r3tjl/N7DDC-ATU-100-mini-and-extended-boards/(list of files, drawings)

Other design files:
ATU_100_EXT_board/ATU_100_EXT_PCB_R3TJL/ATU-100_FS-мой с кнопками.lay6
ATU_100_mini_board/ATU-100_mini_PCB.lay6
