r3tjl/N7DDC-ATU-100-mini-and-extended-boards/ATU_100_EXT_board/FirmWare_PIC16F1938/R3TJL_ 1938_EXT_board_sources_V_3.4/main.asm

_correction:

;main.h,42 :: 		int correction(int input) {
;main.h,44 :: 		if(input <= 80) return 0;
	MOVLW      128
	MOVWF      R0
	MOVLW      128
	XORWF      FARG_correction_input+1, 0
	SUBWF      R0, 0
	BTFSS      STATUS+0, 2
	GOTO       L__correction547
	MOVF       FARG_correction_input+0, 0
	SUBLW      80
L__correction547:
	BTFSS      STATUS+0, 0
	GOTO       L_correction0
	CLRF       R0
	CLRF       R1
	GOTO       L_end_correction
L_correction0:
;main.h,45 :: 		if(input <= 171) input += 244;
	MOVLW      128
	MOVWF      R0
	MOVLW      128
	XORWF      FARG_correction_input+1, 0
	SUBWF      R0, 0
	BTFSS      STATUS+0, 2
	GOTO       L__correction548
	MOVF       FARG_correction_input+0, 0
	SUBLW      171
L__correction548:
	BTFSS      STATUS+0, 0
	GOTO       L_correction1
	MOVLW      244
	ADDWF      FARG_correction_input+0, 1
	MOVLW      0
	ADDWFC     FARG_correction_input+1, 1
	GOTO       L_correction2
L_correction1:
;main.h,46 :: 		else if(input <= 328) input += 254;
	MOVLW      128
	XORLW      1
	MOVWF      R0
	MOVLW      128
	XORWF      FARG_correction_input+1, 0
	SUBWF      R0, 0
	BTFSS      STATUS+0, 2
	GOTO       L__correction549
	MOVF       FARG_correction_input+0, 0
	SUBLW      72
L__correction549:
	BTFSS      STATUS+0, 0
	GOTO       L_correction3
	MOVLW      254
	ADDWF      FARG_correction_input+0, 1
	MOVLW      0
	ADDWFC     FARG_correction_input+1, 1
	GOTO       L_correction4
L_correction3:
;main.h,47 :: 		else if(input <= 582) input += 280;
	MOVLW      128
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
	BTFSS      STATUS+0, 0
	GOTO       L_correction21
	MOVLW      32
	ADDWF      FARG_correction_input+0, 1
	MOVLW      3
	ADDWFC     FARG_correction_input+1, 1
	GOTO       L_correction22
L_correction21:
;main.h,56 :: 		else if(input <= 10500) input += 840;
	MOVLW      128
	XORLW      41
	MOVWF      R0
	MOVLW      128
	XORWF      FARG_correction_input+1, 0
	SUBWF      R0, 0
	BTFSS      STATUS+0, 2
	GOTO       L__correction559
	MOVF       FARG_correction_input+0, 0
	SUBLW      4
L__correction559:
	BTFSS      STATUS+0, 0
	GOTO       L_correction23
	MOVLW      72
	ADDWF      FARG_correction_input+0, 1
	MOVLW      3
	ADDWFC     FARG_correction_input+1, 1
	GOTO       L_correction24
L_correction23:
;main.h,57 :: 		else  input += 860;
	MOVLW      92
	ADDWF      FARG_correction_input+0, 1
	MOVLW      3
	ADDWFC     FARG_correction_input+1, 1
L_correction24:
L_correction22:
L_correction20:
L_correction18:
L_correction16:
L_correction14:
L_correction12:
L_correction10:
L_correction8:
L_correction6:
L_correction4:
L_correction2:
;main.h,59 :: 		return input;
	MOVF       FARG_correction_input+0, 0
	MOVWF      R0
	MOVF       FARG_correction_input+1, 0
	MOVWF      R1
;main.h,60 :: 		}
L_end_correction:
	RETURN
; end of _correction

_get_reverse:

;main.h,64 :: 		int get_reverse() {
;main.h,66 :: 		FVRCON = 0b10000001; // ADC 1024 vmV Vref
	MOVLW      129
	MOVWF      FVRCON+0
;main.h,67 :: 		while(FVRCON.B6 == 0);
L_get_reverse25:
	BTFSC      FVRCON+0, 6
	GOTO       L_get_reverse26
	GOTO       L_get_reverse25
L_get_reverse26:
;main.h,68 :: 		Reverse = ADC_Get_Sample(0);
	CLRF       FARG_ADC_Get_Sample_channel+0
	CALL       _ADC_Get_Sample+0
	MOVF       R0, 0
	MOVWF      get_reverse_Reverse_L0+0
	MOVF       R1, 0
	MOVWF      get_reverse_Reverse_L0+1
;main.h,69 :: 		if(Reverse <= 1000) return Reverse;
	MOVLW      128
	XORLW      3
	MOVWF      R2
	MOVLW      128
	XORWF      R1, 0
	SUBWF      R2, 0
	BTFSS      STATUS+0, 2
	GOTO       L__get_reverse561
	MOVF       R0, 0
	SUBLW      232
L__get_reverse561:
	BTFSS      STATUS+0, 0
	GOTO       L_get_reverse27
	MOVF       get_reverse_Reverse_L0+0, 0
	MOVWF      R0
	MOVF       get_reverse_Reverse_L0+1, 0
	MOVWF      R1
	GOTO       L_end_get_reverse
L_get_reverse27:
;main.h,70 :: 		FVRCON = 0b10000010; // ADC 2048 vmV Vref
	MOVLW      130
	MOVWF      FVRCON+0
;main.h,71 :: 		while(FVRCON.B6 == 0);
L_get_reverse28:
	BTFSC      FVRCON+0, 6
	GOTO       L_get_reverse29
	GOTO       L_get_reverse28
L_get_reverse29:
;main.h,72 :: 		Reverse = ADC_Get_Sample(0);
	CLRF       FARG_ADC_Get_Sample_channel+0
	CALL       _ADC_Get_Sample+0
	MOVF       R0, 0
	MOVWF      get_reverse_Reverse_L0+0
	MOVF       R1, 0
	MOVWF      get_reverse_Reverse_L0+1
;main.h,73 :: 		if(Reverse <= 1000) return Reverse * 2;
	MOVLW      128
	XORLW      3
	MOVWF      R2
	MOVLW      128
	XORWF      R1, 0
	SUBWF      R2, 0
	BTFSS      STATUS+0, 2
	GOTO       L__get_reverse562
	MOVF       R0, 0
	SUBLW      232
L__get_reverse562:
	BTFSS      STATUS+0, 0
	GOTO       L_get_reverse30
	MOVF       get_reverse_Reverse_L0+0, 0
	MOVWF      R0
	MOVF       get_reverse_Reverse_L0+1, 0
	MOVWF      R1
	LSLF       R0, 1
	RLF        R1, 1
	GOTO       L_end_get_reverse
L_get_reverse30:
;main.h,74 :: 		FVRCON = 0b10000011; // ADC 4096 vmV Vref
	MOVLW      131
	MOVWF      FVRCON+0
;main.h,75 :: 		while(FVRCON.B6 == 0);
L_get_reverse31:
	BTFSC      FVRCON+0, 6
	GOTO       L_get_reverse32
	GOTO       L_get_reverse31
L_get_reverse32:
;main.h,76 :: 		Reverse = ADC_Get_Sample(0);
	CLRF       FARG_ADC_Get_Sample_channel+0
	CALL       _ADC_Get_Sample+0
	MOVF       R0, 0
	MOVWF      get_reverse_Reverse_L0+0
	MOVF       R1, 0
	MOVWF      get_reverse_Reverse_L0+1
;main.h,77 :: 		return Reverse * 4;
	MOVF       R0, 0
	MOVWF      R2
	MOVF       R1, 0
	MOVWF      R3
	LSLF       R2, 1
	RLF        R3, 1
	LSLF       R2, 1
	RLF        R3, 1
	MOVF       R2, 0
	MOVWF      R0
	MOVF       R3, 0
	MOVWF      R1
;main.h,78 :: 		}
L_end_get_reverse:
	RETURN
; end of _get_reverse

_get_forward:

;main.h,81 :: 		int get_forward() {
;main.h,83 :: 		FVRCON = 0b10000001; // ADC 1024 vmV Vref
	MOVLW      129
	MOVWF      FVRCON+0
;main.h,84 :: 		while(FVRCON.B6 == 0);
L_get_forward33:
	BTFSC      FVRCON+0, 6
	GOTO       L_get_forward34
	GOTO       L_get_forward33
L_get_forward34:
;main.h,85 :: 		Forward = ADC_Get_Sample(1);
	MOVLW      1
	MOVWF      FARG_ADC_Get_Sample_channel+0
	CALL       _ADC_Get_Sample+0
	MOVF       R0, 0
	MOVWF      get_forward_Forward_L0+0
	MOVF       R1, 0
	MOVWF      get_forward_Forward_L0+1
;main.h,86 :: 		if(Forward <= 1000) return Forward;
	MOVLW      128
	XORLW      3
	MOVWF      R2
	MOVLW      128
	XORWF      R1, 0
	SUBWF      R2, 0
	BTFSS      STATUS+0, 2
	GOTO       L__get_forward564
	MOVF       R0, 0
	SUBLW      232
L__get_forward564:
	BTFSS      STATUS+0, 0
	GOTO       L_get_forward35
	MOVF       get_forward_Forward_L0+0, 0
	MOVWF      R0
	MOVF       get_forward_Forward_L0+1, 0
	MOVWF      R1
	GOTO       L_end_get_forward
L_get_forward35:
;main.h,87 :: 		FVRCON = 0b10000010; // ADC 2048 vmV Vref
	MOVLW      130
	MOVWF      FVRCON+0
;main.h,88 :: 		while(FVRCON.B6 == 0);
L_get_forward36:
	BTFSC      FVRCON+0, 6
	GOTO       L_get_forward37
	GOTO       L_get_forward36
L_get_forward37:
;main.h,89 :: 		Forward = ADC_Get_Sample(1);
	MOVLW      1
	MOVWF      FARG_ADC_Get_Sample_channel+0
	CALL       _ADC_Get_Sample+0
	MOVF       R0, 0
	MOVWF      get_forward_Forward_L0+0
	MOVF       R1, 0
	MOVWF      get_forward_Forward_L0+1
;main.h,90 :: 		if(Forward <= 1000) return Forward * 2;
	MOVLW      128
	XORLW      3
	MOVWF      R2
	MOVLW      128
	XORWF      R1, 0
	SUBWF      R2, 0
	BTFSS      STATUS+0, 2
	GOTO       L__get_forward565
	MOVF       R0, 0
	SUBLW      232
L__get_forward565:
	BTFSS      STATUS+0, 0
	GOTO       L_get_forward38
	MOVF       get_forward_Forward_L0+0, 0
	MOVWF      R0
	MOVF       get_forward_Forward_L0+1, 0
	MOVWF      R1
	LSLF       R0, 1
	RLF        R1, 1
	GOTO       L_end_get_forward
L_get_forward38:
;main.h,91 :: 		FVRCON = 0b10000011; // ADC 4096 vmV Vref
	MOVLW      131
	MOVWF      FVRCON+0
;main.h,92 :: 		while(FVRCON.B6 == 0);
L_get_forward39:
	BTFSC      FVRCON+0, 6
	GOTO       L_get_forward40
	GOTO       L_get_forward39
L_get_forward40:
;main.h,93 :: 		Forward = ADC_Get_Sample(1);
	MOVLW      1
	MOVWF      FARG_ADC_Get_Sample_channel+0
	CALL       _ADC_Get_Sample+0
	MOVF       R0, 0
	MOVWF      get_forward_Forward_L0+0
	MOVF       R1, 0
	MOVWF      get_forward_Forward_L0+1
;main.h,94 :: 		if(Forward == 1024) Overload = 1;
	MOVF       R1, 0
	XORLW      4
	BTFSS      STATUS+0, 2
	GOTO       L__get_forward566
	MOVLW      0
	XORWF      R0, 0
L__get_forward566:
	BTFSS      STATUS+0, 2
	GOTO       L_get_forward41
	MOVLW      1
	MOVWF      main_Overload+0
	GOTO       L_get_forward42
L_get_forward41:
;main.h,95 :: 		else Overload = 0;
	CLRF       main_Overload+0
L_get_forward42:
;main.h,96 :: 		return Forward * 4;
	MOVF       get_forward_Forward_L0+0, 0
	MOVWF      R0
	MOVF       get_forward_Forward_L0+1, 0
	MOVWF      R1
	LSLF       R0, 1
	RLF        R1, 1
	LSLF       R0, 1
	RLF        R1, 1
;main.h,97 :: 		}
L_end_get_forward:
	RETURN
; end of _get_forward

_get_pwr:

;main.h,99 :: 		void get_pwr() {
;main.h,102 :: 		asm CLRWDT;
	CLRWDT
;main.h,104 :: 		Forward = get_forward();
	CALL       _get_forward+0
	MOVF       R0, 0
	MOVWF      get_pwr_Forward_L0+0
	MOVF       R1, 0
	MOVWF      get_pwr_Forward_L0+1
	MOVLW      0
	BTFSC      get_pwr_Forward_L0+1, 7
	MOVLW      255
	MOVWF      get_pwr_Forward_L0+2
	MOVWF      get_pwr_Forward_L0+3
;main.h,105 :: 		Reverse = get_reverse();
	CALL       _get_reverse+0
	MOVF       R0, 0
	MOVWF      get_pwr_Reverse_L0+0
	MOVF       R1, 0
	MOVWF      get_pwr_Reverse_L0+1
	MOVLW      0
	BTFSC      get_pwr_Reverse_L0+1, 7
	MOVLW      255
	MOVWF      get_pwr_Reverse_L0+2
	MOVWF      get_pwr_Reverse_L0+3
;main.h,106 :: 		if(D_correction==1) p = correction(Forward * 3);
	MOVF       main_D_correction+0, 0
	XORLW      1
	BTFSS      STATUS+0, 2
	GOTO       L_get_pwr43
	MOVF       get_pwr_Forward_L0+0, 0
	MOVWF      R0
	MOVF       get_pwr_Forward_L0+1, 0
	MOVWF      R1
	MOVLW      3
	MOVWF      R4
	MOVLW      0
	MOVWF      R5
	CALL       _Mul_16x16_U+0
	MOVF       R0, 0
	MOVWF      FARG_correction_input+0
	MOVF       R1, 0
	MOVWF      FARG_correction_input+1
	CALL       _correction+0
	CALL       _Int2Double+0
	MOVF       R0, 0
	MOVWF      get_pwr_p_L0+0
	MOVF       R1, 0
	MOVWF      get_pwr_p_L0+1
	MOVF       R2, 0
	MOVWF      get_pwr_p_L0+2
	MOVF       R3, 0
	MOVWF      get_pwr_p_L0+3
	GOTO       L_get_pwr44
L_get_pwr43:
;main.h,107 :: 		else p = Forward * 3;
	MOVF       get_pwr_Forward_L0+0, 0
	MOVWF      R0
	MOVF       get_pwr_Forward_L0+1, 0
	MOVWF      R1
	MOVF       get_pwr_Forward_L0+2, 0
	MOVWF      R2
	MOVF       get_pwr_Forward_L0+3, 0
	MOVWF      R3
	MOVLW      3
	MOVWF      R4
	CLRF       R5
	CLRF       R6
	CLRF       R7
	CALL       _Mul_32x32_U+0
	CALL       _Longint2Double+0
	MOVF       R0, 0
	MOVWF      get_pwr_p_L0+0
	MOVF       R1, 0
	MOVWF      get_pwr_p_L0+1
	MOVF       R2, 0
	MOVWF      get_pwr_p_L0+2
	MOVF       R3, 0
	MOVWF      get_pwr_p_L0+3
L_get_pwr44:
;main.h,109 :: 		if(Reverse >= Forward)
	MOVLW      128
	XORWF      get_pwr_Reverse_L0+3, 0
	MOVWF      R0
	MOVLW      128
	XORWF      get_pwr_Forward_L0+3, 0
	SUBWF      R0, 0
	BTFSS      STATUS+0, 2
	GOTO       L__get_pwr568
	MOVF       get_pwr_Forward_L0+2, 0
	SUBWF      get_pwr_Reverse_L0+2, 0
	BTFSS      STATUS+0, 2
	GOTO       L__get_pwr568
	MOVF       get_pwr_Forward_L0+1, 0
	SUBWF      get_pwr_Reverse_L0+1, 0
	BTFSS      STATUS+0, 2
	GOTO       L__get_pwr568
	MOVF       get_pwr_Forward_L0+0, 0
	SUBWF      get_pwr_Reverse_L0+0, 0
L__get_pwr568:
	BTFSS      STATUS+0, 0
	GOTO       L_get_pwr45
;main.h,110 :: 		Forward = 999;
	MOVLW      231
	MOVWF      get_pwr_Forward_L0+0
	MOVLW      3
	MOVWF      get_pwr_Forward_L0+1
	CLRF       get_pwr_Forward_L0+2
	CLRF       get_pwr_Forward_L0+3
	GOTO       L_get_pwr46
L_get_pwr45:
;main.h,112 :: 		Forward = ((Forward + Reverse) * 100) / (Forward - Reverse);
	MOVF       get_pwr_Reverse_L0+0, 0
	ADDWF      get_pwr_Forward_L0+0, 0
	MOVWF      R0
	MOVF       get_pwr_Reverse_L0+1, 0
	ADDWFC     get_pwr_Forward_L0+1, 0
	MOVWF      R1
	MOVF       get_pwr_Reverse_L0+2, 0
	ADDWFC     get_pwr_Forward_L0+2, 0
	MOVWF      R2
	MOVF       get_pwr_Reverse_L0+3, 0
	ADDWFC     get_pwr_Forward_L0+3, 0
	MOVWF      R3
	MOVLW      100
	MOVWF      R4
	CLRF       R5
	CLRF       R6
	CLRF       R7
	CALL       _Mul_32x32_U+0
	MOVF       get_pwr_Forward_L0+0, 0
	MOVWF      R4
	MOVF       get_pwr_Forward_L0+1, 0
	MOVWF      R5
	MOVF       get_pwr_Forward_L0+2, 0
	MOVWF      R6
	MOVF       get_pwr_Forward_L0+3, 0
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
	MOVWF      R7
	CALL       _Add_32x32_FP+0
	MOVF       R0, 0
	MOVWF      get_pwr_p_L0+0
	MOVF       R1, 0
	MOVWF      get_pwr_p_L0+1
	MOVF       R2, 0
	MOVWF      get_pwr_p_L0+2
	MOVF       R3, 0
	MOVWF      get_pwr_p_L0+3
;main.h,122 :: 		PWR = p;
	CALL       _Double2Int+0
	MOVF       R0, 0
	MOVWF      _PWR+0
	MOVF       R1, 0
	MOVWF      _PWR+1
;main.h,123 :: 		if(PWR<10) SWR = 1;
	MOVLW      128
	XORWF      R1, 0
	MOVWF      R2
	MOVLW      128
	SUBWF      R2, 0
	BTFSS      STATUS+0, 2
	GOTO       L__get_pwr570
	MOVLW      10
	SUBWF      R0, 0
L__get_pwr570:
	BTFSC      STATUS+0, 0
	GOTO       L_get_pwr50
	MOVLW      1
	MOVWF      _SWR+0
	MOVLW      0
	MOVWF      _SWR+1
	GOTO       L_get_pwr51
L_get_pwr50:
;main.h,124 :: 		else if(Forward<100) SWR = 999;
	MOVLW      128
	XORWF      get_pwr_Forward_L0+3, 0
	MOVWF      R0
	MOVLW      128
	SUBWF      R0, 0
	BTFSS      STATUS+0, 2
	GOTO       L__get_pwr571
	MOVLW      0
	SUBWF      get_pwr_Forward_L0+2, 0
	BTFSS      STATUS+0, 2
	GOTO       L__get_pwr571
	MOVLW      0
	SUBWF      get_pwr_Forward_L0+1, 0
	BTFSS      STATUS+0, 2
	GOTO       L__get_pwr571
	MOVLW      100
	SUBWF      get_pwr_Forward_L0+0, 0
L__get_pwr571:
	BTFSC      STATUS+0, 0
	GOTO       L_get_pwr52
	MOVLW      231
	MOVWF      _SWR+0
	MOVLW      3
	MOVWF      _SWR+1
	GOTO       L_get_pwr53
L_get_pwr52:
;main.h,125 :: 		else SWR = Forward;
	MOVF       get_pwr_Forward_L0+0, 0
	MOVWF      _SWR+0
	MOVF       get_pwr_Forward_L0+1, 0
	MOVWF      _SWR+1
L_get_pwr53:
L_get_pwr51:
;main.h,126 :: 		return;
;main.h,127 :: 		}
L_end_get_pwr:
	RETURN
; end of _get_pwr

_get_swr:

;main.h,129 :: 		void get_swr() {
;main.h,130 :: 		get_pwr();
	CALL       _get_pwr+0
;main.h,131 :: 		if(p_cnt!=100) {
	MOVF       _p_cnt+0, 0
	XORLW      100
	BTFSC      STATUS+0, 2
	GOTO       L_get_swr54
;main.h,132 :: 		p_cnt += 1;
	INCF       _p_cnt+0, 1
;main.h,133 :: 		if(PWR>P_max) P_max = PWR;
	MOVLW      128
	XORWF      _P_max+1, 0
	MOVWF      R0
	MOVLW      128
	XORWF      _PWR+1, 0
	SUBWF      R0, 0
	BTFSS      STATUS+0, 2
	GOTO       L__get_swr573
	MOVF       _PWR+0, 0
	SUBWF      _P_max+0, 0
L__get_swr573:
	BTFSC      STATUS+0, 0
	GOTO       L_get_swr55
	MOVF       _PWR+0, 0
	MOVWF      _P_max+0
	MOVF       _PWR+1, 0
	MOVWF      _P_max+1
L_get_swr55:
;main.h,134 :: 		}
	GOTO       L_get_swr56
L_get_swr54:
;main.h,136 :: 		p_cnt = 0;
	CLRF       _p_cnt+0
;main.h,137 :: 		show_pwr(P_max, SWR);
	MOVF       _P_max+0, 0
	MOVWF      FARG_show_pwr+0
	MOVF       _P_max+1, 0
	MOVWF      FARG_show_pwr+1
	MOVF       _SWR+0, 0
	MOVWF      FARG_show_pwr+0
	MOVF       _SWR+1, 0
	MOVWF      FARG_show_pwr+1
	CALL       _show_pwr+0
;main.h,138 :: 		P_max = 0;
	CLRF       _P_max+0
	CLRF       _P_max+1
;main.h,139 :: 		}
L_get_swr56:
;main.h,140 :: 		while(PWR<min_for_start | (PWR> max_for_start & max_for_start>0)) {  // waiting for good power
L_get_swr57:
	MOVLW      128
	XORWF      _PWR+1, 0
	MOVWF      R2
	MOVLW      128
	XORWF      main_min_for_start+1, 0
	SUBWF      R2, 0
	BTFSS      STATUS+0, 2
	GOTO       L__get_swr574
	MOVF       main_min_for_start+0, 0
	SUBWF      _PWR+0, 0
L__get_swr574:
	MOVLW      1
	BTFSC      STATUS+0, 0
	MOVLW      0
	MOVWF      R2
	MOVLW      128
	XORWF      main_max_for_start+1, 0
	MOVWF      R1
	MOVLW      128
	XORWF      _PWR+1, 0
	SUBWF      R1, 0
	BTFSS      STATUS+0, 2
	GOTO       L__get_swr575
	MOVF       _PWR+0, 0
	SUBWF      main_max_for_start+0, 0
L__get_swr575:
	MOVLW      1
	BTFSC      STATUS+0, 0
	MOVLW      0
	MOVWF      R1
	MOVLW      128
	MOVWF      R0
	MOVLW      128
	XORWF      main_max_for_start+1, 0
	SUBWF      R0, 0
	BTFSS      STATUS+0, 2
	GOTO       L__get_swr576
	MOVF       main_max_for_start+0, 0
	SUBLW      0
L__get_swr576:
	MOVLW      1
	BTFSC      STATUS+0, 0
	MOVLW      0
	MOVWF      R0
	MOVF       R1, 0
	ANDWF      R0, 1
	MOVF       R2, 0
	IORWF       R0, 1
	BTFSC      STATUS+0, 2
	GOTO       L_get_swr58
;main.h,141 :: 		asm CLRWDT;
	CLRWDT
;main.h,142 :: 		get_pwr();
	CALL       _get_pwr+0
;main.h,143 :: 		if(p_cnt!=100) {
	MOVF       _p_cnt+0, 0
	XORLW      100
	BTFSC      STATUS+0, 2
	GOTO       L_get_swr59
;main.h,144 :: 		p_cnt += 1;
	INCF       _p_cnt+0, 1
;main.h,145 :: 		if(PWR>P_max) P_max = PWR;
	MOVLW      128
	XORWF      _P_max+1, 0
	MOVWF      R0
	MOVLW      128
	XORWF      _PWR+1, 0
	SUBWF      R0, 0
	BTFSS      STATUS+0, 2
	GOTO       L__get_swr577
	MOVF       _PWR+0, 0
	SUBWF      _P_max+0, 0
L__get_swr577:
	BTFSC      STATUS+0, 0
	GOTO       L_get_swr60
	MOVF       _PWR+0, 0
	MOVWF      _P_max+0
	MOVF       _PWR+1, 0
	MOVWF      _P_max+1
L_get_swr60:
;main.h,146 :: 		}
	GOTO       L_get_swr61
L_get_swr59:
;main.h,148 :: 		p_cnt = 0;
	CLRF       _p_cnt+0
;main.h,149 :: 		show_pwr(P_max, SWR);
	MOVF       _P_max+0, 0
	MOVWF      FARG_show_pwr+0
	MOVF       _P_max+1, 0
	MOVWF      FARG_show_pwr+1
	MOVF       _SWR+0, 0
	MOVWF      FARG_show_pwr+0
	MOVF       _SWR+1, 0
	MOVWF      FARG_show_pwr+1
	CALL       _show_pwr+0
;main.h,150 :: 		P_max = 0;
	CLRF       _P_max+0
	CLRF       _P_max+1
;main.h,151 :: 		}
L_get_swr61:
;main.h,153 :: 		if(Button(&PORTB, 0, 5, 1)) rready = 1;
	MOVLW      PORTB+0
	MOVWF      FARG_Button_port+0
	MOVLW      hi_addr(PORTB+0)
	MOVWF      FARG_Button_port+1
	CLRF       FARG_Button_pin+0
	MOVLW      5
	MOVWF      FARG_Button_time_ms+0
	MOVLW      1
	MOVWF      FARG_Button_active_state+0
	CALL       _Button+0
	MOVF       R0, 0
	BTFSC      STATUS+0, 2
	GOTO       L_get_swr62
	MOVLW      1
	MOVWF      _rready+0
L_get_swr62:
;main.h,154 :: 		if(rready==1 & Button(&PORTB, 0, 5, 0)) { //  press button  Tune
	MOVF       _rready+0, 0
	XORLW      1
	MOVLW      1
	BTFSS      STATUS+0, 2
	MOVLW      0
	MOVWF      FLOC__get_swr+0
	MOVLW      PORTB+0
	MOVWF      FARG_Button_port+0
	MOVLW      hi_addr(PORTB+0)
	MOVWF      FARG_Button_port+1
	CLRF       FARG_Button_pin+0
	MOVLW      5
	MOVWF      FARG_Button_time_ms+0
	CLRF       FARG_Button_active_state+0
	CALL       _Button+0
	MOVF       FLOC__get_swr+0, 0
	ANDWF      R0, 1
	BTFSC      STATUS+0, 2
	GOTO       L_get_swr63
;main.h,155 :: 		show_reset();
	CALL       _show_reset+0
;main.h,156 :: 		SWR = 0;
	CLRF       _SWR+0
	CLRF       _SWR+1
;main.h,157 :: 		return;
	GOTO       L_end_get_swr
;main.h,158 :: 		}
L_get_swr63:
;main.h,159 :: 		} //  good power
	GOTO       L_get_swr57
L_get_swr58:
;main.h,160 :: 		return;
;main.h,161 :: 		}
L_end_get_swr:
	RETURN
; end of _get_swr

_set_ind:

;main.h,163 :: 		void set_ind(char Ind) {  // 0 - 31
;main.h,164 :: 		if(L_invert == 0) {
	MOVF       main_L_invert+0, 0
	XORLW      0
	BTFSS      STATUS+0, 2
	GOTO       L_set_ind64
;main.h,165 :: 		Ind_005 = Ind.B0;
	BTFSC      FARG_set_ind_Ind+0, 0
	GOTO       L__set_ind579
	BCF        LATB3_bit+0, BitPos(LATB3_bit+0)
	GOTO       L__set_ind580
L__set_ind579:
	BSF        LATB3_bit+0, BitPos(LATB3_bit+0)
L__set_ind580:
;main.h,166 :: 		Ind_011 = Ind.B1;
	BTFSC      FARG_set_ind_Ind+0, 1
	GOTO       L__set_ind581
	BCF        LATA2_bit+0, BitPos(LATA2_bit+0)
	GOTO       L__set_ind582
L__set_ind581:
	BSF        LATA2_bit+0, BitPos(LATA2_bit+0)
L__set_ind582:
;main.h,167 :: 		Ind_022 = Ind.B2;
	BTFSC      FARG_set_ind_Ind+0, 2
	GOTO       L__set_ind583
	BCF        LATB4_bit+0, BitPos(LATB4_bit+0)
	GOTO       L__set_ind584
L__set_ind583:
	BSF        LATB4_bit+0, BitPos(LATB4_bit+0)
L__set_ind584:
;main.h,168 :: 		Ind_045 = Ind.B3;
	BTFSC      FARG_set_ind_Ind+0, 3
	GOTO       L__set_ind585
	BCF        LATA3_bit+0, BitPos(LATA3_bit+0)
	GOTO       L__set_ind586
L__set_ind585:
	BSF        LATA3_bit+0, BitPos(LATA3_bit+0)
L__set_ind586:
;main.h,169 :: 		Ind_1   = Ind.B4;
	BTFSC      FARG_set_ind_Ind+0, 4
	GOTO       L__set_ind587
	BCF        LATB5_bit+0, BitPos(LATB5_bit+0)
	GOTO       L__set_ind588
L__set_ind587:
	BSF        LATB5_bit+0, BitPos(LATB5_bit+0)
L__set_ind588:
;main.h,170 :: 		Ind_22  = Ind.B5;
	BTFSC      FARG_set_ind_Ind+0, 5
	GOTO       L__set_ind589
	BCF        LATA5_bit+0, BitPos(LATA5_bit+0)
	GOTO       L__set_ind590
L__set_ind589:
	BSF        LATA5_bit+0, BitPos(LATA5_bit+0)
L__set_ind590:
;main.h,171 :: 		Ind_45  = Ind.B6;
	BTFSC      FARG_set_ind_Ind+0, 6
	GOTO       L__set_ind591
	BCF        LATA4_bit+0, BitPos(LATA4_bit+0)
	GOTO       L__set_ind592
L__set_ind591:
	BSF        LATA4_bit+0, BitPos(LATA4_bit+0)
L__set_ind592:
;main.h,173 :: 		}
	GOTO       L_set_ind65
L_set_ind64:
;main.h,175 :: 		Ind_005 = ~Ind.B0;
	BTFSC      FARG_set_ind_Ind+0, 0
	GOTO       L__set_ind593
	BSF        LATB3_bit+0, BitPos(LATB3_bit+0)
	GOTO       L__set_ind594
L__set_ind593:
	BCF        LATB3_bit+0, BitPos(LATB3_bit+0)
L__set_ind594:
;main.h,176 :: 		Ind_011 = ~Ind.B1;
	BTFSC      FARG_set_ind_Ind+0, 1
	GOTO       L__set_ind595
	BSF        LATA2_bit+0, BitPos(LATA2_bit+0)
	GOTO       L__set_ind596
L__set_ind595:
	BCF        LATA2_bit+0, BitPos(LATA2_bit+0)
L__set_ind596:
;main.h,177 :: 		Ind_022 = ~Ind.B2;
	BTFSC      FARG_set_ind_Ind+0, 2
	GOTO       L__set_ind597
	BSF        LATB4_bit+0, BitPos(LATB4_bit+0)
	GOTO       L__set_ind598
L__set_ind597:
	BCF        LATB4_bit+0, BitPos(LATB4_bit+0)
L__set_ind598:
;main.h,178 :: 		Ind_045 = ~Ind.B3;
	BTFSC      FARG_set_ind_Ind+0, 3
	GOTO       L__set_ind599
	BSF        LATA3_bit+0, BitPos(LATA3_bit+0)
	GOTO       L__set_ind600
L__set_ind599:
	BCF        LATA3_bit+0, BitPos(LATA3_bit+0)
L__set_ind600:
;main.h,179 :: 		Ind_1   = ~Ind.B4;
	BTFSC      FARG_set_ind_Ind+0, 4
	GOTO       L__set_ind601
	BSF        LATB5_bit+0, BitPos(LATB5_bit+0)
	GOTO       L__set_ind602
L__set_ind601:
	BCF        LATB5_bit+0, BitPos(LATB5_bit+0)
L__set_ind602:
;main.h,180 :: 		Ind_22  = ~Ind.B5;
	BTFSC      FARG_set_ind_Ind+0, 5
	GOTO       L__set_ind603
	BSF        LATA5_bit+0, BitPos(LATA5_bit+0)
	GOTO       L__set_ind604
L__set_ind603:
	BCF        LATA5_bit+0, BitPos(LATA5_bit+0)
L__set_ind604:
;main.h,181 :: 		Ind_45  = ~Ind.B6;
	BTFSC      FARG_set_ind_Ind+0, 6
	GOTO       L__set_ind605
	BSF        LATA4_bit+0, BitPos(LATA4_bit+0)
	GOTO       L__set_ind606
L__set_ind605:
	BCF        LATA4_bit+0, BitPos(LATA4_bit+0)
L__set_ind606:
;main.h,183 :: 		}
L_set_ind65:
;main.h,184 :: 		Vdelay_ms(Rel_Del);
	MOVF       main_Rel_Del+0, 0
	MOVWF      FARG_VDelay_ms_Time_ms+0
	MOVF       main_Rel_Del+1, 0
	MOVWF      FARG_VDelay_ms_Time_ms+1
	CALL       _VDelay_ms+0
;main.h,185 :: 		}
L_end_set_ind:
	RETURN
; end of _set_ind

_set_cap:

;main.h,187 :: 		void set_cap(char Cap) { // 0 - 31
;main.h,188 :: 		Cap_10  =  Cap.B0;
	BTFSC      FARG_set_cap_Cap+0, 0
	GOTO       L__set_cap608
	BCF        LATC7_bit+0, BitPos(LATC7_bit+0)
	GOTO       L__set_cap609
L__set_cap608:
	BSF        LATC7_bit+0, BitPos(LATC7_bit+0)
L__set_cap609:
;main.h,189 :: 		Cap_22  =  Cap.B1;
	BTFSC      FARG_set_cap_Cap+0, 1
	GOTO       L__set_cap610
	BCF        LATC3_bit+0, BitPos(LATC3_bit+0)
	GOTO       L__set_cap611
L__set_cap610:
	BSF        LATC3_bit+0, BitPos(LATC3_bit+0)
L__set_cap611:
;main.h,190 :: 		Cap_47  =  Cap.B2;
	BTFSC      FARG_set_cap_Cap+0, 2
	GOTO       L__set_cap612
	BCF        LATC6_bit+0, BitPos(LATC6_bit+0)
	GOTO       L__set_cap613
L__set_cap612:
	BSF        LATC6_bit+0, BitPos(LATC6_bit+0)
L__set_cap613:
;main.h,191 :: 		Cap_100 =  Cap.B3;
	BTFSC      FARG_set_cap_Cap+0, 3
	GOTO       L__set_cap614
	BCF        LATC2_bit+0, BitPos(LATC2_bit+0)
	GOTO       L__set_cap615
L__set_cap614:
	BSF        LATC2_bit+0, BitPos(LATC2_bit+0)
L__set_cap615:
;main.h,192 :: 		Cap_220 =  Cap.B4;
	BTFSC      FARG_set_cap_Cap+0, 4
	GOTO       L__set_cap616
	BCF        LATC5_bit+0, BitPos(LATC5_bit+0)
	GOTO       L__set_cap617
L__set_cap616:
	BSF        LATC5_bit+0, BitPos(LATC5_bit+0)
L__set_cap617:
;main.h,193 :: 		Cap_470 =  Cap.B5;
	BTFSC      FARG_set_cap_Cap+0, 5
	GOTO       L__set_cap618
	BCF        LATC1_bit+0, BitPos(LATC1_bit+0)
	GOTO       L__set_cap619
L__set_cap618:
	BSF        LATC1_bit+0, BitPos(LATC1_bit+0)
L__set_cap619:
;main.h,194 :: 		Cap_1000 =  Cap.B6;
	BTFSC      FARG_set_cap_Cap+0, 6
	GOTO       L__set_cap620
	BCF        LATC4_bit+0, BitPos(LATC4_bit+0)
	GOTO       L__set_cap621
L__set_cap620:
	BSF        LATC4_bit+0, BitPos(LATC4_bit+0)
L__set_cap621:
;main.h,196 :: 		Vdelay_ms(Rel_Del);
	MOVF       main_Rel_Del+0, 0
	MOVWF      FARG_VDelay_ms_Time_ms+0
	MOVF       main_Rel_Del+1, 0
	MOVWF      FARG_VDelay_ms_Time_ms+1
	CALL       _VDelay_ms+0
;main.h,197 :: 		}
L_end_set_cap:
	RETURN
; end of _set_cap

_set_sw:

;main.h,199 :: 		void set_sw(char SW) {  // 0 - IN,  1 - OUT
;main.h,200 :: 		Cap_sw = SW;
	BTFSC      FARG_set_sw_SW+0, 0
	GOTO       L__set_sw623
	BCF        LATC0_bit+0, BitPos(LATC0_bit+0)
	GOTO       L__set_sw624
L__set_sw623:
	BSF        LATC0_bit+0, BitPos(LATC0_bit+0)
L__set_sw624:
;main.h,201 :: 		Vdelay_ms(Rel_Del);
	MOVF       main_Rel_Del+0, 0
	MOVWF      FARG_VDelay_ms_Time_ms+0
	MOVF       main_Rel_Del+1, 0
	MOVWF      FARG_VDelay_ms_Time_ms+1
	CALL       _VDelay_ms+0
;main.h,202 :: 		}
L_end_set_sw:
	RETURN
; end of _set_sw

_atu_reset:

;main.h,204 :: 		void atu_reset() {
;main.h,205 :: 		ind = 0;
	CLRF       main_ind+0
;main.h,206 :: 		cap = 0;
	CLRF       main_cap+0
;main.h,207 :: 		set_ind(ind);
	CLRF       FARG_set_ind_Ind+0
	CALL       _set_ind+0
;main.h,208 :: 		set_cap(cap);
	MOVF       main_cap+0, 0
	MOVWF      FARG_set_cap_Cap+0
	CALL       _set_cap+0
;main.h,209 :: 		Vdelay_ms(Rel_Del);
	MOVF       main_Rel_Del+0, 0
	MOVWF      FARG_VDelay_ms_Time_ms+0
	MOVF       main_Rel_Del+1, 0
	MOVWF      FARG_VDelay_ms_Time_ms+1
	CALL       _VDelay_ms+0
;main.h,210 :: 		}
L_end_atu_reset:
	RETURN
; end of _atu_reset

_coarse_cap:

;main.h,213 :: 		void coarse_cap() {
;main.h,214 :: 		char step = 3;
	MOVLW      3
	MOVWF      coarse_cap_step_L0+0
;main.h,218 :: 		cap = 0;
	CLRF       main_cap+0
;main.h,219 :: 		set_cap(cap);
	CLRF       FARG_set_cap_Cap+0
	CALL       _set_cap+0
;main.h,220 :: 		step_cap = step;
	MOVF       coarse_cap_step_L0+0, 0
	MOVWF      main_step_cap+0
;main.h,221 :: 		get_swr(); if(SWR==0) return;
	CALL       _get_swr+0
	MOVLW      0
	XORWF      _SWR+1, 0
	BTFSS      STATUS+0, 2
	GOTO       L__coarse_cap627
	MOVLW      0
	XORWF      _SWR+0, 0
L__coarse_cap627:
	BTFSS      STATUS+0, 2
	GOTO       L_coarse_cap66
	GOTO       L_end_coarse_cap
L_coarse_cap66:
;main.h,222 :: 		min_swr = SWR + SWR/20;
	MOVLW      20
	MOVWF      R4
	MOVLW      0
	MOVWF      R5
	MOVF       _SWR+0, 0
	MOVWF      R0
	MOVF       _SWR+1, 0
	MOVWF      R1
	CALL       _Div_16x16_S+0
	MOVF       R0, 0
	ADDWF      _SWR+0, 0
	MOVWF      coarse_cap_min_swr_L0+0
	MOVF       R1, 0
	ADDWFC     _SWR+1, 0
	MOVWF      coarse_cap_min_swr_L0+1
;main.h,223 :: 		for(count=step; count<=31;) {
	MOVF       coarse_cap_step_L0+0, 0
	MOVWF      coarse_cap_count_L0+0
L_coarse_cap67:
	MOVF       coarse_cap_count_L0+0, 0
	SUBLW      31
	BTFSS      STATUS+0, 0
	GOTO       L_coarse_cap68
;main.h,224 :: 		set_cap(count*C_mult);
	MOVF       coarse_cap_count_L0+0, 0
	MOVWF      R0
	MOVF       main_C_mult+0, 0
	MOVWF      R4
	CALL       _Mul_8x8_U+0
	MOVF       R0, 0
	MOVWF      FARG_set_cap_Cap+0
	CALL       _set_cap+0
;main.h,225 :: 		get_swr(); if(SWR==0) return;
	CALL       _get_swr+0
	MOVLW      0
	XORWF      _SWR+1, 0
	BTFSS      STATUS+0, 2
	GOTO       L__coarse_cap628
	MOVLW      0
	XORWF      _SWR+0, 0
L__coarse_cap628:
	BTFSS      STATUS+0, 2
	GOTO       L_coarse_cap70
	GOTO       L_end_coarse_cap
L_coarse_cap70:
;main.h,226 :: 		if(SWR < min_swr) {
	MOVLW      128
	XORWF      _SWR+1, 0
	MOVWF      R0
	MOVLW      128
	XORWF      coarse_cap_min_swr_L0+1, 0
	SUBWF      R0, 0
	BTFSS      STATUS+0, 2
	GOTO       L__coarse_cap629
	MOVF       coarse_cap_min_swr_L0+0, 0
	SUBWF      _SWR+0, 0
L__coarse_cap629:
	BTFSC      STATUS+0, 0
	GOTO       L_coarse_cap71
;main.h,227 :: 		min_swr = SWR + SWR/20;
	MOVLW      20
	MOVWF      R4
	MOVLW      0
	MOVWF      R5
	MOVF       _SWR+0, 0
	MOVWF      R0
	MOVF       _SWR+1, 0
	MOVWF      R1
	CALL       _Div_16x16_S+0
	MOVF       R0, 0
	ADDWF      _SWR+0, 0
	MOVWF      coarse_cap_min_swr_L0+0
	MOVF       R1, 0
	ADDWFC     _SWR+1, 0
	MOVWF      coarse_cap_min_swr_L0+1
;main.h,228 :: 		cap = count*C_mult;
	MOVF       coarse_cap_count_L0+0, 0
	MOVWF      R0
	MOVF       main_C_mult+0, 0
	MOVWF      R4
	CALL       _Mul_8x8_U+0
	MOVF       R0, 0
	MOVWF      main_cap+0
;main.h,229 :: 		step_cap = step;
	MOVF       coarse_cap_step_L0+0, 0
	MOVWF      main_step_cap+0
;main.h,230 :: 		if(SWR<120) break;
	MOVLW      128
	XORWF      _SWR+1, 0
	MOVWF      R0
	MOVLW      128
	SUBWF      R0, 0
	BTFSS      STATUS+0, 2
	GOTO       L__coarse_cap630
	MOVLW      120
	SUBWF      _SWR+0, 0
L__coarse_cap630:
	BTFSC      STATUS+0, 0
	GOTO       L_coarse_cap72
	GOTO       L_coarse_cap68
L_coarse_cap72:
;main.h,231 :: 		count +=step;
	MOVF       coarse_cap_step_L0+0, 0
	ADDWF      coarse_cap_count_L0+0, 0
	MOVWF      R2
	MOVF       R2, 0
	MOVWF      coarse_cap_count_L0+0
;main.h,232 :: 		if(C_linear==0 & count==9) count = 8;
	MOVF       main_C_linear+0, 0
	XORLW      0
	MOVLW      1
	BTFSS      STATUS+0, 2
	MOVLW      0
	MOVWF      R1
	MOVF       R2, 0
	XORLW      9
	MOVLW      1
	BTFSS      STATUS+0, 2
	MOVLW      0
	MOVWF      R0
	MOVF       R1, 0
	ANDWF      R0, 1
	BTFSC      STATUS+0, 2
	GOTO       L_coarse_cap73
	MOVLW      8
	MOVWF      coarse_cap_count_L0+0
	GOTO       L_coarse_cap74
L_coarse_cap73:
;main.h,233 :: 		else if(C_linear==0 & count==17) {count = 16; step = 4;}
	MOVF       main_C_linear+0, 0
	XORLW      0
	MOVLW      1
	BTFSS      STATUS+0, 2
	MOVLW      0
	MOVWF      R1
	MOVF       coarse_cap_count_L0+0, 0
	XORLW      17
	MOVLW      1
	BTFSS      STATUS+0, 2
	MOVLW      0
	MOVWF      R0
	MOVF       R1, 0
	ANDWF      R0, 1
	BTFSC      STATUS+0, 2
	GOTO       L_coarse_cap75
	MOVLW      16
	MOVWF      coarse_cap_count_L0+0
	MOVLW      4
	MOVWF      coarse_cap_step_L0+0
L_coarse_cap75:
L_coarse_cap74:
;main.h,234 :: 		}
	GOTO       L_coarse_cap76
L_coarse_cap71:
;main.h,235 :: 		else break;
	GOTO       L_coarse_cap68
L_coarse_cap76:
;main.h,236 :: 		}
	GOTO       L_coarse_cap67
L_coarse_cap68:
;main.h,237 :: 		set_cap(cap);
	MOVF       main_cap+0, 0
	MOVWF      FARG_set_cap_Cap+0
	CALL       _set_cap+0
;main.h,238 :: 		return;
;main.h,239 :: 		}
L_end_coarse_cap:
	RETURN
; end of _coarse_cap

_coarse_tune:

;main.h,241 :: 		void coarse_tune() {
;main.h,242 :: 		char step = 3;
	MOVLW      3
	MOVWF      coarse_tune_step_L0+0
;main.h,247 :: 		mem_cap = 0;
	CLRF       coarse_tune_mem_cap_L0+0
;main.h,248 :: 		step_ind = step;
	MOVF       coarse_tune_step_L0+0, 0
	MOVWF      main_step_ind+0
;main.h,249 :: 		mem_step_cap = 3;
	MOVLW      3
	MOVWF      coarse_tune_mem_step_cap_L0+0
;main.h,250 :: 		min_swr = SWR + SWR/20;
	MOVLW      20
	MOVWF      R4
	MOVLW      0
	MOVWF      R5
	MOVF       _SWR+0, 0
	MOVWF      R0
	MOVF       _SWR+1, 0
	MOVWF      R1
	CALL       _Div_16x16_S+0
	MOVF       R0, 0
	ADDWF      _SWR+0, 0
	MOVWF      coarse_tune_min_swr_L0+0
	MOVF       R1, 0
	ADDWFC     _SWR+1, 0
	MOVWF      coarse_tune_min_swr_L0+1
;main.h,251 :: 		for(count=0; count<=31;) {
	CLRF       coarse_tune_count_L0+0
L_coarse_tune77:
	MOVF       coarse_tune_count_L0+0, 0
	SUBLW      31
	BTFSS      STATUS+0, 0
	GOTO       L_coarse_tune78
;main.h,252 :: 		set_ind(count*L_mult);
	MOVF       coarse_tune_count_L0+0, 0
	MOVWF      R0
	MOVF       main_L_mult+0, 0
	MOVWF      R4
	CALL       _Mul_8x8_U+0
	MOVF       R0, 0
	MOVWF      FARG_set_ind_Ind+0
	CALL       _set_ind+0
;main.h,253 :: 		coarse_cap();
	CALL       _coarse_cap+0
;main.h,254 :: 		get_swr();  if(SWR==0) return;
	CALL       _get_swr+0
	MOVLW      0
	XORWF      _SWR+1, 0
	BTFSS      STATUS+0, 2
	GOTO       L__coarse_tune632
	MOVLW      0
	XORWF      _SWR+0, 0
L__coarse_tune632:
	BTFSS      STATUS+0, 2
	GOTO       L_coarse_tune80
	GOTO       L_end_coarse_tune
L_coarse_tune80:
;main.h,255 :: 		if(SWR < min_swr) {
	MOVLW      128
	XORWF      _SWR+1, 0
	MOVWF      R0
	MOVLW      128
	XORWF      coarse_tune_min_swr_L0+1, 0
	SUBWF      R0, 0
	BTFSS      STATUS+0, 2
	GOTO       L__coarse_tune633
	MOVF       coarse_tune_min_swr_L0+0, 0
	SUBWF      _SWR+0, 0
L__coarse_tune633:
	BTFSC      STATUS+0, 0
	GOTO       L_coarse_tune81
;main.h,256 :: 		min_swr = SWR + SWR/20;
	MOVLW      20
	MOVWF      R4
	MOVLW      0
	MOVWF      R5
	MOVF       _SWR+0, 0
	MOVWF      R0
	MOVF       _SWR+1, 0
	MOVWF      R1
	CALL       _Div_16x16_S+0
	MOVF       R0, 0
	ADDWF      _SWR+0, 0
	MOVWF      coarse_tune_min_swr_L0+0
	MOVF       R1, 0
	ADDWFC     _SWR+1, 0
	MOVWF      coarse_tune_min_swr_L0+1
;main.h,257 :: 		ind = count*L_mult;
	MOVF       coarse_tune_count_L0+0, 0
	MOVWF      R0
	MOVF       main_L_mult+0, 0
	MOVWF      R4
	CALL       _Mul_8x8_U+0
	MOVF       R0, 0
	MOVWF      main_ind+0
;main.h,258 :: 		mem_cap = cap;
	MOVF       main_cap+0, 0
	MOVWF      coarse_tune_mem_cap_L0+0
;main.h,259 :: 		step_ind = step;
	MOVF       coarse_tune_step_L0+0, 0
	MOVWF      main_step_ind+0
;main.h,260 :: 		mem_step_cap = step_cap;
	MOVF       main_step_cap+0, 0
	MOVWF      coarse_tune_mem_step_cap_L0+0
;main.h,261 :: 		if(SWR<120) break;
	MOVLW      128
	XORWF      _SWR+1, 0
	MOVWF      R0
	MOVLW      128
	SUBWF      R0, 0
	BTFSS      STATUS+0, 2
	GOTO       L__coarse_tune634
	MOVLW      120
	SUBWF      _SWR+0, 0
L__coarse_tune634:
	BTFSC      STATUS+0, 0
	GOTO       L_coarse_tune82
	GOTO       L_coarse_tune78
L_coarse_tune82:
;main.h,262 :: 		count +=step;
	MOVF       coarse_tune_step_L0+0, 0
	ADDWF      coarse_tune_count_L0+0, 0
	MOVWF      R2
	MOVF       R2, 0
	MOVWF      coarse_tune_count_L0+0
;main.h,263 :: 		if(L_linear==0 & count==9) count = 8;
	MOVF       main_L_linear+0, 0
	XORLW      0
	MOVLW      1
	BTFSS      STATUS+0, 2
	MOVLW      0
	MOVWF      R1
	MOVF       R2, 0
	XORLW      9
	MOVLW      1
	BTFSS      STATUS+0, 2
	MOVLW      0
	MOVWF      R0
	MOVF       R1, 0
	ANDWF      R0, 1
	BTFSC      STATUS+0, 2
	GOTO       L_coarse_tune83
	MOVLW      8
	MOVWF      coarse_tune_count_L0+0
	GOTO       L_coarse_tune84
L_coarse_tune83:
;main.h,264 :: 		else if(L_linear==0 & count==17) {count = 16; step = 4;}
	MOVF       main_L_linear+0, 0
	XORLW      0
	MOVLW      1
	BTFSS      STATUS+0, 2
	MOVLW      0
	MOVWF      R1
	MOVF       coarse_tune_count_L0+0, 0
	XORLW      17
	MOVLW      1
	BTFSS      STATUS+0, 2
	MOVLW      0
	MOVWF      R0
	MOVF       R1, 0
	ANDWF      R0, 1
	BTFSC      STATUS+0, 2
	GOTO       L_coarse_tune85
	MOVLW      16
	MOVWF      coarse_tune_count_L0+0
	MOVLW      4
	MOVWF      coarse_tune_step_L0+0
L_coarse_tune85:
L_coarse_tune84:
;main.h,265 :: 		}
	GOTO       L_coarse_tune86
L_coarse_tune81:
;main.h,266 :: 		else break;
	GOTO       L_coarse_tune78
L_coarse_tune86:
;main.h,267 :: 		}
	GOTO       L_coarse_tune77
L_coarse_tune78:
;main.h,268 :: 		cap = mem_cap;
	MOVF       coarse_tune_mem_cap_L0+0, 0
	MOVWF      main_cap+0
;main.h,269 :: 		set_ind(ind);
	MOVF       main_ind+0, 0
	MOVWF      FARG_set_ind_Ind+0
	CALL       _set_ind+0
;main.h,270 :: 		set_cap(cap);
	MOVF       main_cap+0, 0
	MOVWF      FARG_set_cap_Cap+0
	CALL       _set_cap+0
;main.h,271 :: 		step_cap = mem_step_cap;
	MOVF       coarse_tune_mem_step_cap_L0+0, 0
	MOVWF      main_step_cap+0
;main.h,272 :: 		Delay_ms(10);
	MOVLW      52
	MOVWF      R12
	MOVLW      241
	MOVWF      R13
L_coarse_tune87:
	DECFSZ     R13, 1
	GOTO       L_coarse_tune87
	DECFSZ     R12, 1
	GOTO       L_coarse_tune87
	NOP
	NOP
;main.h,273 :: 		return;
;main.h,274 :: 		}
L_end_coarse_tune:
	RETURN
; end of _coarse_tune

_sharp_cap:

;main.h,276 :: 		void sharp_cap() {
;main.h,279 :: 		range = step_cap*C_mult;
	MOVF       main_step_cap+0, 0
	MOVWF      R0
	MOVF       main_C_mult+0, 0
	MOVWF      R4
	CALL       _Mul_8x8_U+0
	MOVF       R0, 0
	MOVWF      sharp_cap_range_L0+0
;main.h,281 :: 		max_range = cap + range;
	MOVF       R0, 0
	ADDWF      main_cap+0, 0
	MOVWF      R4
	MOVF       R4, 0
	MOVWF      sharp_cap_max_range_L0+0
;main.h,282 :: 		if(max_range>32*C_mult-1) max_range = 32*C_mult-1;
	MOVLW      5
	MOVWF      R2
	MOVF       main_C_mult+0, 0
	MOVWF      R0
	CLRF       R1
	MOVF       R2, 0
L__sharp_cap636:
	BTFSC      STATUS+0, 2
	GOTO       L__sharp_cap637
	LSLF       R0, 1
	RLF        R1, 1
	ADDLW      255
	GOTO       L__sharp_cap636
L__sharp_cap637:
	MOVLW      1
	SUBWF      R0, 0
	MOVWF      R2
	MOVLW      0
	SUBWFB     R1, 0
	MOVWF      R3
	MOVLW      128
	XORWF      R3, 0
	MOVWF      R0
	MOVLW      128
	SUBWF      R0, 0
	BTFSS      STATUS+0, 2
	GOTO       L__sharp_cap638
	MOVF       R4, 0
	SUBWF      R2, 0
L__sharp_cap638:
	BTFSC      STATUS+0, 0
	GOTO       L_sharp_cap88
	MOVLW      5
	MOVWF      R0
	MOVF       main_C_mult+0, 0
	MOVWF      sharp_cap_max_range_L0+0
	MOVF       R0, 0
L__sharp_cap639:
	BTFSC      STATUS+0, 2
	GOTO       L__sharp_cap640
	LSLF       sharp_cap_max_range_L0+0, 1
	ADDLW      255
	GOTO       L__sharp_cap639
L__sharp_cap640:
	DECF       sharp_cap_max_range_L0+0, 1
L_sharp_cap88:
;main.h,283 :: 		if(cap>range) min_range = cap - range; else min_range = 0;
	MOVF       main_cap+0, 0
	SUBWF      sharp_cap_range_L0+0, 0
	BTFSC      STATUS+0, 0
	GOTO       L_sharp_cap89
	MOVF       sharp_cap_range_L0+0, 0
	SUBWF      main_cap+0, 0
	MOVWF      sharp_cap_min_range_L0+0
	GOTO       L_sharp_cap90
L_sharp_cap89:
	CLRF       sharp_cap_min_range_L0+0
L_sharp_cap90:
;main.h,284 :: 		cap = min_range;
	MOVF       sharp_cap_min_range_L0+0, 0
	MOVWF      main_cap+0
;main.h,285 :: 		set_cap(cap);
	MOVF       sharp_cap_min_range_L0+0, 0
	MOVWF      FARG_set_cap_Cap+0
	CALL       _set_cap+0
;main.h,286 :: 		get_swr(); if(SWR==0) return;
	CALL       _get_swr+0
	MOVLW      0
	XORWF      _SWR+1, 0
	BTFSS      STATUS+0, 2
	GOTO       L__sharp_cap641
	MOVLW      0
	XORWF      _SWR+0, 0
L__sharp_cap641:
	BTFSS      STATUS+0, 2
	GOTO       L_sharp_cap91
	GOTO       L_end_sharp_cap
L_sharp_cap91:
;main.h,287 :: 		min_SWR = SWR;
	MOVF       _SWR+0, 0
	MOVWF      sharp_cap_min_swr_L0+0
	MOVF       _SWR+1, 0
	MOVWF      sharp_cap_min_swr_L0+1
;main.h,288 :: 		for(count=min_range+C_mult; count<=max_range; count+=C_mult)  {
	MOVF       main_C_mult+0, 0
	ADDWF      sharp_cap_min_range_L0+0, 0
	MOVWF      sharp_cap_count_L0+0
L_sharp_cap92:
	MOVF       sharp_cap_count_L0+0, 0
	SUBWF      sharp_cap_max_range_L0+0, 0
	BTFSS      STATUS+0, 0
	GOTO       L_sharp_cap93
;main.h,289 :: 		set_cap(count);
	MOVF       sharp_cap_count_L0+0, 0
	MOVWF      FARG_set_cap_Cap+0
	CALL       _set_cap+0
;main.h,290 :: 		get_swr(); if(SWR==0) return;
	CALL       _get_swr+0
	MOVLW      0
	XORWF      _SWR+1, 0
	BTFSS      STATUS+0, 2
	GOTO       L__sharp_cap642
	MOVLW      0
	XORWF      _SWR+0, 0
L__sharp_cap642:
	BTFSS      STATUS+0, 2
	GOTO       L_sharp_cap95
	GOTO       L_end_sharp_cap
L_sharp_cap95:
;main.h,291 :: 		if(SWR>=min_SWR) { Delay_ms(10); get_swr(); }
	MOVLW      128
	XORWF      _SWR+1, 0
	MOVWF      R0
	MOVLW      128
	XORWF      sharp_cap_min_swr_L0+1, 0
	SUBWF      R0, 0
	BTFSS      STATUS+0, 2
	GOTO       L__sharp_cap643
	MOVF       sharp_cap_min_swr_L0+0, 0
	SUBWF      _SWR+0, 0
L__sharp_cap643:
	BTFSS      STATUS+0, 0
	GOTO       L_sharp_cap96
	MOVLW      52
	MOVWF      R12
	MOVLW      241
	MOVWF      R13
L_sharp_cap97:
	DECFSZ     R13, 1
	GOTO       L_sharp_cap97
	DECFSZ     R12, 1
	GOTO       L_sharp_cap97
	NOP
	NOP
	CALL       _get_swr+0
L_sharp_cap96:
;main.h,292 :: 		if(SWR>=min_SWR) { Delay_ms(10); get_swr(); }
	MOVLW      128
	XORWF      _SWR+1, 0
	MOVWF      R0
	MOVLW      128
	XORWF      sharp_cap_min_swr_L0+1, 0
	SUBWF      R0, 0
	BTFSS      STATUS+0, 2
	GOTO       L__sharp_cap644
	MOVF       sharp_cap_min_swr_L0+0, 0
	SUBWF      _SWR+0, 0
L__sharp_cap644:
	BTFSS      STATUS+0, 0
	GOTO       L_sharp_cap98
	MOVLW      52
	MOVWF      R12
	MOVLW      241
	MOVWF      R13
L_sharp_cap99:
	DECFSZ     R13, 1
	GOTO       L_sharp_cap99
	DECFSZ     R12, 1
	GOTO       L_sharp_cap99
	NOP
	NOP
	CALL       _get_swr+0
L_sharp_cap98:
;main.h,293 :: 		if(SWR < min_SWR) {
	MOVLW      128
	XORWF      _SWR+1, 0
	MOVWF      R0
	MOVLW      128
	XORWF      sharp_cap_min_swr_L0+1, 0
	SUBWF      R0, 0
	BTFSS      STATUS+0, 2
	GOTO       L__sharp_cap645
	MOVF       sharp_cap_min_swr_L0+0, 0
	SUBWF      _SWR+0, 0
L__sharp_cap645:
	BTFSC      STATUS+0, 0
	GOTO       L_sharp_cap100
;main.h,294 :: 		min_SWR = SWR;
	MOVF       _SWR+0, 0
	MOVWF      sharp_cap_min_swr_L0+0
	MOVF       _SWR+1, 0
	MOVWF      sharp_cap_min_swr_L0+1
;main.h,295 :: 		cap = count;
	MOVF       sharp_cap_count_L0+0, 0
	MOVWF      main_cap+0
;main.h,296 :: 		if(SWR<120) break;
	MOVLW      128
	XORWF      _SWR+1, 0
	MOVWF      R0
	MOVLW      128
	SUBWF      R0, 0
	BTFSS      STATUS+0, 2
	GOTO       L__sharp_cap646
	MOVLW      120
	SUBWF      _SWR+0, 0
L__sharp_cap646:
	BTFSC      STATUS+0, 0
	GOTO       L_sharp_cap101
	GOTO       L_sharp_cap93
L_sharp_cap101:
;main.h,297 :: 		}
	GOTO       L_sharp_cap102
L_sharp_cap100:
;main.h,298 :: 		else break;
	GOTO       L_sharp_cap93
L_sharp_cap102:
;main.h,288 :: 		for(count=min_range+C_mult; count<=max_range; count+=C_mult)  {
	MOVF       main_C_mult+0, 0
	ADDWF      sharp_cap_count_L0+0, 1
;main.h,299 :: 		}
	GOTO       L_sharp_cap92
L_sharp_cap93:
;main.h,300 :: 		set_cap(cap);
	MOVF       main_cap+0, 0
	MOVWF      FARG_set_cap_Cap+0
	CALL       _set_cap+0
;main.h,301 :: 		return;
;main.h,302 :: 		}
L_end_sharp_cap:
	RETURN
; end of _sharp_cap

_sharp_ind:

;main.h,304 :: 		void sharp_ind() {
;main.h,307 :: 		range = step_ind * L_mult;
	MOVF       main_step_ind+0, 0
	MOVWF      R0
	MOVF       main_L_mult+0, 0
	MOVWF      R4
	CALL       _Mul_8x8_U+0
	MOVF       R0, 0
	MOVWF      sharp_ind_range_L0+0
;main.h,309 :: 		max_range = ind + range;
	MOVF       R0, 0
	ADDWF      main_ind+0, 0
	MOVWF      R4
	MOVF       R4, 0
	MOVWF      sharp_ind_max_range_L0+0
;main.h,310 :: 		if(max_range>32*L_mult-1) max_range = 32*L_mult-1;
	MOVLW      5
	MOVWF      R2
	MOVF       main_L_mult+0, 0
	MOVWF      R0
	CLRF       R1
	MOVF       R2, 0
L__sharp_ind648:
	BTFSC      STATUS+0, 2
	GOTO       L__sharp_ind649
	LSLF       R0, 1
	RLF        R1, 1
	ADDLW      255
	GOTO       L__sharp_ind648
L__sharp_ind649:
	MOVLW      1
	SUBWF      R0, 0
	MOVWF      R2
	MOVLW      0
	SUBWFB     R1, 0
	MOVWF      R3
	MOVLW      128
	XORWF      R3, 0
	MOVWF      R0
	MOVLW      128
	SUBWF      R0, 0
	BTFSS      STATUS+0, 2
	GOTO       L__sharp_ind650
	MOVF       R4, 0
	SUBWF      R2, 0
L__sharp_ind650:
	BTFSC      STATUS+0, 0
	GOTO       L_sharp_ind103
	MOVLW      5
	MOVWF      R0
	MOVF       main_L_mult+0, 0
	MOVWF      sharp_ind_max_range_L0+0
	MOVF       R0, 0
L__sharp_ind651:
	BTFSC      STATUS+0, 2
	GOTO       L__sharp_ind652
	LSLF       sharp_ind_max_range_L0+0, 1
	ADDLW      255
	GOTO       L__sharp_ind651
L__sharp_ind652:
	DECF       sharp_ind_max_range_L0+0, 1
L_sharp_ind103:
;main.h,311 :: 		if(ind>range) min_range = ind - range; else min_range = 0;
	MOVF       main_ind+0, 0
	SUBWF      sharp_ind_range_L0+0, 0
	BTFSC      STATUS+0, 0
	GOTO       L_sharp_ind104
	MOVF       sharp_ind_range_L0+0, 0
	SUBWF      main_ind+0, 0
	MOVWF      sharp_ind_min_range_L0+0
	GOTO       L_sharp_ind105
L_sharp_ind104:
	CLRF       sharp_ind_min_range_L0+0
L_sharp_ind105:
;main.h,312 :: 		ind = min_range;
	MOVF       sharp_ind_min_range_L0+0, 0
	MOVWF      main_ind+0
;main.h,313 :: 		set_ind(ind);
	MOVF       sharp_ind_min_range_L0+0, 0
	MOVWF      FARG_set_ind_Ind+0
	CALL       _set_ind+0
;main.h,314 :: 		get_swr(); if(SWR==0) return;
	CALL       _get_swr+0
	MOVLW      0
	XORWF      _SWR+1, 0
	BTFSS      STATUS+0, 2
	GOTO       L__sharp_ind653
	MOVLW      0
	XORWF      _SWR+0, 0
L__sharp_ind653:
	BTFSS      STATUS+0, 2
	GOTO       L_sharp_ind106
	GOTO       L_end_sharp_ind
L_sharp_ind106:
;main.h,315 :: 		min_SWR = SWR;
	MOVF       _SWR+0, 0
	MOVWF      sharp_ind_min_SWR_L0+0
	MOVF       _SWR+1, 0
	MOVWF      sharp_ind_min_SWR_L0+1
;main.h,316 :: 		for(count=min_range+L_mult; count<=max_range; count+=L_mult) {
	MOVF       main_L_mult+0, 0
	ADDWF      sharp_ind_min_range_L0+0, 0
	MOVWF      sharp_ind_count_L0+0
L_sharp_ind107:
	MOVF       sharp_ind_count_L0+0, 0
	SUBWF      sharp_ind_max_range_L0+0, 0
	BTFSS      STATUS+0, 0
	GOTO       L_sharp_ind108
;main.h,317 :: 		set_ind(count);
	MOVF       sharp_ind_count_L0+0, 0
	MOVWF      FARG_set_ind_Ind+0
	CALL       _set_ind+0
;main.h,318 :: 		get_swr(); if(SWR==0) return;
	CALL       _get_swr+0
	MOVLW      0
	XORWF      _SWR+1, 0
	BTFSS      STATUS+0, 2
	GOTO       L__sharp_ind654
	MOVLW      0
	XORWF      _SWR+0, 0
L__sharp_ind654:
	BTFSS      STATUS+0, 2
	GOTO       L_sharp_ind110
	GOTO       L_end_sharp_ind
L_sharp_ind110:
;main.h,319 :: 		if(SWR>=min_SWR) { Delay_ms(10); get_swr(); }
	MOVLW      128
	XORWF      _SWR+1, 0
	MOVWF      R0
	MOVLW      128
	XORWF      sharp_ind_min_SWR_L0+1, 0
	SUBWF      R0, 0
	BTFSS      STATUS+0, 2
	GOTO       L__sharp_ind655
	MOVF       sharp_ind_min_SWR_L0+0, 0
	SUBWF      _SWR+0, 0
L__sharp_ind655:
	BTFSS      STATUS+0, 0
	GOTO       L_sharp_ind111
	MOVLW      52
	MOVWF      R12
	MOVLW      241
	MOVWF      R13
L_sharp_ind112:
	DECFSZ     R13, 1
	GOTO       L_sharp_ind112
	DECFSZ     R12, 1
	GOTO       L_sharp_ind112
	NOP
	NOP
	CALL       _get_swr+0
L_sharp_ind111:
;main.h,320 :: 		if(SWR>=min_SWR) { Delay_ms(10); get_swr(); }
	MOVLW      128
	XORWF      _SWR+1, 0
	MOVWF      R0
	MOVLW      128
	XORWF      sharp_ind_min_SWR_L0+1, 0
	SUBWF      R0, 0
	BTFSS      STATUS+0, 2
	GOTO       L__sharp_ind656
	MOVF       sharp_ind_min_SWR_L0+0, 0
	SUBWF      _SWR+0, 0
L__sharp_ind656:
	BTFSS      STATUS+0, 0
	GOTO       L_sharp_ind113
	MOVLW      52
	MOVWF      R12
	MOVLW      241
	MOVWF      R13
L_sharp_ind114:
	DECFSZ     R13, 1
	GOTO       L_sharp_ind114
	DECFSZ     R12, 1
	GOTO       L_sharp_ind114
	NOP
	NOP
	CALL       _get_swr+0
L_sharp_ind113:
;main.h,321 :: 		if(SWR < min_SWR) {
	MOVLW      128
	XORWF      _SWR+1, 0
	MOVWF      R0
	MOVLW      128
	XORWF      sharp_ind_min_SWR_L0+1, 0
	SUBWF      R0, 0
	BTFSS      STATUS+0, 2
	GOTO       L__sharp_ind657
	MOVF       sharp_ind_min_SWR_L0+0, 0
	SUBWF      _SWR+0, 0
L__sharp_ind657:
	BTFSC      STATUS+0, 0
	GOTO       L_sharp_ind115
;main.h,322 :: 		min_SWR = SWR;
	MOVF       _SWR+0, 0
	MOVWF      sharp_ind_min_SWR_L0+0
	MOVF       _SWR+1, 0
	MOVWF      sharp_ind_min_SWR_L0+1
;main.h,323 :: 		ind = count;
	MOVF       sharp_ind_count_L0+0, 0
	MOVWF      main_ind+0
;main.h,324 :: 		if(SWR<120) break;
	MOVLW      128
	XORWF      _SWR+1, 0
	MOVWF      R0
	MOVLW      128
	SUBWF      R0, 0
	BTFSS      STATUS+0, 2
	GOTO       L__sharp_ind658
	MOVLW      120
	SUBWF      _SWR+0, 0
L__sharp_ind658:
	BTFSC      STATUS+0, 0
	GOTO       L_sharp_ind116
	GOTO       L_sharp_ind108
L_sharp_ind116:
;main.h,325 :: 		}
	GOTO       L_sharp_ind117
L_sharp_ind115:
;main.h,326 :: 		else break;
	GOTO       L_sharp_ind108
L_sharp_ind117:
;main.h,316 :: 		for(count=min_range+L_mult; count<=max_range; count+=L_mult) {
	MOVF       main_L_mult+0, 0
	ADDWF      sharp_ind_count_L0+0, 1
;main.h,327 :: 		}
	GOTO       L_sharp_ind107
L_sharp_ind108:
;main.h,328 :: 		set_ind(ind);
	MOVF       main_ind+0, 0
	MOVWF      FARG_set_ind_Ind+0
	CALL       _set_ind+0
;main.h,329 :: 		return;
;main.h,330 :: 		}
L_end_sharp_ind:
	RETURN
; end of _sharp_ind

_sub_tune:

;main.h,333 :: 		void sub_tune () {
;main.h,336 :: 		swr_mem = SWR;
	MOVF       _SWR+0, 0
	MOVWF      sub_tune_swr_mem_L0+0
	MOVF       _SWR+1, 0
	MOVWF      sub_tune_swr_mem_L0+1
;main.h,337 :: 		coarse_tune(); if(SWR==0) {atu_reset(); return;}
	CALL       _coarse_tune+0
	MOVLW      0
	XORWF      _SWR+1, 0
	BTFSS      STATUS+0, 2
	GOTO       L__sub_tune660
	MOVLW      0
	XORWF      _SWR+0, 0
L__sub_tune660:
	BTFSS      STATUS+0, 2
	GOTO       L_sub_tune118
	CALL       _atu_reset+0
	GOTO       L_end_sub_tune
L_sub_tune118:
;main.h,338 :: 		get_swr(); if(SWR<120) return;
	CALL       _get_swr+0
	MOVLW      128
	XORWF      _SWR+1, 0
	MOVWF      R0
	MOVLW      128
	SUBWF      R0, 0
	BTFSS      STATUS+0, 2
	GOTO       L__sub_tune661
	MOVLW      120
	SUBWF      _SWR+0, 0
L__sub_tune661:
	BTFSC      STATUS+0, 0
	GOTO       L_sub_tune119
	GOTO       L_end_sub_tune
L_sub_tune119:
;main.h,339 :: 		sharp_ind();  if(SWR==0) {atu_reset(); return;}
	CALL       _sharp_ind+0
	MOVLW      0
	XORWF      _SWR+1, 0
	BTFSS      STATUS+0, 2
	GOTO       L__sub_tune662
	MOVLW      0
	XORWF      _SWR+0, 0
L__sub_tune662:
	BTFSS      STATUS+0, 2
	GOTO       L_sub_tune120
	CALL       _atu_reset+0
	GOTO       L_end_sub_tune
L_sub_tune120:
;main.h,340 :: 		get_swr(); if(SWR<120) return;
	CALL       _get_swr+0
	MOVLW      128
	XORWF      _SWR+1, 0
	MOVWF      R0
	MOVLW      128
	SUBWF      R0, 0
	BTFSS      STATUS+0, 2
	GOTO       L__sub_tune663
	MOVLW      120
	SUBWF      _SWR+0, 0
L__sub_tune663:
	BTFSC      STATUS+0, 0
	GOTO       L_sub_tune121
	GOTO       L_end_sub_tune
L_sub_tune121:
;main.h,341 :: 		sharp_cap(); if(SWR==0) {atu_reset(); return;}
	CALL       _sharp_cap+0
	MOVLW      0
	XORWF      _SWR+1, 0
	BTFSS      STATUS+0, 2
	GOTO       L__sub_tune664
	MOVLW      0
	XORWF      _SWR+0, 0
L__sub_tune664:
	BTFSS      STATUS+0, 2
	GOTO       L_sub_tune122
	CALL       _atu_reset+0
	GOTO       L_end_sub_tune
L_sub_tune122:
;main.h,342 :: 		get_swr(); if(SWR<120) return;
	CALL       _get_swr+0
	MOVLW      128
	XORWF      _SWR+1, 0
	MOVWF      R0
	MOVLW      128
	SUBWF      R0, 0
	BTFSS      STATUS+0, 2
	GOTO       L__sub_tune665
	MOVLW      120
	SUBWF      _SWR+0, 0
L__sub_tune665:
	BTFSC      STATUS+0, 0
	GOTO       L_sub_tune123
	GOTO       L_end_sub_tune
L_sub_tune123:
;main.h,344 :: 		if(SWR<200 & SWR<swr_mem & (swr_mem-SWR)>100) return;
	MOVLW      128
	XORWF      _SWR+1, 0
	MOVWF      R1
	MOVLW      128
	SUBWF      R1, 0
	BTFSS      STATUS+0, 2
	GOTO       L__sub_tune666
	MOVLW      200
	SUBWF      _SWR+0, 0
L__sub_tune666:
	MOVLW      1
	BTFSC      STATUS+0, 0
	MOVLW      0
	MOVWF      R1
	MOVLW      128
	XORWF      _SWR+1, 0
	MOVWF      R0
	MOVLW      128
	XORWF      sub_tune_swr_mem_L0+1, 0
	SUBWF      R0, 0
	BTFSS      STATUS+0, 2
	GOTO       L__sub_tune667
	MOVF       sub_tune_swr_mem_L0+0, 0
	SUBWF      _SWR+0, 0
L__sub_tune667:
	MOVLW      1
	BTFSC      STATUS+0, 0
	MOVLW      0
	MOVWF      R0
	MOVF       R0, 0
	ANDWF      R1, 0
	MOVWF      R3
	MOVF       _SWR+0, 0
	SUBWF      sub_tune_swr_mem_L0+0, 0
	MOVWF      R1
	MOVF       _SWR+1, 0
	SUBWFB     sub_tune_swr_mem_L0+1, 0
	MOVWF      R2
	MOVLW      128
	MOVWF      R0
	MOVLW      128
	XORWF      R2, 0
	SUBWF      R0, 0
	BTFSS      STATUS+0, 2
	GOTO       L__sub_tune668
	MOVF       R1, 0
	SUBLW      100
L__sub_tune668:
	MOVLW      1
	BTFSC      STATUS+0, 0
	MOVLW      0
	MOVWF      R0
	MOVF       R3, 0
	ANDWF      R0, 1
	BTFSC      STATUS+0, 2
	GOTO       L_sub_tune124
	GOTO       L_end_sub_tune
L_sub_tune124:
;main.h,345 :: 		swr_mem = SWR;
	MOVF       _SWR+0, 0
	MOVWF      sub_tune_swr_mem_L0+0
	MOVF       _SWR+1, 0
	MOVWF      sub_tune_swr_mem_L0+1
;main.h,346 :: 		ind_mem = ind;
	MOVF       main_ind+0, 0
	MOVWF      sub_tune_ind_mem_L0+0
	CLRF       sub_tune_ind_mem_L0+1
;main.h,347 :: 		cap_mem = cap;
	MOVF       main_cap+0, 0
	MOVWF      sub_tune_cap_mem_L0+0
	CLRF       sub_tune_cap_mem_L0+1
;main.h,349 :: 		if(SW==1) SW = 0; else SW = 1;
	MOVF       main_SW+0, 0
	XORLW      1
	BTFSS      STATUS+0, 2
	GOTO       L_sub_tune125
	CLRF       main_SW+0
	GOTO       L_sub_tune126
L_sub_tune125:
	MOVLW      1
	MOVWF      main_SW+0
L_sub_tune126:
;main.h,350 :: 		atu_reset();
	CALL       _atu_reset+0
;main.h,351 :: 		set_sw(SW);
	MOVF       main_SW+0, 0
	MOVWF      FARG_set_sw_SW+0
	CALL       _set_sw+0
;main.h,352 :: 		Delay_ms(50);
	MOVLW      2
	MOVWF      R11
	MOVLW      4
	MOVWF      R12
	MOVLW      186
	MOVWF      R13
L_sub_tune127:
	DECFSZ     R13, 1
	GOTO       L_sub_tune127
	DECFSZ     R12, 1
	GOTO       L_sub_tune127
	DECFSZ     R11, 1
	GOTO       L_sub_tune127
	NOP
;main.h,353 :: 		get_swr(); if(SWR<120) return;
	CALL       _get_swr+0
	MOVLW      128
	XORWF      _SWR+1, 0
	MOVWF      R0
	MOVLW      128
	SUBWF      R0, 0
	BTFSS      STATUS+0, 2
	GOTO       L__sub_tune669
	MOVLW      120
	SUBWF      _SWR+0, 0
L__sub_tune669:
	BTFSC      STATUS+0, 0
	GOTO       L_sub_tune128
	GOTO       L_end_sub_tune
L_sub_tune128:
;main.h,355 :: 		coarse_tune(); if(SWR==0) {atu_reset(); return;}
	CALL       _coarse_tune+0
	MOVLW      0
	XORWF      _SWR+1, 0
	BTFSS      STATUS+0, 2
	GOTO       L__sub_tune670
	MOVLW      0
	XORWF      _SWR+0, 0
L__sub_tune670:
	BTFSS      STATUS+0, 2
	GOTO       L_sub_tune129
	CALL       _atu_reset+0
	GOTO       L_end_sub_tune
L_sub_tune129:
;main.h,356 :: 		get_swr(); if(SWR<120) return;
	CALL       _get_swr+0
	MOVLW      128
	XORWF      _SWR+1, 0
	MOVWF      R0
	MOVLW      128
	SUBWF      R0, 0
	BTFSS      STATUS+0, 2
	GOTO       L__sub_tune671
	MOVLW      120
	SUBWF      _SWR+0, 0
L__sub_tune671:
	BTFSC      STATUS+0, 0
	GOTO       L_sub_tune130
	GOTO       L_end_sub_tune
L_sub_tune130:
;main.h,357 :: 		sharp_ind(); if(SWR==0) {atu_reset(); return;}
	CALL       _sharp_ind+0
	MOVLW      0
	XORWF      _SWR+1, 0
	BTFSS      STATUS+0, 2
	GOTO       L__sub_tune672
	MOVLW      0
	XORWF      _SWR+0, 0
L__sub_tune672:
	BTFSS      STATUS+0, 2
	GOTO       L_sub_tune131
	CALL       _atu_reset+0
	GOTO       L_end_sub_tune
L_sub_tune131:
;main.h,358 :: 		get_swr(); if(SWR<120) return;
	CALL       _get_swr+0
	MOVLW      128
	XORWF      _SWR+1, 0
	MOVWF      R0
	MOVLW      128
	SUBWF      R0, 0
	BTFSS      STATUS+0, 2
	GOTO       L__sub_tune673
	MOVLW      120
	SUBWF      _SWR+0, 0
L__sub_tune673:
	BTFSC      STATUS+0, 0
	GOTO       L_sub_tune132
	GOTO       L_end_sub_tune
L_sub_tune132:
;main.h,359 :: 		sharp_cap(); if(SWR==0) {atu_reset(); return;}
	CALL       _sharp_cap+0
	MOVLW      0
	XORWF      _SWR+1, 0
	BTFSS      STATUS+0, 2
	GOTO       L__sub_tune674
	MOVLW      0
	XORWF      _SWR+0, 0
L__sub_tune674:
	BTFSS      STATUS+0, 2
	GOTO       L_sub_tune133
	CALL       _atu_reset+0
	GOTO       L_end_sub_tune
L_sub_tune133:
;main.h,360 :: 		get_swr(); if(SWR<120) return;
	CALL       _get_swr+0
	MOVLW      128
	XORWF      _SWR+1, 0
	MOVWF      R0
	MOVLW      128
	SUBWF      R0, 0
	BTFSS      STATUS+0, 2
	GOTO       L__sub_tune675
	MOVLW      120
	SUBWF      _SWR+0, 0
L__sub_tune675:
	BTFSC      STATUS+0, 0
	GOTO       L_sub_tune134
	GOTO       L_end_sub_tune
L_sub_tune134:
;main.h,362 :: 		if(SWR>swr_mem) {
	MOVLW      128
	XORWF      sub_tune_swr_mem_L0+1, 0
	MOVWF      R0
	MOVLW      128
	XORWF      _SWR+1, 0
	SUBWF      R0, 0
	BTFSS      STATUS+0, 2
	GOTO       L__sub_tune676
	MOVF       _SWR+0, 0
	SUBWF      sub_tune_swr_mem_L0+0, 0
L__sub_tune676:
	BTFSC      STATUS+0, 0
	GOTO       L_sub_tune135
;main.h,363 :: 		if(SW==1) SW = 0; else SW = 1;
	MOVF       main_SW+0, 0
	XORLW      1
	BTFSS      STATUS+0, 2
	GOTO       L_sub_tune136
	CLRF       main_SW+0
	GOTO       L_sub_tune137
L_sub_tune136:
	MOVLW      1
	MOVWF      main_SW+0
L_sub_tune137:
;main.h,364 :: 		set_sw(SW);
	MOVF       main_SW+0, 0
	MOVWF      FARG_set_sw_SW+0
	CALL       _set_sw+0
;main.h,365 :: 		ind = ind_mem;
	MOVF       sub_tune_ind_mem_L0+0, 0
	MOVWF      main_ind+0
;main.h,366 :: 		cap = cap_mem;
	MOVF       sub_tune_cap_mem_L0+0, 0
	MOVWF      main_cap+0
;main.h,367 :: 		set_ind(ind);
	MOVF       sub_tune_ind_mem_L0+0, 0
	MOVWF      FARG_set_ind_Ind+0
	CALL       _set_ind+0
;main.h,368 :: 		set_cap(cap);
	MOVF       main_cap+0, 0
	MOVWF      FARG_set_cap_Cap+0
	CALL       _set_cap+0
;main.h,369 :: 		SWR = swr_mem;
	MOVF       sub_tune_swr_mem_L0+0, 0
	MOVWF      _SWR+0
	MOVF       sub_tune_swr_mem_L0+1, 0
	MOVWF      _SWR+1
;main.h,370 :: 		}
L_sub_tune135:
;main.h,372 :: 		asm CLRWDT;
	CLRWDT
;main.h,373 :: 		return;
;main.h,374 :: 		}
L_end_sub_tune:
	RETURN
; end of _sub_tune

_tune:

;main.h,378 :: 		void tune() {
;main.h,380 :: 		asm CLRWDT;
	CLRWDT
;main.h,382 :: 		p_cnt = 0;
	CLRF       _p_cnt+0
;main.h,383 :: 		P_max = 0;
	CLRF       _P_max+0
	CLRF       _P_max+1
;main.h,385 :: 		rready = 0;
	CLRF       _rready+0
;main.h,386 :: 		get_swr();
	CALL       _get_swr+0
;main.h,387 :: 		if(SWR<110) return;
	MOVLW      128
	XORWF      _SWR+1, 0
	MOVWF      R0
	MOVLW      128
	SUBWF      R0, 0
	BTFSS      STATUS+0, 2
	GOTO       L__tune678
	MOVLW      110
	SUBWF      _SWR+0, 0
L__tune678:
	BTFSC      STATUS+0, 0
	GOTO       L_tune138
	GOTO       L_end_tune
L_tune138:
;main.h,388 :: 		atu_reset();
	CALL       _atu_reset+0
;main.h,389 :: 		if(Loss_ind==0) lcd_ind();
	MOVF       main_Loss_ind+0, 0
	XORLW      0
	BTFSS      STATUS+0, 2
	GOTO       L_tune139
	CALL       _lcd_ind+0
L_tune139:
;main.h,390 :: 		Delay_ms(50);
	MOVLW      2
	MOVWF      R11
	MOVLW      4
	MOVWF      R12
	MOVLW      186
	MOVWF      R13
L_tune140:
	DECFSZ     R13, 1
	GOTO       L_tune140
	DECFSZ     R12, 1
	GOTO       L_tune140
	DECFSZ     R11, 1
	GOTO       L_tune140
	NOP
;main.h,391 :: 		get_swr();
	CALL       _get_swr+0
;main.h,392 :: 		swr_a = SWR;
	MOVF       _SWR+0, 0
	MOVWF      _swr_a+0
	MOVF       _SWR+1, 0
	MOVWF      _swr_a+1
;main.h,393 :: 		if(SWR<110) return;
	MOVLW      128
	XORWF      _SWR+1, 0
	MOVWF      R0
	MOVLW      128
	SUBWF      R0, 0
	BTFSS      STATUS+0, 2
	GOTO       L__tune679
	MOVLW      110
	SUBWF      _SWR+0, 0
L__tune679:
	BTFSC      STATUS+0, 0
	GOTO       L_tune141
	GOTO       L_end_tune
L_tune141:
;main.h,394 :: 		if(max_swr>110 & SWR>max_swr) return;
	MOVLW      128
	MOVWF      R1
	MOVLW      128
	XORWF      main_max_swr+1, 0
	SUBWF      R1, 0
	BTFSS      STATUS+0, 2
	GOTO       L__tune680
	MOVF       main_max_swr+0, 0
	SUBLW      110
L__tune680:
	MOVLW      1
	BTFSC      STATUS+0, 0
	MOVLW      0
	MOVWF      R1
	MOVLW      128
	XORWF      main_max_swr+1, 0
	MOVWF      R0
	MOVLW      128
	XORWF      _SWR+1, 0
	SUBWF      R0, 0
	BTFSS      STATUS+0, 2
	GOTO       L__tune681
	MOVF       _SWR+0, 0
	SUBWF      main_max_swr+0, 0
L__tune681:
	MOVLW      1
	BTFSC      STATUS+0, 0
	MOVLW      0
	MOVWF      R0
	MOVF       R1, 0
	ANDWF      R0, 1
	BTFSC      STATUS+0, 2
	GOTO       L_tune142
	GOTO       L_end_tune
L_tune142:
;main.h,396 :: 		sub_tune(); if(SWR==0) {atu_reset(); return;}
	CALL       _sub_tune+0
	MOVLW      0
	XORWF      _SWR+1, 0
	BTFSS      STATUS+0, 2
	GOTO       L__tune682
	MOVLW      0
	XORWF      _SWR+0, 0
L__tune682:
	BTFSS      STATUS+0, 2
	GOTO       L_tune143
	CALL       _atu_reset+0
	GOTO       L_end_tune
L_tune143:
;main.h,397 :: 		if(SWR<120) return;
	MOVLW      128
	XORWF      _SWR+1, 0
	MOVWF      R0
	MOVLW      128
	SUBWF      R0, 0
	BTFSS      STATUS+0, 2
	GOTO       L__tune683
	MOVLW      120
	SUBWF      _SWR+0, 0
L__tune683:
	BTFSC      STATUS+0, 0
	GOTO       L_tune144
	GOTO       L_end_tune
L_tune144:
;main.h,398 :: 		if(C_q==5 & L_q==5) return;
	MOVF       main_C_q+0, 0
	XORLW      5
	MOVLW      1
	BTFSS      STATUS+0, 2
	MOVLW      0
	MOVWF      R1
	MOVF       main_L_q+0, 0
	XORLW      5
	MOVLW      1
	BTFSS      STATUS+0, 2
	MOVLW      0
	MOVWF      R0
	MOVF       R1, 0
	ANDWF      R0, 1
	BTFSC      STATUS+0, 2
	GOTO       L_tune145
	GOTO       L_end_tune
L_tune145:
;main.h,400 :: 		if(L_q>5) {
	MOVF       main_L_q+0, 0
	SUBLW      5
	BTFSC      STATUS+0, 0
	GOTO       L_tune146
;main.h,401 :: 		step_ind = L_mult;
	MOVF       main_L_mult+0, 0
	MOVWF      main_step_ind+0
;main.h,402 :: 		L_mult = 1;
	MOVLW      1
	MOVWF      main_L_mult+0
;main.h,403 :: 		sharp_ind();
	CALL       _sharp_ind+0
;main.h,404 :: 		}
L_tune146:
;main.h,405 :: 		if(SWR<120) return;
	MOVLW      128
	XORWF      _SWR+1, 0
	MOVWF      R0
	MOVLW      128
	SUBWF      R0, 0
	BTFSS      STATUS+0, 2
	GOTO       L__tune684
	MOVLW      120
	SUBWF      _SWR+0, 0
L__tune684:
	BTFSC      STATUS+0, 0
	GOTO       L_tune147
	GOTO       L_end_tune
L_tune147:
;main.h,406 :: 		if(C_q>5) {
	MOVF       main_C_q+0, 0
	SUBLW      5
	BTFSC      STATUS+0, 0
	GOTO       L_tune148
;main.h,407 :: 		step_cap = C_mult;  // = C_mult
	MOVF       main_C_mult+0, 0
	MOVWF      main_step_cap+0
;main.h,408 :: 		C_mult = 1;
	MOVLW      1
	MOVWF      main_C_mult+0
;main.h,409 :: 		sharp_cap();
	CALL       _sharp_cap+0
;main.h,410 :: 		}
L_tune148:
;main.h,411 :: 		if(L_q==5)L_mult = 1;
	MOVF       main_L_q+0, 0
	XORLW      5
	BTFSS      STATUS+0, 2
	GOTO       L_tune149
	MOVLW      1
	MOVWF      main_L_mult+0
	GOTO       L_tune150
L_tune149:
;main.h,412 :: 		else if(L_q==6) L_mult = 2;
	MOVF       main_L_q+0, 0
	XORLW      6
	BTFSS      STATUS+0, 2
	GOTO       L_tune151
	MOVLW      2
	MOVWF      main_L_mult+0
	GOTO       L_tune152
L_tune151:
;main.h,413 :: 		else if(L_q==7) L_mult = 4;
	MOVF       main_L_q+0, 0
	XORLW      7
	BTFSS      STATUS+0, 2
	GOTO       L_tune153
	MOVLW      4
	MOVWF      main_L_mult+0
L_tune153:
L_tune152:
L_tune150:
;main.h,414 :: 		if(C_q==5) C_mult =1;
	MOVF       main_C_q+0, 0
	XORLW      5
	BTFSS      STATUS+0, 2
	GOTO       L_tune154
	MOVLW      1
	MOVWF      main_C_mult+0
	GOTO       L_tune155
L_tune154:
;main.h,415 :: 		else if(C_q==6) C_mult = 2;
	MOVF       main_C_q+0, 0
	XORLW      6
	BTFSS      STATUS+0, 2
	GOTO       L_tune156
	MOVLW      2
	MOVWF      main_C_mult+0
	GOTO       L_tune157
L_tune156:
;main.h,416 :: 		else if(C_q==7) C_mult = 4;
	MOVF       main_C_q+0, 0
	XORLW      7
	BTFSS      STATUS+0, 2
	GOTO       L_tune158
	MOVLW      4
	MOVWF      main_C_mult+0
L_tune158:
L_tune157:
L_tune155:
;main.h,417 :: 		asm CLRWDT;
	CLRWDT
;main.h,418 :: 		return;
;main.h,419 :: 		}
L_end_tune:
	RETURN
; end of _tune

_main:

;main.c,32 :: 		void main() {
;main.c,33 :: 		if(STATUS.B4==0) Restart = 1;
	BTFSC      STATUS+0, 4
	GOTO       L_main159
	MOVLW      1
	MOVWF      _Restart+0
L_main159:
;main.c,34 :: 		pic_init();
	CALL       _pic_init+0
;main.c,36 :: 		Delay_ms (100);
	MOVLW      3
	MOVWF      R11
	MOVLW      8
	MOVWF      R12
	MOVLW      119
	MOVWF      R13
L_main160:
	DECFSZ     R13, 1
	GOTO       L_main160
	DECFSZ     R12, 1
	GOTO       L_main160
	DECFSZ     R11, 1
	GOTO       L_main160
;main.c,37 :: 		asm CLRWDT;
	CLRWDT
;main.c,38 :: 		cells_init();
	CALL       _cells_init+0
;main.c,39 :: 		Soft_I2C_Init();
	CALL       _Soft_I2C_Init+0
;main.c,40 :: 		if(type==0) { // 2-colors led  reset
	MOVF       _type+0, 0
	XORLW      0
	BTFSS      STATUS+0, 2
	GOTO       L_main161
;main.c,41 :: 		LATB.B6 = 1;
	BSF        LATB+0, 6
;main.c,42 :: 		LATB.B7 = 1;
	BSF        LATB+0, 7
;main.c,43 :: 		}
L_main161:
;main.c,44 :: 		dysp_cnt = Dysp_delay * dysp_cnt_mult;
	MOVF       _Dysp_delay+0, 0
	MOVWF      R0
	CALL       _Byte2Double+0
	MOVF       _dysp_cnt_mult+0, 0
	MOVWF      R4
	MOVF       _dysp_cnt_mult+1, 0
	MOVWF      R5
	MOVF       _dysp_cnt_mult+2, 0
	MOVWF      R6
	MOVF       _dysp_cnt_mult+3, 0
	MOVWF      R7
	CALL       _Mul_32x32_FP+0
	CALL       _Double2Int+0
	MOVF       R0, 0
	MOVWF      _dysp_cnt+0
	MOVF       R1, 0
	MOVWF      _dysp_cnt+1
;main.c,46 :: 		Delay_ms(200);
	MOVLW      5
	MOVWF      R11
	MOVLW      15
	MOVWF      R12
	MOVLW      241
	MOVWF      R13
L_main162:
	DECFSZ     R13, 1
	GOTO       L_main162
	DECFSZ     R12, 1
	GOTO       L_main162
	DECFSZ     R11, 1
	GOTO       L_main162
;main.c,47 :: 		asm CLRWDT;
	CLRWDT
;main.c,49 :: 		if(L_q==5)L_mult = 1;
	MOVF       main_L_q+0, 0
	XORLW      5
	BTFSS      STATUS+0, 2
	GOTO       L_main163
	MOVLW      1
	MOVWF      main_L_mult+0
	GOTO       L_main164
L_main163:
;main.c,50 :: 		else if(L_q==6) L_mult = 2;
	MOVF       main_L_q+0, 0
	XORLW      6
	BTFSS      STATUS+0, 2
	GOTO       L_main165
	MOVLW      2
	MOVWF      main_L_mult+0
	GOTO       L_main166
L_main165:
;main.c,51 :: 		else if(L_q==7) L_mult = 4;
	MOVF       main_L_q+0, 0
	XORLW      7
	BTFSS      STATUS+0, 2
	GOTO       L_main167
	MOVLW      4
	MOVWF      main_L_mult+0
L_main167:
L_main166:
L_main164:
;main.c,52 :: 		if(C_q==5) C_mult =1;
	MOVF       main_C_q+0, 0
	XORLW      5
	BTFSS      STATUS+0, 2
	GOTO       L_main168
	MOVLW      1
	MOVWF      main_C_mult+0
	GOTO       L_main169
L_main168:
;main.c,53 :: 		else if(C_q==6) C_mult = 2;
	MOVF       main_C_q+0, 0
	XORLW      6
	BTFSS      STATUS+0, 2
	GOTO       L_main170
	MOVLW      2
	MOVWF      main_C_mult+0
	GOTO       L_main171
L_main170:
;main.c,54 :: 		else if(C_q==7) C_mult = 4;
	MOVF       main_C_q+0, 0
	XORLW      7
	BTFSS      STATUS+0, 2
	GOTO       L_main172
	MOVLW      4
	MOVWF      main_C_mult+0
L_main172:
L_main171:
L_main169:
;main.c,56 :: 		led_init();
	CALL       _led_init+0
;main.c,58 :: 		if(Test==0) {
	MOVF       _Test+0, 0
	XORLW      0
	BTFSS      STATUS+0, 2
	GOTO       L_main173
;main.c,59 :: 		cap = EEPROM_Read(255);
	MOVLW      255
	MOVWF      FARG_EEPROM_Read_Address+0
	CALL       _EEPROM_Read+0
	MOVF       R0, 0
	MOVWF      main_cap+0
;main.c,60 :: 		ind = EEPROM_Read(254);
	MOVLW      254
	MOVWF      FARG_EEPROM_Read_Address+0
	CALL       _EEPROM_Read+0
	MOVF       R0, 0
	MOVWF      main_ind+0
;main.c,61 :: 		SW = EEPROM_Read(253);
	MOVLW      253
	MOVWF      FARG_EEPROM_Read_Address+0
	CALL       _EEPROM_Read+0
	MOVF       R0, 0
	MOVWF      main_SW+0
;main.c,62 :: 		swr_a = EEPROM_Read(252) * 256;
	MOVLW      252
	MOVWF      FARG_EEPROM_Read_Address+0
	CALL       _EEPROM_Read+0
	MOVF       R0, 0
	MOVWF      _swr_a+1
	CLRF       _swr_a+0
;main.c,63 :: 		swr_a += EEPROM_Read(251);
	MOVLW      251
	MOVWF      FARG_EEPROM_Read_Address+0
	CALL       _EEPROM_Read+0
	MOVF       R0, 0
	ADDWF      _swr_a+0, 1
	MOVLW      0
	ADDWFC     _swr_a+1, 1
;main.c,64 :: 		set_ind(ind);
	MOVF       main_ind+0, 0
	MOVWF      FARG_set_ind_Ind+0
	CALL       _set_ind+0
;main.c,65 :: 		set_cap(cap);
	MOVF       main_cap+0, 0
	MOVWF      FARG_set_cap_Cap+0
	CALL       _set_cap+0
;main.c,66 :: 		set_sw(SW);
	MOVF       main_SW+0, 0
	MOVWF      FARG_set_sw_SW+0
	CALL       _set_sw+0
;main.c,67 :: 		if(Restart==1 ) lcd_prep_short = 1;
	MOVF       _Restart+0, 0
	XORLW      1
	BTFSS      STATUS+0, 2
	GOTO       L_main174
	MOVLW      1
	MOVWF      _lcd_prep_short+0
L_main174:
;main.c,68 :: 		lcd_prep();
	CALL       _lcd_prep+0
;main.c,69 :: 		}
L_main173:
;main.c,71 :: 		lcd_ind();
	CALL       _lcd_ind+0
;main.c,77 :: 		while(1) {
L_main175:
;main.c,78 :: 		asm CLRWDT;
	CLRWDT
;main.c,79 :: 		lcd_pwr();
	CALL       _lcd_pwr+0
;main.c,81 :: 		if(Test==0) button_proc();
	MOVF       _Test+0, 0
	XORLW      0
	BTFSS      STATUS+0, 2
	GOTO       L_main177
	CALL       _button_proc+0
	GOTO       L_main178
L_main177:
;main.c,82 :: 		else button_proc_test();
	CALL       _button_proc_test+0
L_main178:
;main.c,84 :: 		if(dysp_cnt!=0) dysp_cnt --;
	MOVLW      0
	XORWF      _dysp_cnt+1, 0
	BTFSS      STATUS+0, 2
	GOTO       L__main686
	MOVLW      0
	XORWF      _dysp_cnt+0, 0
L__main686:
	BTFSC      STATUS+0, 2
	GOTO       L_main179
	MOVLW      1
	SUBWF      _dysp_cnt+0, 1
	MOVLW      0
	SUBWFB     _dysp_cnt+1, 1
	GOTO       L_main180
L_main179:
;main.c,85 :: 		else if(Test==0 & Dysp_delay!=0) dysp_off();
	MOVF       _Test+0, 0
	XORLW      0
	MOVLW      1
	BTFSS      STATUS+0, 2
	MOVLW      0
	MOVWF      R1
	MOVF       _Dysp_delay+0, 0
	XORLW      0
	MOVLW      1
	BTFSC      STATUS+0, 2
	MOVLW      0
	MOVWF      R0
	MOVF       R1, 0
	ANDWF      R0, 1
	BTFSC      STATUS+0, 2
	GOTO       L_main181
	CALL       _dysp_off+0
L_main181:
L_main180:
;main.c,89 :: 		}
	GOTO       L_main175
;main.c,90 :: 		}
L_end_main:
	GOTO       $+0
; end of _main

_button_proc_test:

;main.c,95 :: 		void button_proc_test(void) {
;main.c,96 :: 		if(Button(&PORTB, 0, 50, 0)){    // Tune btn
	MOVLW      PORTB+0
	MOVWF      FARG_Button_port+0
	MOVLW      hi_addr(PORTB+0)
	MOVWF      FARG_Button_port+1
	CLRF       FARG_Button_pin+0
	MOVLW      50
	MOVWF      FARG_Button_time_ms+0
	CLRF       FARG_Button_active_state+0
	CALL       _Button+0
	MOVF       R0, 0
	BTFSC      STATUS+0, 2
	GOTO       L_button_proc_test182
;main.c,97 :: 		Delay_ms(250);
	MOVLW      6
	MOVWF      R11
	MOVLW      19
	MOVWF      R12
	MOVLW      173
	MOVWF      R13
L_button_proc_test183:
	DECFSZ     R13, 1
	GOTO       L_button_proc_test183
	DECFSZ     R12, 1
	GOTO       L_button_proc_test183
	DECFSZ     R11, 1
	GOTO       L_button_proc_test183
	NOP
	NOP
;main.c,98 :: 		asm CLRWDT;
	CLRWDT
;main.c,99 :: 		if(PORTB.B0==1) { // short press button
	BTFSS      PORTB+0, 0
	GOTO       L_button_proc_test184
;main.c,100 :: 		if(SW==0) SW = 1; else SW = 0;
	MOVF       main_SW+0, 0
	XORLW      0
	BTFSS      STATUS+0, 2
	GOTO       L_button_proc_test185
	MOVLW      1
	MOVWF      main_SW+0
	GOTO       L_button_proc_test186
L_button_proc_test185:
	CLRF       main_SW+0
L_button_proc_test186:
;main.c,101 :: 		set_sw(SW);
	MOVF       main_SW+0, 0
	MOVWF      FARG_set_sw_SW+0
	CALL       _set_sw+0
;main.c,102 :: 		lcd_ind();
	CALL       _lcd_ind+0
;main.c,103 :: 		}
	GOTO       L_button_proc_test187
L_button_proc_test184:
;main.c,105 :: 		if(L==1) L = 0; else L = 1;
	MOVF       _L+0, 0
	XORLW      1
	BTFSS      STATUS+0, 2
	GOTO       L_button_proc_test188
	CLRF       _L+0
	GOTO       L_button_proc_test189
L_button_proc_test188:
	MOVLW      1
	MOVWF      _L+0
L_button_proc_test189:
;main.c,106 :: 		if(L==1) {
	MOVF       _L+0, 0
	XORLW      1
	BTFSS      STATUS+0, 2
	GOTO       L_button_proc_test190
;main.c,107 :: 		if(type==4 |type==5)   // 128*64 OLED
	MOVF       _type+0, 0
	XORLW      4
	MOVLW      1
	BTFSS      STATUS+0, 2
	MOVLW      0
	MOVWF      R1
	MOVF       _type+0, 0
	XORLW      5
	MOVLW      1
	BTFSS      STATUS+0, 2
	MOVLW      0
	MOVWF      R0
	MOVF       R1, 0
	IORWF       R0, 1
	BTFSC      STATUS+0, 2
	GOTO       L_button_proc_test191
;main.c,108 :: 		led_wr_str (0, 16+12*8, "l", 1);
	CLRF       FARG_led_wr_str+0
	MOVLW      112
	MOVWF      FARG_led_wr_str+0
	MOVLW      ?lstr1_main+0
	MOVWF      FARG_led_wr_str+0
	MOVLW      hi_addr(?lstr1_main+0)
	MOVWF      FARG_led_wr_str+1
	MOVLW      1
	MOVWF      FARG_led_wr_str+0
	CALL       _led_wr_str+0
	GOTO       L_button_proc_test192
L_button_proc_test191:
;main.c,109 :: 		else if(type!=0)              // 1602 LCD & 128*32 OLED
	MOVF       _type+0, 0
	XORLW      0
	BTFSC      STATUS+0, 2
	GOTO       L_button_proc_test193
;main.c,110 :: 		led_wr_str (0, 8, "l", 1);
	CLRF       FARG_led_wr_str+0
	MOVLW      8
	MOVWF      FARG_led_wr_str+0
	MOVLW      ?lstr2_main+0
	MOVWF      FARG_led_wr_str+0
	MOVLW      hi_addr(?lstr2_main+0)
	MOVWF      FARG_led_wr_str+1
	MOVLW      1
	MOVWF      FARG_led_wr_str+0
	CALL       _led_wr_str+0
L_button_proc_test193:
L_button_proc_test192:
;main.c,111 :: 		}
	GOTO       L_button_proc_test194
L_button_proc_test190:
;main.c,114 :: 		if(type==4 |type==5)   // 128*64 OLED
	MOVF       _type+0, 0
	XORLW      4
	MOVLW      1
	BTFSS      STATUS+0, 2
	MOVLW      0
	MOVWF      R1
	MOVF       _type+0, 0
	XORLW      5
	MOVLW      1
	BTFSS      STATUS+0, 2
	MOVLW      0
	MOVWF      R0
	MOVF       R1, 0
	IORWF       R0, 1
	BTFSC      STATUS+0, 2
	GOTO       L_button_proc_test195
;main.c,115 :: 		led_wr_str (0, 16+12*8, "c", 1);
	CLRF       FARG_led_wr_str+0
	MOVLW      112
	MOVWF      FARG_led_wr_str+0
	MOVLW      ?lstr3_main+0
	MOVWF      FARG_led_wr_str+0
	MOVLW      hi_addr(?lstr3_main+0)
	MOVWF      FARG_led_wr_str+1
	MOVLW      1
	MOVWF      FARG_led_wr_str+0
	CALL       _led_wr_str+0
	GOTO       L_button_proc_test196
L_button_proc_test195:
;main.c,116 :: 		else if(type!=0)              // 1602 LCD & 128*32 OLED
	MOVF       _type+0, 0
	XORLW      0
	BTFSC      STATUS+0, 2
	GOTO       L_button_proc_test197
;main.c,117 :: 		led_wr_str (0, 8, "c", 1);
	CLRF       FARG_led_wr_str+0
	MOVLW      8
	MOVWF      FARG_led_wr_str+0
	MOVLW      ?lstr4_main+0
	MOVWF      FARG_led_wr_str+0
	MOVLW      hi_addr(?lstr4_main+0)
	MOVWF      FARG_led_wr_str+1
	MOVLW      1
	MOVWF      FARG_led_wr_str+0
	CALL       _led_wr_str+0
L_button_proc_test197:
L_button_proc_test196:
;main.c,118 :: 		}
L_button_proc_test194:
;main.c,119 :: 		Delay_ms(1500);
	MOVLW      31
	MOVWF      R11
	MOVLW      113
	MOVWF      R12
	MOVLW      30
	MOVWF      R13
L_button_proc_test198:
	DECFSZ     R13, 1
	GOTO       L_button_proc_test198
	DECFSZ     R12, 1
	GOTO       L_button_proc_test198
	DECFSZ     R11, 1
	GOTO       L_button_proc_test198
	NOP
;main.c,120 :: 		asm CLRWDT;
	CLRWDT
;main.c,121 :: 		if(PORTB.B0==0) {     // long press button
	BTFSC      PORTB+0, 0
	GOTO       L_button_proc_test199
;main.c,122 :: 		Test = 0; // wery long press button
	CLRF       _Test+0
;main.c,123 :: 		if(EEPROM_Read(2) == 1) Auto = 1;
	MOVLW      2
	MOVWF      FARG_EEPROM_Read_Address+0
	CALL       _EEPROM_Read+0
	MOVF       R0, 0
	XORLW      1
	BTFSS      STATUS+0, 2
	GOTO       L_button_proc_test200
	MOVLW      1
	MOVWF      _Auto+0
L_button_proc_test200:
;main.c,125 :: 		EEPROM_Write(255, cap);
	MOVLW      255
	MOVWF      FARG_EEPROM_Write_Address+0
	MOVF       main_cap+0, 0
	MOVWF      FARG_EEPROM_Write_data_+0
	CALL       _EEPROM_Write+0
;main.c,126 :: 		EEPROM_Write(254, ind);
	MOVLW      254
	MOVWF      FARG_EEPROM_Write_Address+0
	MOVF       main_ind+0, 0
	MOVWF      FARG_EEPROM_Write_data_+0
	CALL       _EEPROM_Write+0
;main.c,127 :: 		EEPROM_Write(253, SW);
	MOVLW      253
	MOVWF      FARG_EEPROM_Write_Address+0
	MOVF       main_SW+0, 0
	MOVWF      FARG_EEPROM_Write_data_+0
	CALL       _EEPROM_Write+0
;main.c,128 :: 		EEPROM_Write(252, swr_a/256);
	MOVLW      252
	MOVWF      FARG_EEPROM_Write_Address+0
	MOVF       _swr_a+1, 0
	MOVWF      R0
	MOVLW      0
	BTFSC      _swr_a+1, 7
	MOVLW      255
	MOVWF      R1
	MOVF       R0, 0
	MOVWF      FARG_EEPROM_Write_data_+0
	CALL       _EEPROM_Write+0
;main.c,129 :: 		EEPROM_Write(251, swr_a%256);
	MOVLW      251
	MOVWF      FARG_EEPROM_Write_Address+0
	MOVLW      0
	MOVWF      R4
	MOVLW      1
	MOVWF      R5
	MOVF       _swr_a+0, 0
	MOVWF      R0
	MOVF       _swr_a+1, 0
	MOVWF      R1
	CALL       _Div_16x16_S+0
	MOVF       R8, 0
	MOVWF      R0
	MOVF       R9, 0
	MOVWF      R1
	MOVF       R0, 0
	MOVWF      FARG_EEPROM_Write_data_+0
	CALL       _EEPROM_Write+0
;main.c,131 :: 		if(type==4 | type==5) {    // 128*64 OLED
	MOVF       _type+0, 0
	XORLW      4
	MOVLW      1
	BTFSS      STATUS+0, 2
	MOVLW      0
	MOVWF      R1
	MOVF       _type+0, 0
	XORLW      5
	MOVLW      1
	BTFSS      STATUS+0, 2
	MOVLW      0
	MOVWF      R0
	MOVF       R1, 0
	IORWF       R0, 1
	BTFSC      STATUS+0, 2
	GOTO       L_button_proc_test201
;main.c,132 :: 		led_wr_str (2, 16, "AUTO    ", 8);
	MOVLW      2
	MOVWF      FARG_led_wr_str+0
	MOVLW      16
	MOVWF      FARG_led_wr_str+0
	MOVLW      ?lstr5_main+0
	MOVWF      FARG_led_wr_str+0
	MOVLW      hi_addr(?lstr5_main+0)
	MOVWF      FARG_led_wr_str+1
	MOVLW      8
	MOVWF      FARG_led_wr_str+0
	CALL       _led_wr_str+0
;main.c,133 :: 		asm CLRWDT;
	CLRWDT
;main.c,134 :: 		delay_ms(1000);
	MOVLW      21
	MOVWF      R11
	MOVLW      75
	MOVWF      R12
	MOVLW      190
	MOVWF      R13
L_button_proc_test202:
	DECFSZ     R13, 1
	GOTO       L_button_proc_test202
	DECFSZ     R12, 1
	GOTO       L_button_proc_test202
	DECFSZ     R11, 1
	GOTO       L_button_proc_test202
	NOP
;main.c,135 :: 		led_wr_str (2, 16, "SWR=0.00", 8);
	MOVLW      2
	MOVWF      FARG_led_wr_str+0
	MOVLW      16
	MOVWF      FARG_led_wr_str+0
	MOVLW      ?lstr6_main+0
	MOVWF      FARG_led_wr_str+0
	MOVLW      hi_addr(?lstr6_main+0)
	MOVWF      FARG_led_wr_str+1
	MOVLW      8
	MOVWF      FARG_led_wr_str+0
	CALL       _led_wr_str+0
;main.c,136 :: 		if(Auto & !Bypas) led_wr_str (0, 16+8*12, ".", 1);
	MOVF       _bypas+0, 0
	MOVLW      1
	BTFSS      STATUS+0, 2
	MOVLW      0
	MOVWF      R0
	MOVF       _Auto+0, 0
	ANDWF      R0, 1
	BTFSC      STATUS+0, 2
	GOTO       L_button_proc_test203
	CLRF       FARG_led_wr_str+0
	MOVLW      112
	MOVWF      FARG_led_wr_str+0
	MOVLW      ?lstr7_main+0
	MOVWF      FARG_led_wr_str+0
	MOVLW      hi_addr(?lstr7_main+0)
	MOVWF      FARG_led_wr_str+1
	MOVLW      1
	MOVWF      FARG_led_wr_str+0
	CALL       _led_wr_str+0
	GOTO       L_button_proc_test204
L_button_proc_test203:
;main.c,138 :: 		else led_wr_str (0, 16+8*12, " ", 1);
	CLRF       FARG_led_wr_str+0
	MOVLW      112
	MOVWF      FARG_led_wr_str+0
	MOVLW      ?lstr8_main+0
	MOVWF      FARG_led_wr_str+0
	MOVLW      hi_addr(?lstr8_main+0)
	MOVWF      FARG_led_wr_str+1
	MOVLW      1
	MOVWF      FARG_led_wr_str+0
	CALL       _led_wr_str+0
L_button_proc_test204:
;main.c,139 :: 		asm CLRWDT;
	CLRWDT
;main.c,140 :: 		}
	GOTO       L_button_proc_test205
L_button_proc_test201:
;main.c,141 :: 		else if(type!=0) {// 1602 LCD & 128*32 OLED
	MOVF       _type+0, 0
	XORLW      0
	BTFSC      STATUS+0, 2
	GOTO       L_button_proc_test206
;main.c,142 :: 		led_wr_str (1, 0, "AUTO    ", 8);
	MOVLW      1
	MOVWF      FARG_led_wr_str+0
	CLRF       FARG_led_wr_str+0
	MOVLW      ?lstr9_main+0
	MOVWF      FARG_led_wr_str+0
	MOVLW      hi_addr(?lstr9_main+0)
	MOVWF      FARG_led_wr_str+1
	MOVLW      8
	MOVWF      FARG_led_wr_str+0
	CALL       _led_wr_str+0
;main.c,143 :: 		asm CLRWDT;
	CLRWDT
;main.c,144 :: 		delay_ms(1000);
	MOVLW      21
	MOVWF      R11
	MOVLW      75
	MOVWF      R12
	MOVLW      190
	MOVWF      R13
L_button_proc_test207:
	DECFSZ     R13, 1
	GOTO       L_button_proc_test207
	DECFSZ     R12, 1
	GOTO       L_button_proc_test207
	DECFSZ     R11, 1
	GOTO       L_button_proc_test207
	NOP
;main.c,145 :: 		led_wr_str (1, 0, "SWR=0.00", 8);
	MOVLW      1
	MOVWF      FARG_led_wr_str+0
	CLRF       FARG_led_wr_str+0
	MOVLW      ?lstr10_main+0
	MOVWF      FARG_led_wr_str+0
	MOVLW      hi_addr(?lstr10_main+0)
	MOVWF      FARG_led_wr_str+1
	MOVLW      8
	MOVWF      FARG_led_wr_str+0
	CALL       _led_wr_str+0
;main.c,146 :: 		if(Auto & !Bypas) led_wr_str (0, 8, ".", 1);
	MOVF       _bypas+0, 0
	MOVLW      1
	BTFSS      STATUS+0, 2
	MOVLW      0
	MOVWF      R0
	MOVF       _Auto+0, 0
	ANDWF      R0, 1
	BTFSC      STATUS+0, 2
	GOTO       L_button_proc_test208
	CLRF       FARG_led_wr_str+0
	MOVLW      8
	MOVWF      FARG_led_wr_str+0
	MOVLW      ?lstr11_main+0
	MOVWF      FARG_led_wr_str+0
	MOVLW      hi_addr(?lstr11_main+0)
	MOVWF      FARG_led_wr_str+1
	MOVLW      1
	MOVWF      FARG_led_wr_str+0
	CALL       _led_wr_str+0
	GOTO       L_button_proc_test209
L_button_proc_test208:
;main.c,148 :: 		else led_wr_str (0, 8, " ", 1);
	CLRF       FARG_led_wr_str+0
	MOVLW      8
	MOVWF      FARG_led_wr_str+0
	MOVLW      ?lstr12_main+0
	MOVWF      FARG_led_wr_str+0
	MOVLW      hi_addr(?lstr12_main+0)
	MOVWF      FARG_led_wr_str+1
	MOVLW      1
	MOVWF      FARG_led_wr_str+0
	CALL       _led_wr_str+0
L_button_proc_test209:
;main.c,149 :: 		asm CLRWDT;
	CLRWDT
;main.c,150 :: 		}
L_button_proc_test206:
L_button_proc_test205:
;main.c,151 :: 		}
L_button_proc_test199:
;main.c,152 :: 		}
L_button_proc_test187:
;main.c,153 :: 		while(Button(&PORTB, 0, 50, 0)) {lcd_pwr(); asm CLRWDT ;   }
L_button_proc_test210:
	MOVLW      PORTB+0
	MOVWF      FARG_Button_port+0
	MOVLW      hi_addr(PORTB+0)
	MOVWF      FARG_Button_port+1
	CLRF       FARG_Button_pin+0
	MOVLW      50
	MOVWF      FARG_Button_time_ms+0
	CLRF       FARG_Button_active_state+0
	CALL       _Button+0
	MOVF       R0, 0
	BTFSC      STATUS+0, 2
	GOTO       L_button_proc_test211
	CALL       _lcd_pwr+0
	CLRWDT
	GOTO       L_button_proc_test210
L_button_proc_test211:
;main.c,154 :: 		}  // END Tune btn
L_button_proc_test182:
;main.c,156 :: 		if(Button(&PORTB, 2, 50, 0)){   // BYP button
	MOVLW      PORTB+0
	MOVWF      FARG_Button_port+0
	MOVLW      hi_addr(PORTB+0)
	MOVWF      FARG_Button_port+1
	MOVLW      2
	MOVWF      FARG_Button_pin+0
	MOVLW      50
	MOVWF      FARG_Button_time_ms+0
	CLRF       FARG_Button_active_state+0
	CALL       _Button+0
	MOVF       R0, 0
	BTFSC      STATUS+0, 2
	GOTO       L_button_proc_test212
;main.c,157 :: 		asm CLRWDT;
	CLRWDT
;main.c,158 :: 		while(PORTB.B2==0) {
L_button_proc_test213:
	BTFSC      PORTB+0, 2
	GOTO       L_button_proc_test214
;main.c,159 :: 		if(L & ind<32*L_mult-1) {
	MOVLW      5
	MOVWF      R2
	MOVF       main_L_mult+0, 0
	MOVWF      R0
	CLRF       R1
	MOVF       R2, 0
L__button_proc_test688:
	BTFSC      STATUS+0, 2
	GOTO       L__button_proc_test689
	LSLF       R0, 1
	RLF        R1, 1
	ADDLW      255
	GOTO       L__button_proc_test688
L__button_proc_test689:
	MOVLW      1
	SUBWF      R0, 0
	MOVWF      R2
	MOVLW      0
	SUBWFB     R1, 0
	MOVWF      R3
	MOVLW      128
	MOVWF      R0
	MOVLW      128
	XORWF      R3, 0
	SUBWF      R0, 0
	BTFSS      STATUS+0, 2
	GOTO       L__button_proc_test690
	MOVF       R2, 0
	SUBWF      main_ind+0, 0
L__button_proc_test690:
	MOVLW      1
	BTFSC      STATUS+0, 0
	MOVLW      0
	MOVWF      R0
	MOVF       _L+0, 0
	ANDWF      R0, 1
	BTFSC      STATUS+0, 2
	GOTO       L_button_proc_test215
;main.c,160 :: 		ind ++;
	INCF       main_ind+0, 1
;main.c,161 :: 		set_ind(ind);
	MOVF       main_ind+0, 0
	MOVWF      FARG_set_ind_Ind+0
	CALL       _set_ind+0
;main.c,162 :: 		}
	GOTO       L_button_proc_test216
L_button_proc_test215:
;main.c,163 :: 		else if(!L & cap<32*L_mult-1) {
	MOVF       _L+0, 0
	MOVLW      1
	BTFSS      STATUS+0, 2
	MOVLW      0
	MOVWF      R4
	MOVLW      5
	MOVWF      R2
	MOVF       main_L_mult+0, 0
	MOVWF      R0
	CLRF       R1
	MOVF       R2, 0
L__button_proc_test691:
	BTFSC      STATUS+0, 2
	GOTO       L__button_proc_test692
	LSLF       R0, 1
	RLF        R1, 1
	ADDLW      255
	GOTO       L__button_proc_test691
L__button_proc_test692:
	MOVLW      1
	SUBWF      R0, 0
	MOVWF      R2
	MOVLW      0
	SUBWFB     R1, 0
	MOVWF      R3
	MOVLW      128
	MOVWF      R0
	MOVLW      128
	XORWF      R3, 0
	SUBWF      R0, 0
	BTFSS      STATUS+0, 2
	GOTO       L__button_proc_test693
	MOVF       R2, 0
	SUBWF      main_cap+0, 0
L__button_proc_test693:
	MOVLW      1
	BTFSC      STATUS+0, 0
	MOVLW      0
	MOVWF      R0
	MOVF       R4, 0
	ANDWF      R0, 1
	BTFSC      STATUS+0, 2
	GOTO       L_button_proc_test217
;main.c,164 :: 		cap ++;
	INCF       main_cap+0, 1
;main.c,165 :: 		set_cap(cap);
	MOVF       main_cap+0, 0
	MOVWF      FARG_set_cap_Cap+0
	CALL       _set_cap+0
;main.c,166 :: 		}
L_button_proc_test217:
L_button_proc_test216:
;main.c,167 :: 		lcd_ind();
	CALL       _lcd_ind+0
;main.c,168 :: 		lcd_pwr();
	CALL       _lcd_pwr+0
;main.c,169 :: 		Delay_ms(30);
	MOVLW      156
	MOVWF      R12
	MOVLW      215
	MOVWF      R13
L_button_proc_test218:
	DECFSZ     R13, 1
	GOTO       L_button_proc_test218
	DECFSZ     R12, 1
	GOTO       L_button_proc_test218
;main.c,170 :: 		asm CLRWDT;
	CLRWDT
;main.c,171 :: 		}
	GOTO       L_button_proc_test213
L_button_proc_test214:
;main.c,172 :: 		}
L_button_proc_test212:
;main.c,175 :: 		if(Button(&PORTB, 1, 50, 0) & Bypas==0){   // Auto button
	MOVLW      PORTB+0
	MOVWF      FARG_Button_port+0
	MOVLW      hi_addr(PORTB+0)
	MOVWF      FARG_Button_port+1
	MOVLW      1
	MOVWF      FARG_Button_pin+0
	MOVLW      50
	MOVWF      FARG_Button_time_ms+0
	CLRF       FARG_Button_active_state+0
	CALL       _Button+0
	MOVF       _bypas+0, 0
	XORLW      0
	MOVLW      1
	BTFSS      STATUS+0, 2
	MOVLW      0
	MOVWF      R1
	MOVF       R1, 0
	ANDWF      R0, 1
	BTFSC      STATUS+0, 2
	GOTO       L_button_proc_test219
;main.c,176 :: 		asm CLRWDT;
	CLRWDT
;main.c,177 :: 		while(PORTB.B1==0) {
L_button_proc_test220:
	BTFSC      PORTB+0, 1
	GOTO       L_button_proc_test221
;main.c,178 :: 		if(L & ind>0) {
	MOVF       main_ind+0, 0
	SUBLW      0
	MOVLW      1
	BTFSC      STATUS+0, 0
	MOVLW      0
	MOVWF      R0
	MOVF       _L+0, 0
	ANDWF      R0, 1
	BTFSC      STATUS+0, 2
	GOTO       L_button_proc_test222
;main.c,179 :: 		ind --;
	DECF       main_ind+0, 1
;main.c,180 :: 		set_ind(ind);
	MOVF       main_ind+0, 0
	MOVWF      FARG_set_ind_Ind+0
	CALL       _set_ind+0
;main.c,181 :: 		}
	GOTO       L_button_proc_test223
L_button_proc_test222:
;main.c,182 :: 		else if(!L & cap>0) {
	MOVF       _L+0, 0
	MOVLW      1
	BTFSS      STATUS+0, 2
	MOVLW      0
	MOVWF      R1
	MOVF       main_cap+0, 0
	SUBLW      0
	MOVLW      1
	BTFSC      STATUS+0, 0
	MOVLW      0
	MOVWF      R0
	MOVF       R1, 0
	ANDWF      R0, 1
	BTFSC      STATUS+0, 2
	GOTO       L_button_proc_test224
;main.c,183 :: 		cap --;
	DECF       main_cap+0, 1
;main.c,184 :: 		set_cap(cap);
	MOVF       main_cap+0, 0
	MOVWF      FARG_set_cap_Cap+0
	CALL       _set_cap+0
;main.c,185 :: 		}
L_button_proc_test224:
L_button_proc_test223:
;main.c,186 :: 		lcd_ind();
	CALL       _lcd_ind+0
;main.c,187 :: 		lcd_pwr();
	CALL       _lcd_pwr+0
;main.c,188 :: 		Delay_ms(30);
	MOVLW      156
	MOVWF      R12
	MOVLW      215
	MOVWF      R13
L_button_proc_test225:
	DECFSZ     R13, 1
	GOTO       L_button_proc_test225
	DECFSZ     R12, 1
	GOTO       L_button_proc_test225
;main.c,189 :: 		asm CLRWDT;
	CLRWDT
;main.c,190 :: 		}
	GOTO       L_button_proc_test220
L_button_proc_test221:
;main.c,191 :: 		}
L_button_proc_test219:
;main.c,192 :: 		return;
;main.c,193 :: 		}
L_end_button_proc_test:
	RETURN
; end of _button_proc_test

_button_proc:

;main.c,195 :: 		void button_proc(void) {
;main.c,196 :: 		if(Button(&PORTB, 0, 50, 0) | Soft_tune){
	MOVLW      PORTB+0
	MOVWF      FARG_Button_port+0
	MOVLW      hi_addr(PORTB+0)
	MOVWF      FARG_Button_port+1
	CLRF       FARG_Button_pin+0
	MOVLW      50
	MOVWF      FARG_Button_time_ms+0
	CLRF       FARG_Button_active_state+0
	CALL       _Button+0
	MOVF       _Soft_tune+0, 0
	IORWF       R0, 1
	BTFSC      STATUS+0, 2
	GOTO       L_button_proc226
;main.c,197 :: 		dysp_on();
	CALL       _dysp_on+0
;main.c,198 :: 		dysp_cnt = Dysp_delay * dysp_cnt_mult;
	MOVF       _Dysp_delay+0, 0
	MOVWF      R0
	CALL       _Byte2Double+0
	MOVF       _dysp_cnt_mult+0, 0
	MOVWF      R4
	MOVF       _dysp_cnt_mult+1, 0
	MOVWF      R5
	MOVF       _dysp_cnt_mult+2, 0
	MOVWF      R6
	MOVF       _dysp_cnt_mult+3, 0
	MOVWF      R7
	CALL       _Mul_32x32_FP+0
	CALL       _Double2Int+0
	MOVF       R0, 0
	MOVWF      _dysp_cnt+0
	MOVF       R1, 0
	MOVWF      _dysp_cnt+1
;main.c,199 :: 		Delay_ms(250);
	MOVLW      6
	MOVWF      R11
	MOVLW      19
	MOVWF      R12
	MOVLW      173
	MOVWF      R13
L_button_proc227:
	DECFSZ     R13, 1
	GOTO       L_button_proc227
	DECFSZ     R12, 1
	GOTO       L_button_proc227
	DECFSZ     R11, 1
	GOTO       L_button_proc227
	NOP
	NOP
;main.c,200 :: 		asm CLRWDT;
	CLRWDT
;main.c,201 :: 		if(Soft_tune == 0 & PORTB.B0==1) { // short press button
	MOVF       _Soft_tune+0, 0
	XORLW      0
	MOVLW      1
	BTFSS      STATUS+0, 2
	MOVLW      0
	MOVWF      R1
	BTFSC      PORTB+0, 0
	GOTO       L__button_proc695
	BCF        3, 0
	GOTO       L__button_proc696
L__button_proc695:
	BSF        3, 0
L__button_proc696:
	CLRF       R0
	BTFSC      3, 0
	INCF       R0, 1
	MOVF       R1, 0
	ANDWF      R0, 1
	BTFSC      STATUS+0, 2
	GOTO       L_button_proc228
;main.c,202 :: 		show_reset();
	CALL       _show_reset+0
;main.c,203 :: 		bypas =0;
	CLRF       _bypas+0
;main.c,204 :: 		}
	GOTO       L_button_proc229
L_button_proc228:
;main.c,206 :: 		p_Tx = 1;         //
	BSF        LATA7_bit+0, BitPos(LATA7_bit+0)
;main.c,207 :: 		n_Tx = 0;         // TX request
	BCF        LATA6_bit+0, BitPos(LATA6_bit+0)
;main.c,208 :: 		Delay_ms(250);    //
	MOVLW      6
	MOVWF      R11
	MOVLW      19
	MOVWF      R12
	MOVLW      173
	MOVWF      R13
L_button_proc230:
	DECFSZ     R13, 1
	GOTO       L_button_proc230
	DECFSZ     R12, 1
	GOTO       L_button_proc230
	DECFSZ     R11, 1
	GOTO       L_button_proc230
	NOP
	NOP
;main.c,209 :: 		btn_push();
	CALL       _btn_push+0
;main.c,210 :: 		bypas = 0;
	CLRF       _bypas+0
;main.c,211 :: 		while(Button(&PORTB, 0, 50, 0)) {lcd_pwr(); asm CLRWDT; }
L_button_proc231:
	MOVLW      PORTB+0
	MOVWF      FARG_Button_port+0
	MOVLW      hi_addr(PORTB+0)
	MOVWF      FARG_Button_port+1
	CLRF       FARG_Button_pin+0
	MOVLW      50
	MOVWF      FARG_Button_time_ms+0
	CLRF       FARG_Button_active_state+0
	CALL       _Button+0
	MOVF       R0, 0
	BTFSC      STATUS+0, 2
	GOTO       L_button_proc232
	CALL       _lcd_pwr+0
	CLRWDT
	GOTO       L_button_proc231
L_button_proc232:
;main.c,212 :: 		Soft_tune = 0;
	CLRF       _Soft_tune+0
;main.c,213 :: 		}
L_button_proc229:
;main.c,214 :: 		}
L_button_proc226:
;main.c,216 :: 		if(Button(&PORTB, 2, 50, 0)){   // BYP button
	MOVLW      PORTB+0
	MOVWF      FARG_Button_port+0
	MOVLW      hi_addr(PORTB+0)
	MOVWF      FARG_Button_port+1
	MOVLW      2
	MOVWF      FARG_Button_pin+0
	MOVLW      50
	MOVWF      FARG_Button_time_ms+0
	CLRF       FARG_Button_active_state+0
	CALL       _Button+0
	MOVF       R0, 0
	BTFSC      STATUS+0, 2
	GOTO       L_button_proc233
;main.c,217 :: 		Delay_ms(450);
	MOVLW      10
	MOVWF      R11
	MOVLW      34
	MOVWF      R12
	MOVLW      161
	MOVWF      R13
L_button_proc234:
	DECFSZ     R13, 1
	GOTO       L_button_proc234
	DECFSZ     R12, 1
	GOTO       L_button_proc234
	DECFSZ     R11, 1
	GOTO       L_button_proc234
;main.c,218 :: 		if(PORTB.B2==1) { // short press button
	BTFSS      PORTB+0, 2
	GOTO       L_button_proc235
;main.c,219 :: 		dysp_on();
	CALL       _dysp_on+0
;main.c,220 :: 		dysp_cnt = Dysp_delay * dysp_cnt_mult;
	MOVF       _Dysp_delay+0, 0
	MOVWF      R0
	CALL       _Byte2Double+0
	MOVF       _dysp_cnt_mult+0, 0
	MOVWF      R4
	MOVF       _dysp_cnt_mult+1, 0
	MOVWF      R5
	MOVF       _dysp_cnt_mult+2, 0
	MOVWF      R6
	MOVF       _dysp_cnt_mult+3, 0
	MOVWF      R7
	CALL       _Mul_32x32_FP+0
	CALL       _Double2Int+0
	MOVF       R0, 0
	MOVWF      _dysp_cnt+0
	MOVF       R1, 0
	MOVWF      _dysp_cnt+1
;main.c,221 :: 		asm CLRWDT;
	CLRWDT
;main.c,222 :: 		if(bypas == 0) {
	MOVF       _bypas+0, 0
	XORLW      0
	BTFSS      STATUS+0, 2
	GOTO       L_button_proc236
;main.c,223 :: 		bypas = 1;
	MOVLW      1
	MOVWF      _bypas+0
;main.c,224 :: 		cap_mem = cap;
	MOVF       main_cap+0, 0
	MOVWF      _cap_mem+0
;main.c,225 :: 		ind_mem = ind;
	MOVF       main_ind+0, 0
	MOVWF      _ind_mem+0
;main.c,226 :: 		SW_mem = SW;
	MOVF       main_SW+0, 0
	MOVWF      _SW_mem+0
;main.c,227 :: 		cap = 0;
	CLRF       main_cap+0
;main.c,228 :: 		ind = 0;
	CLRF       main_ind+0
;main.c,229 :: 		SW = 1;
	MOVLW      1
	MOVWF      main_SW+0
;main.c,230 :: 		set_ind(ind);
	CLRF       FARG_set_ind_Ind+0
	CALL       _set_ind+0
;main.c,231 :: 		set_cap(cap);
	MOVF       main_cap+0, 0
	MOVWF      FARG_set_cap_Cap+0
	CALL       _set_cap+0
;main.c,232 :: 		set_SW(SW);
	MOVF       main_SW+0, 0
	MOVWF      FARG_set_sw_SW+0
	CALL       _set_sw+0
;main.c,233 :: 		if(Loss_mode==0) lcd_ind();
	MOVF       _Loss_mode+0, 0
	XORLW      0
	BTFSS      STATUS+0, 2
	GOTO       L_button_proc237
	CALL       _lcd_ind+0
L_button_proc237:
;main.c,234 :: 		Auto_mem = Auto;
	MOVF       _Auto+0, 0
	MOVWF      _Auto_mem+0
;main.c,235 :: 		Auto = 0;
	CLRF       _Auto+0
;main.c,236 :: 		}
	GOTO       L_button_proc238
L_button_proc236:
;main.c,238 :: 		bypas = 0;
	CLRF       _bypas+0
;main.c,239 :: 		cap = cap_mem;
	MOVF       _cap_mem+0, 0
	MOVWF      main_cap+0
;main.c,240 :: 		ind = ind_mem;
	MOVF       _ind_mem+0, 0
	MOVWF      main_ind+0
;main.c,241 :: 		SW = SW_mem;
	MOVF       _SW_mem+0, 0
	MOVWF      main_SW+0
;main.c,242 :: 		set_cap(cap);
	MOVF       _cap_mem+0, 0
	MOVWF      FARG_set_cap_Cap+0
	CALL       _set_cap+0
;main.c,243 :: 		set_ind(ind);
	MOVF       main_ind+0, 0
	MOVWF      FARG_set_ind_Ind+0
	CALL       _set_ind+0
;main.c,244 :: 		set_SW(SW);
	MOVF       main_SW+0, 0
	MOVWF      FARG_set_sw_SW+0
	CALL       _set_sw+0
;main.c,245 :: 		if(Loss_mode==0) lcd_ind();
	MOVF       _Loss_mode+0, 0
	XORLW      0
	BTFSS      STATUS+0, 2
	GOTO       L_button_proc239
	CALL       _lcd_ind+0
L_button_proc239:
;main.c,246 :: 		Auto = Auto_mem;
	MOVF       _Auto_mem+0, 0
	MOVWF      _Auto+0
;main.c,247 :: 		}
L_button_proc238:
;main.c,248 :: 		if(type==4 | type==5) {      // 128*64 OLED
	MOVF       _type+0, 0
	XORLW      4
	MOVLW      1
	BTFSS      STATUS+0, 2
	MOVLW      0
	MOVWF      R1
	MOVF       _type+0, 0
	XORLW      5
	MOVLW      1
	BTFSS      STATUS+0, 2
	MOVLW      0
	MOVWF      R0
	MOVF       R1, 0
	IORWF       R0, 1
	BTFSC      STATUS+0, 2
	GOTO       L_button_proc240
;main.c,249 :: 		if(Auto & !Bypas) led_wr_str (0, 16+8*12, ".", 1);
	MOVF       _bypas+0, 0
	MOVLW      1
	BTFSS      STATUS+0, 2
	MOVLW      0
	MOVWF      R0
	MOVF       _Auto+0, 0
	ANDWF      R0, 1
	BTFSC      STATUS+0, 2
	GOTO       L_button_proc241
	CLRF       FARG_led_wr_str+0
	MOVLW      112
	MOVWF      FARG_led_wr_str+0
	MOVLW      ?lstr13_main+0
	MOVWF      FARG_led_wr_str+0
	MOVLW      hi_addr(?lstr13_main+0)
	MOVWF      FARG_led_wr_str+1
	MOVLW      1
	MOVWF      FARG_led_wr_str+0
	CALL       _led_wr_str+0
	GOTO       L_button_proc242
L_button_proc241:
;main.c,250 :: 		else if(!Auto & Bypas) led_wr_str (0, 16+8*12, "_", 1);
	MOVF       _Auto+0, 0
	MOVLW      1
	BTFSS      STATUS+0, 2
	MOVLW      0
	MOVWF      R0
	MOVF       _bypas+0, 0
	ANDWF      R0, 1
	BTFSC      STATUS+0, 2
	GOTO       L_button_proc243
	CLRF       FARG_led_wr_str+0
	MOVLW      112
	MOVWF      FARG_led_wr_str+0
	MOVLW      ?lstr14_main+0
	MOVWF      FARG_led_wr_str+0
	MOVLW      hi_addr(?lstr14_main+0)
	MOVWF      FARG_led_wr_str+1
	MOVLW      1
	MOVWF      FARG_led_wr_str+0
	CALL       _led_wr_str+0
	GOTO       L_button_proc244
L_button_proc243:
;main.c,251 :: 		else led_wr_str (0, 16+8*12, " ", 1);
	CLRF       FARG_led_wr_str+0
	MOVLW      112
	MOVWF      FARG_led_wr_str+0
	MOVLW      ?lstr15_main+0
	MOVWF      FARG_led_wr_str+0
	MOVLW      hi_addr(?lstr15_main+0)
	MOVWF      FARG_led_wr_str+1
	MOVLW      1
	MOVWF      FARG_led_wr_str+0
	CALL       _led_wr_str+0
L_button_proc244:
L_button_proc242:
;main.c,252 :: 		}
	GOTO       L_button_proc245
L_button_proc240:
;main.c,253 :: 		else if(type!=0) { //  1602 LCD  or 128*32 OLED
	MOVF       _type+0, 0
	XORLW      0
	BTFSC      STATUS+0, 2
	GOTO       L_button_proc246
;main.c,254 :: 		if(Auto & !Bypas) led_wr_str (0, 8, ".", 1);
	MOVF       _bypas+0, 0
	MOVLW      1
	BTFSS      STATUS+0, 2
	MOVLW      0
	MOVWF      R0
	MOVF       _Auto+0, 0
	ANDWF      R0, 1
	BTFSC      STATUS+0, 2
	GOTO       L_button_proc247
	CLRF       FARG_led_wr_str+0
	MOVLW      8
	MOVWF      FARG_led_wr_str+0
	MOVLW      ?lstr16_main+0
	MOVWF      FARG_led_wr_str+0
	MOVLW      hi_addr(?lstr16_main+0)
	MOVWF      FARG_led_wr_str+1
	MOVLW      1
	MOVWF      FARG_led_wr_str+0
	CALL       _led_wr_str+0
	GOTO       L_button_proc248
L_button_proc247:
;main.c,255 :: 		else if(!Auto & Bypas) led_wr_str (0, 8, "_", 1);
	MOVF       _Auto+0, 0
	MOVLW      1
	BTFSS      STATUS+0, 2
	MOVLW      0
	MOVWF      R0
	MOVF       _bypas+0, 0
	ANDWF      R0, 1
	BTFSC      STATUS+0, 2
	GOTO       L_button_proc249
	CLRF       FARG_led_wr_str+0
	MOVLW      8
	MOVWF      FARG_led_wr_str+0
	MOVLW      ?lstr17_main+0
	MOVWF      FARG_led_wr_str+0
	MOVLW      hi_addr(?lstr17_main+0)
	MOVWF      FARG_led_wr_str+1
	MOVLW      1
	MOVWF      FARG_led_wr_str+0
	CALL       _led_wr_str+0
	GOTO       L_button_proc250
L_button_proc249:
;main.c,256 :: 		else led_wr_str (0, 8, " ", 1);
	CLRF       FARG_led_wr_str+0
	MOVLW      8
	MOVWF      FARG_led_wr_str+0
	MOVLW      ?lstr18_main+0
	MOVWF      FARG_led_wr_str+0
	MOVLW      hi_addr(?lstr18_main+0)
	MOVWF      FARG_led_wr_str+1
	MOVLW      1
	MOVWF      FARG_led_wr_str+0
	CALL       _led_wr_str+0
L_button_proc250:
L_button_proc248:
;main.c,257 :: 		}
L_button_proc246:
L_button_proc245:
;main.c,258 :: 		asm CLRWDT;
	CLRWDT
;main.c,259 :: 		while(Button(&PORTB, 2, 50, 0)) {lcd_pwr(); asm CLRWDT;   }
L_button_proc251:
	MOVLW      PORTB+0
	MOVWF      FARG_Button_port+0
	MOVLW      hi_addr(PORTB+0)
	MOVWF      FARG_Button_port+1
	MOVLW      2
	MOVWF      FARG_Button_pin+0
	MOVLW      50
	MOVWF      FARG_Button_time_ms+0
	CLRF       FARG_Button_active_state+0
	CALL       _Button+0
	MOVF       R0, 0
	BTFSC      STATUS+0, 2
	GOTO       L_button_proc252
	CALL       _lcd_pwr+0
	CLRWDT
	GOTO       L_button_proc251
L_button_proc252:
;main.c,260 :: 		}
	GOTO       L_button_proc253
L_button_proc235:
;main.c,262 :: 		if (bypas==0 & type!=0) {   // long press button
	MOVF       _bypas+0, 0
	XORLW      0
	MOVLW      1
	BTFSS      STATUS+0, 2
	MOVLW      0
	MOVWF      R1
	MOVF       _type+0, 0
	XORLW      0
	MOVLW      1
	BTFSC      STATUS+0, 2
	MOVLW      0
	MOVWF      R0
	MOVF       R1, 0
	ANDWF      R0, 1
	BTFSC      STATUS+0, 2
	GOTO       L_button_proc254
;main.c,263 :: 		Test = 1;
	MOVLW      1
	MOVWF      _Test+0
;main.c,264 :: 		Auto = 0;
	CLRF       _Auto+0
;main.c,265 :: 		if(type==4 | type==5) {    // 128*64 OLED
	MOVF       _type+0, 0
	XORLW      4
	MOVLW      1
	BTFSS      STATUS+0, 2
	MOVLW      0
	MOVWF      R1
	MOVF       _type+0, 0
	XORLW      5
	MOVLW      1
	BTFSS      STATUS+0, 2
	MOVLW      0
	MOVWF      R0
	MOVF       R1, 0
	IORWF       R0, 1
	BTFSC      STATUS+0, 2
	GOTO       L_button_proc255
;main.c,266 :: 		led_wr_str (2, 16, "MANUAL  ", 8);
	MOVLW      2
	MOVWF      FARG_led_wr_str+0
	MOVLW      16
	MOVWF      FARG_led_wr_str+0
	MOVLW      ?lstr19_main+0
	MOVWF      FARG_led_wr_str+0
	MOVLW      hi_addr(?lstr19_main+0)
	MOVWF      FARG_led_wr_str+1
	MOVLW      8
	MOVWF      FARG_led_wr_str+0
	CALL       _led_wr_str+0
;main.c,267 :: 		asm CLRWDT;
	CLRWDT
;main.c,268 :: 		delay_ms(1000);
	MOVLW      21
	MOVWF      R11
	MOVLW      75
	MOVWF      R12
	MOVLW      190
	MOVWF      R13
L_button_proc256:
	DECFSZ     R13, 1
	GOTO       L_button_proc256
	DECFSZ     R12, 1
	GOTO       L_button_proc256
	DECFSZ     R11, 1
	GOTO       L_button_proc256
	NOP
;main.c,269 :: 		led_wr_str (2, 16, "SWR=0.00", 8);
	MOVLW      2
	MOVWF      FARG_led_wr_str+0
	MOVLW      16
	MOVWF      FARG_led_wr_str+0
	MOVLW      ?lstr20_main+0
	MOVWF      FARG_led_wr_str+0
	MOVLW      hi_addr(?lstr20_main+0)
	MOVWF      FARG_led_wr_str+1
	MOVLW      8
	MOVWF      FARG_led_wr_str+0
	CALL       _led_wr_str+0
;main.c,270 :: 		if(L==1) led_wr_str (0, 16+8*12, "l", 1); else led_wr_str (0, 16+8*12, "c", 1);
	MOVF       _L+0, 0
	XORLW      1
	BTFSS      STATUS+0, 2
	GOTO       L_button_proc257
	CLRF       FARG_led_wr_str+0
	MOVLW      112
	MOVWF      FARG_led_wr_str+0
	MOVLW      ?lstr21_main+0
	MOVWF      FARG_led_wr_str+0
	MOVLW      hi_addr(?lstr21_main+0)
	MOVWF      FARG_led_wr_str+1
	MOVLW      1
	MOVWF      FARG_led_wr_str+0
	CALL       _led_wr_str+0
	GOTO       L_button_proc258
L_button_proc257:
	CLRF       FARG_led_wr_str+0
	MOVLW      112
	MOVWF      FARG_led_wr_str+0
	MOVLW      ?lstr22_main+0
	MOVWF      FARG_led_wr_str+0
	MOVLW      hi_addr(?lstr22_main+0)
	MOVWF      FARG_led_wr_str+1
	MOVLW      1
	MOVWF      FARG_led_wr_str+0
	CALL       _led_wr_str+0
L_button_proc258:
;main.c,271 :: 		asm CLRWDT;
	CLRWDT
;main.c,272 :: 		}
	GOTO       L_button_proc259
L_button_proc255:
;main.c,273 :: 		else if(type!=0) {// 1602 LCD & 128*32 OLED
	MOVF       _type+0, 0
	XORLW      0
	BTFSC      STATUS+0, 2
	GOTO       L_button_proc260
;main.c,274 :: 		led_wr_str (1, 0, "MANUAL  ", 8);
	MOVLW      1
	MOVWF      FARG_led_wr_str+0
	CLRF       FARG_led_wr_str+0
	MOVLW      ?lstr23_main+0
	MOVWF      FARG_led_wr_str+0
	MOVLW      hi_addr(?lstr23_main+0)
	MOVWF      FARG_led_wr_str+1
	MOVLW      8
	MOVWF      FARG_led_wr_str+0
	CALL       _led_wr_str+0
;main.c,275 :: 		asm CLRWDT;
	CLRWDT
;main.c,276 :: 		delay_ms(1000);
	MOVLW      21
	MOVWF      R11
	MOVLW      75
	MOVWF      R12
	MOVLW      190
	MOVWF      R13
L_button_proc261:
	DECFSZ     R13, 1
	GOTO       L_button_proc261
	DECFSZ     R12, 1
	GOTO       L_button_proc261
	DECFSZ     R11, 1
	GOTO       L_button_proc261
	NOP
;main.c,277 :: 		led_wr_str (1, 0, "SWR=0.00", 8);
	MOVLW      1
	MOVWF      FARG_led_wr_str+0
	CLRF       FARG_led_wr_str+0
	MOVLW      ?lstr24_main+0
	MOVWF      FARG_led_wr_str+0
	MOVLW      hi_addr(?lstr24_main+0)
	MOVWF      FARG_led_wr_str+1
	MOVLW      8
	MOVWF      FARG_led_wr_str+0
	CALL       _led_wr_str+0
;main.c,278 :: 		if(L==1) led_wr_str (0, 8, "l", 1); else led_wr_str (0, 8, "c", 1);
	MOVF       _L+0, 0
	XORLW      1
	BTFSS      STATUS+0, 2
	GOTO       L_button_proc262
	CLRF       FARG_led_wr_str+0
	MOVLW      8
	MOVWF      FARG_led_wr_str+0
	MOVLW      ?lstr25_main+0
	MOVWF      FARG_led_wr_str+0
	MOVLW      hi_addr(?lstr25_main+0)
	MOVWF      FARG_led_wr_str+1
	MOVLW      1
	MOVWF      FARG_led_wr_str+0
	CALL       _led_wr_str+0
	GOTO       L_button_proc263
L_button_proc262:
	CLRF       FARG_led_wr_str+0
	MOVLW      8
	MOVWF      FARG_led_wr_str+0
	MOVLW      ?lstr26_main+0
	MOVWF      FARG_led_wr_str+0
	MOVLW      hi_addr(?lstr26_main+0)
	MOVWF      FARG_led_wr_str+1
	MOVLW      1
	MOVWF      FARG_led_wr_str+0
	CALL       _led_wr_str+0
L_button_proc263:
;main.c,279 :: 		asm CLRWDT;
	CLRWDT
;main.c,280 :: 		}
L_button_proc260:
L_button_proc259:
;main.c,281 :: 		}
L_button_proc254:
;main.c,282 :: 		}
L_button_proc253:
;main.c,283 :: 		}
L_button_proc233:
;main.c,285 :: 		if(Button(&PORTB, 1, 50, 0) & Bypas==0){   // Auto button
	MOVLW      PORTB+0
	MOVWF      FARG_Button_port+0
	MOVLW      hi_addr(PORTB+0)
	MOVWF      FARG_Button_port+1
	MOVLW      1
	MOVWF      FARG_Button_pin+0
	MOVLW      50
	MOVWF      FARG_Button_time_ms+0
	CLRF       FARG_Button_active_state+0
	CALL       _Button+0
	MOVF       _bypas+0, 0
	XORLW      0
	MOVLW      1
	BTFSS      STATUS+0, 2
	MOVLW      0
	MOVWF      R1
	MOVF       R1, 0
	ANDWF      R0, 1
	BTFSC      STATUS+0, 2
	GOTO       L_button_proc264
;main.c,286 :: 		Delay_ms(450);
	MOVLW      10
	MOVWF      R11
	MOVLW      34
	MOVWF      R12
	MOVLW      161
	MOVWF      R13
L_button_proc265:
	DECFSZ     R13, 1
	GOTO       L_button_proc265
	DECFSZ     R12, 1
	GOTO       L_button_proc265
	DECFSZ     R11, 1
	GOTO       L_button_proc265
;main.c,287 :: 		if(PORTB.B1==1) { // short press button
	BTFSS      PORTB+0, 1
	GOTO       L_button_proc266
;main.c,288 :: 		dysp_on();
	CALL       _dysp_on+0
;main.c,289 :: 		dysp_cnt = Dysp_delay * dysp_cnt_mult;
	MOVF       _Dysp_delay+0, 0
	MOVWF      R0
	CALL       _Byte2Double+0
	MOVF       _dysp_cnt_mult+0, 0
	MOVWF      R4
	MOVF       _dysp_cnt_mult+1, 0
	MOVWF      R5
	MOVF       _dysp_cnt_mult+2, 0
	MOVWF      R6
	MOVF       _dysp_cnt_mult+3, 0
	MOVWF      R7
	CALL       _Mul_32x32_FP+0
	CALL       _Double2Int+0
	MOVF       R0, 0
	MOVWF      _dysp_cnt+0
	MOVF       R1, 0
	MOVWF      _dysp_cnt+1
;main.c,290 :: 		asm CLRWDT;
	CLRWDT
;main.c,291 :: 		if(Auto == 0) Auto = 1;
	MOVF       _Auto+0, 0
	XORLW      0
	BTFSS      STATUS+0, 2
	GOTO       L_button_proc267
	MOVLW      1
	MOVWF      _Auto+0
	GOTO       L_button_proc268
L_button_proc267:
;main.c,292 :: 		else Auto = 0;
	CLRF       _Auto+0
L_button_proc268:
;main.c,293 :: 		EEPROM_Write(2, Auto);
	MOVLW      2
	MOVWF      FARG_EEPROM_Write_Address+0
	MOVF       _Auto+0, 0
	MOVWF      FARG_EEPROM_Write_data_+0
	CALL       _EEPROM_Write+0
;main.c,294 :: 		if(type==4 | type==5) {      // 128*64 OLED
	MOVF       _type+0, 0
	XORLW      4
	MOVLW      1
	BTFSS      STATUS+0, 2
	MOVLW      0
	MOVWF      R1
	MOVF       _type+0, 0
	XORLW      5
	MOVLW      1
	BTFSS      STATUS+0, 2
	MOVLW      0
	MOVWF      R0
	MOVF       R1, 0
	IORWF       R0, 1
	BTFSC      STATUS+0, 2
	GOTO       L_button_proc269
;main.c,295 :: 		if(Auto & !Bypas) led_wr_str (0, 16+8*12, ".", 1);
	MOVF       _bypas+0, 0
	MOVLW      1
	BTFSS      STATUS+0, 2
	MOVLW      0
	MOVWF      R0
	MOVF       _Auto+0, 0
	ANDWF      R0, 1
	BTFSC      STATUS+0, 2
	GOTO       L_button_proc270
	CLRF       FARG_led_wr_str+0
	MOVLW      112
	MOVWF      FARG_led_wr_str+0
	MOVLW      ?lstr27_main+0
	MOVWF      FARG_led_wr_str+0
	MOVLW      hi_addr(?lstr27_main+0)
	MOVWF      FARG_led_wr_str+1
	MOVLW      1
	MOVWF      FARG_led_wr_str+0
	CALL       _led_wr_str+0
	GOTO       L_button_proc271
L_button_proc270:
;main.c,296 :: 		else if(!Auto & Bypas) led_wr_str (0, 16+8*12, "_", 1);
	MOVF       _Auto+0, 0
	MOVLW      1
	BTFSS      STATUS+0, 2
	MOVLW      0
	MOVWF      R0
	MOVF       _bypas+0, 0
	ANDWF      R0, 1
	BTFSC      STATUS+0, 2
	GOTO       L_button_proc272
	CLRF       FARG_led_wr_str+0
	MOVLW      112
	MOVWF      FARG_led_wr_str+0
	MOVLW      ?lstr28_main+0
	MOVWF      FARG_led_wr_str+0
	MOVLW      hi_addr(?lstr28_main+0)
	MOVWF      FARG_led_wr_str+1
	MOVLW      1
	MOVWF      FARG_led_wr_str+0
	CALL       _led_wr_str+0
	GOTO       L_button_proc273
L_button_proc272:
;main.c,297 :: 		else led_wr_str (0, 16+8*12, " ", 1);
	CLRF       FARG_led_wr_str+0
	MOVLW      112
	MOVWF      FARG_led_wr_str+0
	MOVLW      ?lstr29_main+0
	MOVWF      FARG_led_wr_str+0
	MOVLW      hi_addr(?lstr29_main+0)
	MOVWF      FARG_led_wr_str+1
	MOVLW      1
	MOVWF      FARG_led_wr_str+0
	CALL       _led_wr_str+0
L_button_proc273:
L_button_proc271:
;main.c,298 :: 		}
	GOTO       L_button_proc274
L_button_proc269:
;main.c,299 :: 		else if(type!=0) { //  1602 LCD  or 128*32 OLED
	MOVF       _type+0, 0
	XORLW      0
	BTFSC      STATUS+0, 2
	GOTO       L_button_proc275
;main.c,300 :: 		if(Auto & !Bypas) led_wr_str (0, 8, ".", 1);
	MOVF       _bypas+0, 0
	MOVLW      1
	BTFSS      STATUS+0, 2
	MOVLW      0
	MOVWF      R0
	MOVF       _Auto+0, 0
	ANDWF      R0, 1
	BTFSC      STATUS+0, 2
	GOTO       L_button_proc276
	CLRF       FARG_led_wr_str+0
	MOVLW      8
	MOVWF      FARG_led_wr_str+0
	MOVLW      ?lstr30_main+0
	MOVWF      FARG_led_wr_str+0
	MOVLW      hi_addr(?lstr30_main+0)
	MOVWF      FARG_led_wr_str+1
	MOVLW      1
	MOVWF      FARG_led_wr_str+0
	CALL       _led_wr_str+0
	GOTO       L_button_proc277
L_button_proc276:
;main.c,301 :: 		else if(!Auto & Bypas) led_wr_str (0, 8, "_", 1);
	MOVF       _Auto+0, 0
	MOVLW      1
	BTFSS      STATUS+0, 2
	MOVLW      0
	MOVWF      R0
	MOVF       _bypas+0, 0
	ANDWF      R0, 1
	BTFSC      STATUS+0, 2
	GOTO       L_button_proc278
	CLRF       FARG_led_wr_str+0
	MOVLW      8
	MOVWF      FARG_led_wr_str+0
	MOVLW      ?lstr31_main+0
	MOVWF      FARG_led_wr_str+0
	MOVLW      hi_addr(?lstr31_main+0)
	MOVWF      FARG_led_wr_str+1
	MOVLW      1
	MOVWF      FARG_led_wr_str+0
	CALL       _led_wr_str+0
	GOTO       L_button_proc279
L_button_proc278:
;main.c,302 :: 		else led_wr_str (0, 8, " ", 1);
	CLRF       FARG_led_wr_str+0
	MOVLW      8
	MOVWF      FARG_led_wr_str+0
	MOVLW      ?lstr32_main+0
	MOVWF      FARG_led_wr_str+0
	MOVLW      hi_addr(?lstr32_main+0)
	MOVWF      FARG_led_wr_str+1
	MOVLW      1
	MOVWF      FARG_led_wr_str+0
	CALL       _led_wr_str+0
L_button_proc279:
L_button_proc277:
;main.c,303 :: 		}
L_button_proc275:
L_button_proc274:
;main.c,304 :: 		asm CLRWDT;
	CLRWDT
;main.c,305 :: 		while(Button(&PORTB, 1, 50, 0)) {lcd_pwr(); asm CLRWDT; }
L_button_proc280:
	MOVLW      PORTB+0
	MOVWF      FARG_Button_port+0
	MOVLW      hi_addr(PORTB+0)
	MOVWF      FARG_Button_port+1
	MOVLW      1
	MOVWF      FARG_Button_pin+0
	MOVLW      50
	MOVWF      FARG_Button_time_ms+0
	CLRF       FARG_Button_active_state+0
	CALL       _Button+0
	MOVF       R0, 0
	BTFSC      STATUS+0, 2
	GOTO       L_button_proc281
	CALL       _lcd_pwr+0
	CLRWDT
	GOTO       L_button_proc280
L_button_proc281:
;main.c,306 :: 		}
	GOTO       L_button_proc282
L_button_proc266:
;main.c,309 :: 		if(type!=0) user_setup();
	MOVF       _type+0, 0
	XORLW      0
	BTFSC      STATUS+0, 2
	GOTO       L_button_proc283
	CALL       _user_setup+0
L_button_proc283:
;main.c,310 :: 		}
L_button_proc282:
;main.c,312 :: 		}
L_button_proc264:
;main.c,313 :: 		return;
;main.c,314 :: 		}
L_end_button_proc:
	RETURN
; end of _button_proc

_show_reset:

;main.c,316 :: 		void show_reset() {
;main.c,317 :: 		atu_reset();
	CALL       _atu_reset+0
;main.c,318 :: 		SW = 1;
	MOVLW      1
	MOVWF      main_SW+0
;main.c,319 :: 		set_sw(SW);
	MOVLW      1
	MOVWF      FARG_set_sw_SW+0
	CALL       _set_sw+0
;main.c,320 :: 		EEPROM_Write(255, 0);
	MOVLW      255
	MOVWF      FARG_EEPROM_Write_Address+0
	CLRF       FARG_EEPROM_Write_data_+0
	CALL       _EEPROM_Write+0
;main.c,321 :: 		EEPROM_Write(254, 0);
	MOVLW      254
	MOVWF      FARG_EEPROM_Write_Address+0
	CLRF       FARG_EEPROM_Write_data_+0
	CALL       _EEPROM_Write+0
;main.c,322 :: 		EEPROM_Write(253, 1);
	MOVLW      253
	MOVWF      FARG_EEPROM_Write_Address+0
	MOVLW      1
	MOVWF      FARG_EEPROM_Write_data_+0
	CALL       _EEPROM_Write+0
;main.c,323 :: 		EEPROM_Write(252, 0);
	MOVLW      252
	MOVWF      FARG_EEPROM_Write_Address+0
	CLRF       FARG_EEPROM_Write_data_+0
	CALL       _EEPROM_Write+0
;main.c,324 :: 		EEPROM_Write(251, 0);
	MOVLW      251
	MOVWF      FARG_EEPROM_Write_Address+0
	CLRF       FARG_EEPROM_Write_data_+0
	CALL       _EEPROM_Write+0
;main.c,325 :: 		lcd_ind();
	CALL       _lcd_ind+0
;main.c,326 :: 		Loss_mode = 0;
	CLRF       _Loss_mode+0
;main.c,327 :: 		p_Tx = 0;
	BCF        LATA7_bit+0, BitPos(LATA7_bit+0)
;main.c,328 :: 		n_Tx = 1;
	BSF        LATA6_bit+0, BitPos(LATA6_bit+0)
;main.c,329 :: 		SWR = 0;
	CLRF       _SWR+0
	CLRF       _SWR+1
;main.c,330 :: 		PWR = 0;
	CLRF       _PWR+0
	CLRF       _PWR+1
;main.c,331 :: 		SWR_fixed_old = 0;
	CLRF       _SWR_fixed_old+0
	CLRF       _SWR_fixed_old+1
;main.c,332 :: 		if(type==4 | type==5) {    // 128*64 OLED
	MOVF       _type+0, 0
	XORLW      4
	MOVLW      1
	BTFSS      STATUS+0, 2
	MOVLW      0
	MOVWF      R1
	MOVF       _type+0, 0
	XORLW      5
	MOVLW      1
	BTFSS      STATUS+0, 2
	MOVLW      0
	MOVWF      R0
	MOVF       R1, 0
	IORWF       R0, 1
	BTFSC      STATUS+0, 2
	GOTO       L_show_reset284
;main.c,333 :: 		led_wr_str (2, 16, "RESET   ", 8);
	MOVLW      2
	MOVWF      FARG_led_wr_str+0
	MOVLW      16
	MOVWF      FARG_led_wr_str+0
	MOVLW      ?lstr33_main+0
	MOVWF      FARG_led_wr_str+0
	MOVLW      hi_addr(?lstr33_main+0)
	MOVWF      FARG_led_wr_str+1
	MOVLW      8
	MOVWF      FARG_led_wr_str+0
	CALL       _led_wr_str+0
;main.c,334 :: 		asm CLRWDT;
	CLRWDT
;main.c,335 :: 		delay_ms(600);
	MOVLW      13
	MOVWF      R11
	MOVLW      45
	MOVWF      R12
	MOVLW      215
	MOVWF      R13
L_show_reset285:
	DECFSZ     R13, 1
	GOTO       L_show_reset285
	DECFSZ     R12, 1
	GOTO       L_show_reset285
	DECFSZ     R11, 1
	GOTO       L_show_reset285
	NOP
	NOP
;main.c,336 :: 		led_wr_str (2, 16, "SWR=0.00", 8);
	MOVLW      2
	MOVWF      FARG_led_wr_str+0
	MOVLW      16
	MOVWF      FARG_led_wr_str+0
	MOVLW      ?lstr34_main+0
	MOVWF      FARG_led_wr_str+0
	MOVLW      hi_addr(?lstr34_main+0)
	MOVWF      FARG_led_wr_str+1
	MOVLW      8
	MOVWF      FARG_led_wr_str+0
	CALL       _led_wr_str+0
;main.c,337 :: 		asm CLRWDT;
	CLRWDT
;main.c,338 :: 		}
	GOTO       L_show_reset286
L_show_reset284:
;main.c,339 :: 		else if(type!=0) {// 1602 LCD & 128*32 OLED
	MOVF       _type+0, 0
	XORLW      0
	BTFSC      STATUS+0, 2
	GOTO       L_show_reset287
;main.c,340 :: 		led_wr_str (1, 0, "RESET   ", 8);
	MOVLW      1
	MOVWF      FARG_led_wr_str+0
	CLRF       FARG_led_wr_str+0
	MOVLW      ?lstr35_main+0
	MOVWF      FARG_led_wr_str+0
	MOVLW      hi_addr(?lstr35_main+0)
	MOVWF      FARG_led_wr_str+1
	MOVLW      8
	MOVWF      FARG_led_wr_str+0
	CALL       _led_wr_str+0
;main.c,341 :: 		asm CLRWDT;
	CLRWDT
;main.c,342 :: 		delay_ms(600);
	MOVLW      13
	MOVWF      R11
	MOVLW      45
	MOVWF      R12
	MOVLW      215
	MOVWF      R13
L_show_reset288:
	DECFSZ     R13, 1
	GOTO       L_show_reset288
	DECFSZ     R12, 1
	GOTO       L_show_reset288
	DECFSZ     R11, 1
	GOTO       L_show_reset288
	NOP
	NOP
;main.c,343 :: 		led_wr_str (1, 0, "SWR=0.00", 8);
	MOVLW      1
	MOVWF      FARG_led_wr_str+0
	CLRF       FARG_led_wr_str+0
	MOVLW      ?lstr36_main+0
	MOVWF      FARG_led_wr_str+0
	MOVLW      hi_addr(?lstr36_main+0)
	MOVWF      FARG_led_wr_str+1
	MOVLW      8
	MOVWF      FARG_led_wr_str+0
	CALL       _led_wr_str+0
;main.c,344 :: 		asm CLRWDT;
	CLRWDT
;main.c,345 :: 		}
	GOTO       L_show_reset289
L_show_reset287:
;main.c,347 :: 		LATB.B6 = 1;
	BSF        LATB+0, 6
;main.c,348 :: 		LATB.B7 = 1;
	BSF        LATB+0, 7
;main.c,349 :: 		}
L_show_reset289:
L_show_reset286:
;main.c,350 :: 		SWR_old = 10000;
	MOVLW      16
	MOVWF      _SWR_old+0
	MOVLW      39
	MOVWF      _SWR_old+1
;main.c,351 :: 		Power_old = 10000;
	MOVLW      16
	MOVWF      _Power_old+0
	MOVLW      39
	MOVWF      _Power_old+1
;main.c,352 :: 		lcd_pwr();
	CALL       _lcd_pwr+0
;main.c,353 :: 		return;
;main.c,354 :: 		}
L_end_show_reset:
	RETURN
; end of _show_reset

_btn_push:
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
