r3tjl/N7DDC-ATU-100-mini-and-extended-boards/ATU_100_EXT_board/FirmWare_PIC16F1938/R3TJL_1938_EXT_board_sources_V_3.3/main22.asm

_correction:

;main.h,41 :: 		int correction(int input) {
;main.h,42 :: 		input *= 3; // Devider compensation
	MOVF       FARG_correction_input+0, 0
	MOVWF      R0
	MOVF       FARG_correction_input+1, 0
	MOVWF      R1
	MOVLW      3
	MOVWF      R4
	MOVLW      0
	MOVWF      R5
	CALL       _Mul_16x16_U+0
	MOVF       R0, 0
	MOVWF      FARG_correction_input+0
	MOVF       R1, 0
	MOVWF      FARG_correction_input+1
;main.h,44 :: 		if(input <= 80) return 0;
	MOVLW      128
	MOVWF      R2
	MOVLW      128
	XORWF      R1, 0
	SUBWF      R2, 0
	BTFSS      STATUS+0, 2
	GOTO       L__correction528
	MOVF       R0, 0
	SUBLW      80
L__correction528:
	BTFSS      STATUS+0, 0
	GOTO       L_correction0
	CLRF       R0
	CLRF       R1
	GOTO       L_end_correction
L_correction0:
;main.h,45 :: 		if(input <= 171) input += 244;
	MOVLW      128
	MOVWF      R0
	MOVLW      128
	XORWF      FARG_correction_input+1, 0
	SUBWF      R0, 0
	BTFSS      STATUS+0, 2
	GOTO       L__correction529
	MOVF       FARG_correction_input+0, 0
	SUBLW      171
L__correction529:
	BTFSS      STATUS+0, 0
	GOTO       L_correction1
	MOVLW      244
	ADDWF      FARG_correction_input+0, 1
	MOVLW      0
	ADDWFC     FARG_correction_input+1, 1
	GOTO       L_correction2
L_correction1:
;main.h,46 :: 		else if(input <= 328) input += 254;
	MOVLW      128
	XORLW      1
	MOVWF      R0
	MOVLW      128
	XORWF      FARG_correction_input+1, 0
	SUBWF      R0, 0
	BTFSS      STATUS+0, 2
	GOTO       L__correction530
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
L_correction19:
;main.h,55 :: 		else if(input <= 8502) input += 800;
	MOVLW      128
	XORLW      33
	MOVWF      R0
	MOVLW      128
	XORWF      FARG_correction_input+1, 0
	SUBWF      R0, 0
	BTFSS      STATUS+0, 2
	GOTO       L__correction539
	MOVF       FARG_correction_input+0, 0
	SUBLW      54
L__correction539:
	BTFSS      STATUS+0, 0
	GOTO       L_correction21
	MOVLW      32
	ADDWF      FARG_correction_input+0, 1
	MOVLW      3
	ADDWFC     FARG_correction_input+1, 1
	GOTO       L_correction22
L_correction21:
;main.h,56 :: 		else if(input <= 10500) input += 840;
	MOVLW      128
	XORLW      41
	MOVWF      R0
	MOVLW      128
	XORWF      FARG_correction_input+1, 0
	SUBWF      R0, 0
	BTFSS      STATUS+0, 2
	GOTO       L__correction540
	MOVF       FARG_correction_input+0, 0
	SUBLW      4
L__correction540:
	BTFSS      STATUS+0, 0
	GOTO       L_correction23
	MOVLW      72
	ADDWF      FARG_correction_input+0, 1
	MOVLW      3
	ADDWFC     FARG_correction_input+1, 1
	GOTO       L_correction24
L_correction23:
;main.h,57 :: 		else  input += 860;
	MOVLW      92
	ADDWF      FARG_correction_input+0, 1
	MOVLW      3
	ADDWFC     FARG_correction_input+1, 1
L_correction24:
L_correction22:
L_correction20:
L_correction18:
L_correction16:
L_correction14:
L_correction12:
L_correction10:
L_correction8:
L_correction6:
L_correction4:
L_correction2:
;main.h,60 :: 		return input;
	MOVF       FARG_correction_input+0, 0
	MOVWF      R0
	MOVF       FARG_correction_input+1, 0
	MOVWF      R1
;main.h,61 :: 		}
L_end_correction:
	RETURN
; end of _correction

_get_reverse:

;main.h,65 :: 		int get_reverse() {
;main.h,67 :: 		FVRCON = 0b10000001; // ADC 1024 vmV Vref
	MOVLW      129
	MOVWF      FVRCON+0
;main.h,68 :: 		while(FVRCON.B6 == 0);
L_get_reverse25:
	BTFSC      FVRCON+0, 6
	GOTO       L_get_reverse26
	GOTO       L_get_reverse25
L_get_reverse26:
;main.h,69 :: 		Reverse = ADC_Get_Sample(0);
	CLRF       FARG_ADC_Get_Sample_channel+0
	CALL       _ADC_Get_Sample+0
	MOVF       R0, 0
	MOVWF      get_reverse_Reverse_L0+0
	MOVF       R1, 0
	MOVWF      get_reverse_Reverse_L0+1
;main.h,70 :: 		if(Reverse <= 1000) return Reverse;
	MOVLW      128
	XORLW      3
	MOVWF      R2
	MOVLW      128
	XORWF      R1, 0
	SUBWF      R2, 0
	BTFSS      STATUS+0, 2
	GOTO       L__get_reverse542
	MOVF       R0, 0
	SUBLW      232
L__get_reverse542:
	BTFSS      STATUS+0, 0
	GOTO       L_get_reverse27
	MOVF       get_reverse_Reverse_L0+0, 0
	MOVWF      R0
	MOVF       get_reverse_Reverse_L0+1, 0
	MOVWF      R1
	GOTO       L_end_get_reverse
L_get_reverse27:
;main.h,71 :: 		FVRCON = 0b10000010; // ADC 2048 vmV Vref
	MOVLW      130
	MOVWF      FVRCON+0
;main.h,72 :: 		while(FVRCON.B6 == 0);
L_get_reverse28:
	BTFSC      FVRCON+0, 6
	GOTO       L_get_reverse29
	GOTO       L_get_reverse28
L_get_reverse29:
;main.h,73 :: 		Reverse = ADC_Get_Sample(0);
	CLRF       FARG_ADC_Get_Sample_channel+0
	CALL       _ADC_Get_Sample+0
	MOVF       R0, 0
	MOVWF      get_reverse_Reverse_L0+0
	MOVF       R1, 0
	MOVWF      get_reverse_Reverse_L0+1
;main.h,74 :: 		if(Reverse <= 1000) return Reverse * 2;
	MOVLW      128
	XORLW      3
	MOVWF      R2
	MOVLW      128
	XORWF      R1, 0
	SUBWF      R2, 0
	BTFSS      STATUS+0, 2
	GOTO       L__get_reverse543
	MOVF       R0, 0
	SUBLW      232
L__get_reverse543:
	BTFSS      STATUS+0, 0
	GOTO       L_get_reverse30
	MOVF       get_reverse_Reverse_L0+0, 0
	MOVWF      R0
	MOVF       get_reverse_Reverse_L0+1, 0
	MOVWF      R1
	LSLF       R0, 1
	RLF        R1, 1
	GOTO       L_end_get_reverse
L_get_reverse30:
;main.h,75 :: 		FVRCON = 0b10000011; // ADC 4096 vmV Vref
	MOVLW      131
	MOVWF      FVRCON+0
;main.h,76 :: 		while(FVRCON.B6 == 0);
L_get_reverse31:
	BTFSC      FVRCON+0, 6
	GOTO       L_get_reverse32
	GOTO       L_get_reverse31
L_get_reverse32:
;main.h,77 :: 		Reverse = ADC_Get_Sample(0);
	CLRF       FARG_ADC_Get_Sample_channel+0
	CALL       _ADC_Get_Sample+0
	MOVF       R0, 0
	MOVWF      get_reverse_Reverse_L0+0
	MOVF       R1, 0
	MOVWF      get_reverse_Reverse_L0+1
;main.h,78 :: 		return Reverse * 4;
	MOVF       R0, 0
	MOVWF      R2
	MOVF       R1, 0
	MOVWF      R3
	LSLF       R2, 1
	RLF        R3, 1
	LSLF       R2, 1
	RLF        R3, 1
	MOVF       R2, 0
	MOVWF      R0
	MOVF       R3, 0
	MOVWF      R1
;main.h,79 :: 		}
L_end_get_reverse:
	RETURN
; end of _get_reverse

_get_forward:

;main.h,82 :: 		int get_forward() {
;main.h,84 :: 		FVRCON = 0b10000001; // ADC 1024 vmV Vref
	MOVLW      129
	MOVWF      FVRCON+0
;main.h,85 :: 		while(FVRCON.B6 == 0);
L_get_forward33:
	BTFSC      FVRCON+0, 6
	GOTO       L_get_forward34
	GOTO       L_get_forward33
L_get_forward34:
;main.h,86 :: 		Forward = ADC_Get_Sample(1);
	MOVLW      1
	MOVWF      FARG_ADC_Get_Sample_channel+0
	CALL       _ADC_Get_Sample+0
	MOVF       R0, 0
	MOVWF      get_forward_Forward_L0+0
	MOVF       R1, 0
	MOVWF      get_forward_Forward_L0+1
;main.h,87 :: 		if(Forward <= 1000) return Forward;
	MOVLW      128
	XORLW      3
	MOVWF      R2
	MOVLW      128
	XORWF      R1, 0
	SUBWF      R2, 0
	BTFSS      STATUS+0, 2
	GOTO       L__get_forward545
	MOVF       R0, 0
	SUBLW      232
L__get_forward545:
	BTFSS      STATUS+0, 0
	GOTO       L_get_forward35
	MOVF       get_forward_Forward_L0+0, 0
	MOVWF      R0
	MOVF       get_forward_Forward_L0+1, 0
	MOVWF      R1
	GOTO       L_end_get_forward
L_get_forward35:
;main.h,88 :: 		FVRCON = 0b10000010; // ADC 2048 vmV Vref
	MOVLW      130
	MOVWF      FVRCON+0
;main.h,89 :: 		while(FVRCON.B6 == 0);
L_get_forward36:
	BTFSC      FVRCON+0, 6
	GOTO       L_get_forward37
	GOTO       L_get_forward36
L_get_forward37:
;main.h,90 :: 		Forward = ADC_Get_Sample(1);
	MOVLW      1
	MOVWF      FARG_ADC_Get_Sample_channel+0
	CALL       _ADC_Get_Sample+0
	MOVF       R0, 0
	MOVWF      get_forward_Forward_L0+0
	MOVF       R1, 0
	MOVWF      get_forward_Forward_L0+1
;main.h,91 :: 		if(Forward <= 1000) return Forward * 2;
	MOVLW      128
	XORLW      3
	MOVWF      R2
	MOVLW      128
	XORWF      R1, 0
	SUBWF      R2, 0
	BTFSS      STATUS+0, 2
	GOTO       L__get_forward546
	MOVF       R0, 0
	SUBLW      232
L__get_forward546:
	BTFSS      STATUS+0, 0
	GOTO       L_get_forward38
	MOVF       get_forward_Forward_L0+0, 0
	MOVWF      R0
	MOVF       get_forward_Forward_L0+1, 0
	MOVWF      R1
	LSLF       R0, 1
	RLF        R1, 1
	GOTO       L_end_get_forward
L_get_forward38:
;main.h,92 :: 		FVRCON = 0b10000011; // ADC 4096 vmV Vref
	MOVLW      131
	MOVWF      FVRCON+0
;main.h,93 :: 		while(FVRCON.B6 == 0);
L_get_forward39:
	BTFSC      FVRCON+0, 6
	GOTO       L_get_forward40
	GOTO       L_get_forward39
L_get_forward40:
;main.h,94 :: 		Forward = ADC_Get_Sample(1);
	MOVLW      1
	MOVWF      FARG_ADC_Get_Sample_channel+0
	CALL       _ADC_Get_Sample+0
	MOVF       R0, 0
	MOVWF      get_forward_Forward_L0+0
	MOVF       R1, 0
	MOVWF      get_forward_Forward_L0+1
;main.h,95 :: 		if(Forward == 1024) Overload = 1;
	MOVF       R1, 0
	XORLW      4
	BTFSS      STATUS+0, 2
	GOTO       L__get_forward547
	MOVLW      0
	XORWF      R0, 0
L__get_forward547:
	BTFSS      STATUS+0, 2
	GOTO       L_get_forward41
	MOVLW      1
	MOVWF      main22_Overload+0
	GOTO       L_get_forward42
L_get_forward41:
;main.h,96 :: 		else Overload = 0;
	CLRF       main22_Overload+0
L_get_forward42:
;main.h,97 :: 		return Forward * 4;
	MOVF       get_forward_Forward_L0+0, 0
	MOVWF      R0
	MOVF       get_forward_Forward_L0+1, 0
	MOVWF      R1
	LSLF       R0, 1
	RLF        R1, 1
	LSLF       R0, 1
	RLF        R1, 1
;main.h,98 :: 		}
L_end_get_forward:
	RETURN
; end of _get_forward

_get_pwr:

;main.h,100 :: 		void get_pwr() {
;main.h,103 :: 		asm CLRWDT;
	CLRWDT
;main.h,105 :: 		Forward = get_forward();
	CALL       _get_forward+0
	MOVF       R0, 0
	MOVWF      get_pwr_Forward_L0+0
	MOVF       R1, 0
	MOVWF      get_pwr_Forward_L0+1
	MOVLW      0
	BTFSC      get_pwr_Forward_L0+1, 7
	MOVLW      255
	MOVWF      get_pwr_Forward_L0+2
	MOVWF      get_pwr_Forward_L0+3
;main.h,106 :: 		Reverse = get_reverse();
	CALL       _get_reverse+0
	MOVF       R0, 0
	MOVWF      get_pwr_Reverse_L0+0
	MOVF       R1, 0
	MOVWF      get_pwr_Reverse_L0+1
	MOVLW      0
	BTFSC      get_pwr_Reverse_L0+1, 7
	MOVLW      255
	MOVWF      get_pwr_Reverse_L0+2
	MOVWF      get_pwr_Reverse_L0+3
;main.h,107 :: 		if(D_correction==1) p = correction(Forward);
	MOVF       main22_D_correction+0, 0
	XORLW      1
	BTFSS      STATUS+0, 2
	GOTO       L_get_pwr43
	MOVF       get_pwr_Forward_L0+0, 0
	MOVWF      FARG_correction_input+0
	MOVF       get_pwr_Forward_L0+1, 0
	MOVWF      FARG_correction_input+1
	CALL       _correction+0
	CALL       _Int2Double+0
	MOVF       R0, 0
	MOVWF      get_pwr_p_L0+0
	MOVF       R1, 0
	MOVWF      get_pwr_p_L0+1
	MOVF       R2, 0
	MOVWF      get_pwr_p_L0+2
	MOVF       R3, 0
	MOVWF      get_pwr_p_L0+3
	GOTO       L_get_pwr44
L_get_pwr43:
;main.h,108 :: 		else p = Forward;
	MOVF       get_pwr_Forward_L0+0, 0
	MOVWF      R0
	MOVF       get_pwr_Forward_L0+1, 0
	MOVWF      R1
	MOVF       get_pwr_Forward_L0+2, 0
	MOVWF      R2
	MOVF       get_pwr_Forward_L0+3, 0
	MOVWF      R3
	CALL       _Longint2Double+0
	MOVF       R0, 0
	MOVWF      get_pwr_p_L0+0
	MOVF       R1, 0
	MOVWF      get_pwr_p_L0+1
	MOVF       R2, 0
	MOVWF      get_pwr_p_L0+2
	MOVF       R3, 0
	MOVWF      get_pwr_p_L0+3
L_get_pwr44:
;main.h,110 :: 		if(Reverse >= Forward)
	MOVLW      128
	XORWF      get_pwr_Reverse_L0+3, 0
	MOVWF      R0
	MOVLW      128
	XORWF      get_pwr_Forward_L0+3, 0
	SUBWF      R0, 0
	BTFSS      STATUS+0, 2
	GOTO       L__get_pwr549
	MOVF       get_pwr_Forward_L0+2, 0
	SUBWF      get_pwr_Reverse_L0+2, 0
	BTFSS      STATUS+0, 2
	GOTO       L__get_pwr549
	MOVF       get_pwr_Forward_L0+1, 0
	SUBWF      get_pwr_Reverse_L0+1, 0
	BTFSS      STATUS+0, 2
	GOTO       L__get_pwr549
	MOVF       get_pwr_Forward_L0+0, 0
	SUBWF      get_pwr_Reverse_L0+0, 0
L__get_pwr549:
	BTFSS      STATUS+0, 0
	GOTO       L_get_pwr45
;main.h,111 :: 		Forward = 999;
	MOVLW      231
	MOVWF      get_pwr_Forward_L0+0
	MOVLW      3
	MOVWF      get_pwr_Forward_L0+1
	CLRF       get_pwr_Forward_L0+2
	CLRF       get_pwr_Forward_L0+3
	GOTO       L_get_pwr46
L_get_pwr45:
;main.h,113 :: 		Forward = ((Forward + Reverse) * 100) / (Forward - Reverse);
	MOVF       get_pwr_Reverse_L0+0, 0
	ADDWF      get_pwr_Forward_L0+0, 0
	MOVWF      R0
	MOVF       get_pwr_Reverse_L0+1, 0
	ADDWFC     get_pwr_Forward_L0+1, 0
	MOVWF      R1
	MOVF       get_pwr_Reverse_L0+2, 0
	ADDWFC     get_pwr_Forward_L0+2, 0
	MOVWF      R2
	MOVF       get_pwr_Reverse_L0+3, 0
	ADDWFC     get_pwr_Forward_L0+3, 0
	MOVWF      R3
	MOVLW      100
	MOVWF      R4
	CLRF       R5
	CLRF       R6
	CLRF       R7
	CALL       _Mul_32x32_U+0
	MOVF       get_pwr_Forward_L0+0, 0
	MOVWF      R4
	MOVF       get_pwr_Forward_L0+1, 0
	MOVWF      R5
	MOVF       get_pwr_Forward_L0+2, 0
	MOVWF      R6
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
	MOVLW      126
	MOVWF      R7
	CALL       _Add_32x32_FP+0
	MOVF       R0, 0
	MOVWF      get_pwr_p_L0+0
	MOVF       R1, 0
	MOVWF      get_pwr_p_L0+1
	MOVF       R2, 0
	MOVWF      get_pwr_p_L0+2
	MOVF       R3, 0
	MOVWF      get_pwr_p_L0+3
;main.h,123 :: 		PWR = p;   // 0 - 1510 (151.0 Watts)
	CALL       _Double2Int+0
	MOVF       R0, 0
	MOVWF      _PWR+0
	MOVF       R1, 0
	MOVWF      _PWR+1
;main.h,124 :: 		if(PWR<10) SWR = 1;
	MOVLW      128
	XORWF      R1, 0
	MOVWF      R2
	MOVLW      128
	SUBWF      R2, 0
	BTFSS      STATUS+0, 2
	GOTO       L__get_pwr551
	MOVLW      10
	SUBWF      R0, 0
L__get_pwr551:
	BTFSC      STATUS+0, 0
	GOTO       L_get_pwr50
	MOVLW      1
	MOVWF      _SWR+0
	MOVLW      0
	MOVWF      _SWR+1
	GOTO       L_get_pwr51
L_get_pwr50:
;main.h,125 :: 		else if(Forward<100) SWR = 999;
	MOVLW      128
	XORWF      get_pwr_Forward_L0+3, 0
	MOVWF      R0
	MOVLW      128
	SUBWF      R0, 0
	BTFSS      STATUS+0, 2
	GOTO       L__get_pwr552
	MOVLW      0
	SUBWF      get_pwr_Forward_L0+2, 0
	BTFSS      STATUS+0, 2
	GOTO       L__get_pwr552
	MOVLW      0
	SUBWF      get_pwr_Forward_L0+1, 0
	BTFSS      STATUS+0, 2
	GOTO       L__get_pwr552
	MOVLW      100
	SUBWF      get_pwr_Forward_L0+0, 0
L__get_pwr552:
	BTFSC      STATUS+0, 0
	GOTO       L_get_pwr52
	MOVLW      231
	MOVWF      _SWR+0
	MOVLW      3
	MOVWF      _SWR+1
	GOTO       L_get_pwr53
L_get_pwr52:
;main.h,126 :: 		else SWR = Forward;
	MOVF       get_pwr_Forward_L0+0, 0
	MOVWF      _SWR+0
	MOVF       get_pwr_Forward_L0+1, 0
	MOVWF      _SWR+1
L_get_pwr53:
L_get_pwr51:
;main.h,127 :: 		return;
;main.h,128 :: 		}
L_end_get_pwr:
	RETURN
; end of _get_pwr

_get_swr:

;main.h,130 :: 		void get_swr() {
;main.h,131 :: 		get_pwr();
	CALL       _get_pwr+0
;main.h,132 :: 		if(p_cnt!=100) {
	MOVF       _p_cnt+0, 0
	XORLW      100
	BTFSC      STATUS+0, 2
	GOTO       L_get_swr54
;main.h,133 :: 		p_cnt += 1;
	INCF       _p_cnt+0, 1
;main.h,134 :: 		if(PWR>P_max) P_max = PWR;
	MOVLW      128
	XORWF      _P_max+1, 0
	MOVWF      R0
	MOVLW      128
	XORWF      _PWR+1, 0
	SUBWF      R0, 0
	BTFSS      STATUS+0, 2
	GOTO       L__get_swr554
	MOVF       _PWR+0, 0
	SUBWF      _P_max+0, 0
L__get_swr554:
	BTFSC      STATUS+0, 0
	GOTO       L_get_swr55
	MOVF       _PWR+0, 0
	MOVWF      _P_max+0
	MOVF       _PWR+1, 0
	MOVWF      _P_max+1
L_get_swr55:
;main.h,135 :: 		}
	GOTO       L_get_swr56
L_get_swr54:
;main.h,137 :: 		p_cnt = 0;
	CLRF       _p_cnt+0
;main.h,138 :: 		show_pwr(P_max, SWR);
	MOVF       _P_max+0, 0
	MOVWF      FARG_show_pwr+0
	MOVF       _P_max+1, 0
	MOVWF      FARG_show_pwr+1
	MOVF       _SWR+0, 0
	MOVWF      FARG_show_pwr+0
	MOVF       _SWR+1, 0
	MOVWF      FARG_show_pwr+1
	CALL       _show_pwr+0
;main.h,139 :: 		P_max = 0;
	CLRF       _P_max+0
	CLRF       _P_max+1
;main.h,140 :: 		}
L_get_swr56:
;main.h,141 :: 		while(PWR<min_for_start | (PWR> max_for_start & max_for_start>0)) {  // waiting for good power
L_get_swr57:
	MOVLW      128
	XORWF      _PWR+1, 0
	MOVWF      R2
	MOVLW      128
	XORWF      main22_min_for_start+1, 0
	SUBWF      R2, 0
	BTFSS      STATUS+0, 2
	GOTO       L__get_swr555
	MOVF       main22_min_for_start+0, 0
	SUBWF      _PWR+0, 0
L__get_swr555:
	MOVLW      1
	BTFSC      STATUS+0, 0
	MOVLW      0
	MOVWF      R2
	MOVLW      128
	XORWF      main22_max_for_start+1, 0
	MOVWF      R1
	MOVLW      128
	XORWF      _PWR+1, 0
	SUBWF      R1, 0
	BTFSS      STATUS+0, 2
	GOTO       L__get_swr556
	MOVF       _PWR+0, 0
	SUBWF      main22_max_for_start+0, 0
L__get_swr556:
	MOVLW      1
	BTFSC      STATUS+0, 0
	MOVLW      0
	MOVWF      R1
	MOVLW      128
	MOVWF      R0
	MOVLW      128
	XORWF      main22_max_for_start+1, 0
	SUBWF      R0, 0
	BTFSS      STATUS+0, 2
	GOTO       L__get_swr557
	MOVF       main22_max_for_start+0, 0
	SUBLW      0
L__get_swr557:
	MOVLW      1
	BTFSC      STATUS+0, 0
	MOVLW      0
	MOVWF      R0
	MOVF       R1, 0
	ANDWF      R0, 1
	MOVF       R2, 0
	IORWF       R0, 1
	BTFSC      STATUS+0, 2
	GOTO       L_get_swr58
;main.h,142 :: 		asm CLRWDT;
	CLRWDT
;main.h,143 :: 		get_pwr();
	CALL       _get_pwr+0
;main.h,144 :: 		if(p_cnt!=100) {
	MOVF       _p_cnt+0, 0
	XORLW      100
	BTFSC      STATUS+0, 2
	GOTO       L_get_swr59
;main.h,145 :: 		p_cnt += 1;
	INCF       _p_cnt+0, 1
;main.h,146 :: 		if(PWR>P_max) P_max = PWR;
	MOVLW      128
	XORWF      _P_max+1, 0
	MOVWF      R0
	MOVLW      128
	XORWF      _PWR+1, 0
	SUBWF      R0, 0
	BTFSS      STATUS+0, 2
	GOTO       L__get_swr558
	MOVF       _PWR+0, 0
	SUBWF      _P_max+0, 0
L__get_swr558:
	BTFSC      STATUS+0, 0
	GOTO       L_get_swr60
	MOVF       _PWR+0, 0
	MOVWF      _P_max+0
	MOVF       _PWR+1, 0
	MOVWF      _P_max+1
L_get_swr60:
;main.h,147 :: 		}
	GOTO       L_get_swr61
L_get_swr59:
;main.h,149 :: 		p_cnt = 0;
	CLRF       _p_cnt+0
;main.h,150 :: 		show_pwr(P_max, SWR);
	MOVF       _P_max+0, 0
	MOVWF      FARG_show_pwr+0
	MOVF       _P_max+1, 0
	MOVWF      FARG_show_pwr+1
	MOVF       _SWR+0, 0
	MOVWF      FARG_show_pwr+0
	MOVF       _SWR+1, 0
	MOVWF      FARG_show_pwr+1
	CALL       _show_pwr+0
;main.h,151 :: 		P_max = 0;
	CLRF       _P_max+0
	CLRF       _P_max+1
;main.h,152 :: 		}
L_get_swr61:
;main.h,154 :: 		if(Button(&PORTB, 0, 5, 1)) rready = 1;
	MOVLW      PORTB+0
	MOVWF      FARG_Button_port+0
	MOVLW      hi_addr(PORTB+0)
	MOVWF      FARG_Button_port+1
	CLRF       FARG_Button_pin+0
	MOVLW      5
	MOVWF      FARG_Button_time_ms+0
	MOVLW      1
	MOVWF      FARG_Button_active_state+0
	CALL       _Button+0
	MOVF       R0, 0
	BTFSC      STATUS+0, 2
	GOTO       L_get_swr62
	MOVLW      1
	MOVWF      _rready+0
L_get_swr62:
;main.h,155 :: 		if(rready==1 & Button(&PORTB, 0, 5, 0)) { //  press button  Tune
	MOVF       _rready+0, 0
	XORLW      1
	MOVLW      1
	BTFSS      STATUS+0, 2
	MOVLW      0
	MOVWF      FLOC__get_swr+0
	MOVLW      PORTB+0
	MOVWF      FARG_Button_port+0
	MOVLW      hi_addr(PORTB+0)
	MOVWF      FARG_Button_port+1
	CLRF       FARG_Button_pin+0
	MOVLW      5
	MOVWF      FARG_Button_time_ms+0
	CLRF       FARG_Button_active_state+0
	CALL       _Button+0
	MOVF       FLOC__get_swr+0, 0
	ANDWF      R0, 1
	BTFSC      STATUS+0, 2
	GOTO       L_get_swr63
;main.h,156 :: 		show_reset();
	CALL       _show_reset+0
;main.h,157 :: 		SWR = 0;
	CLRF       _SWR+0
	CLRF       _SWR+1
;main.h,158 :: 		return;
	GOTO       L_end_get_swr
;main.h,159 :: 		}
L_get_swr63:
;main.h,160 :: 		} //  good power
	GOTO       L_get_swr57
L_get_swr58:
;main.h,161 :: 		return;
;main.h,162 :: 		}
L_end_get_swr:
	RETURN
; end of _get_swr

_set_ind:

;main.h,164 :: 		void set_ind(char Ind) {  // 0 - 31
;main.h,165 :: 		if(L_invert == 0) {
	MOVF       main22_L_invert+0, 0
	XORLW      0
	BTFSS      STATUS+0, 2
	GOTO       L_set_ind64
;main.h,166 :: 		Ind_005 = Ind.B0;
	BTFSC      FARG_set_ind_Ind+0, 0
	GOTO       L__set_ind560
	BCF        LATB3_bit+0, BitPos(LATB3_bit+0)
	GOTO       L__set_ind561
L__set_ind560:
	BSF        LATB3_bit+0, BitPos(LATB3_bit+0)
L__set_ind561:
;main.h,167 :: 		Ind_011 = Ind.B1;
	BTFSC      FARG_set_ind_Ind+0, 1
	GOTO       L__set_ind562
	BCF        LATA2_bit+0, BitPos(LATA2_bit+0)
	GOTO       L__set_ind563
L__set_ind562:
	BSF        LATA2_bit+0, BitPos(LATA2_bit+0)
L__set_ind563:
;main.h,168 :: 		Ind_022 = Ind.B2;
	BTFSC      FARG_set_ind_Ind+0, 2
	GOTO       L__set_ind564
	BCF        LATB4_bit+0, BitPos(LATB4_bit+0)
	GOTO       L__set_ind565
L__set_ind564:
	BSF        LATB4_bit+0, BitPos(LATB4_bit+0)
L__set_ind565:
;main.h,169 :: 		Ind_045 = Ind.B3;
	BTFSC      FARG_set_ind_Ind+0, 3
	GOTO       L__set_ind566
	BCF        LATA3_bit+0, BitPos(LATA3_bit+0)
	GOTO       L__set_ind567
L__set_ind566:
	BSF        LATA3_bit+0, BitPos(LATA3_bit+0)
L__set_ind567:
;main.h,170 :: 		Ind_1   = Ind.B4;
	BTFSC      FARG_set_ind_Ind+0, 4
	GOTO       L__set_ind568
	BCF        LATB5_bit+0, BitPos(LATB5_bit+0)
	GOTO       L__set_ind569
L__set_ind568:
	BSF        LATB5_bit+0, BitPos(LATB5_bit+0)
L__set_ind569:
;main.h,171 :: 		Ind_22  = Ind.B5;
	BTFSC      FARG_set_ind_Ind+0, 5
	GOTO       L__set_ind570
	BCF        LATA5_bit+0, BitPos(LATA5_bit+0)
	GOTO       L__set_ind571
L__set_ind570:
	BSF        LATA5_bit+0, BitPos(LATA5_bit+0)
L__set_ind571:
;main.h,172 :: 		Ind_45  = Ind.B6;
	BTFSC      FARG_set_ind_Ind+0, 6
	GOTO       L__set_ind572
	BCF        LATA4_bit+0, BitPos(LATA4_bit+0)
	GOTO       L__set_ind573
L__set_ind572:
	BSF        LATA4_bit+0, BitPos(LATA4_bit+0)
L__set_ind573:
;main.h,174 :: 		}
	GOTO       L_set_ind65
L_set_ind64:
;main.h,176 :: 		Ind_005 = ~Ind.B0;
	BTFSC      FARG_set_ind_Ind+0, 0
	GOTO       L__set_ind574
	BSF        LATB3_bit+0, BitPos(LATB3_bit+0)
	GOTO       L__set_ind575
L__set_ind574:
	BCF        LATB3_bit+0, BitPos(LATB3_bit+0)
L__set_ind575:
;main.h,177 :: 		Ind_011 = ~Ind.B1;
	BTFSC      FARG_set_ind_Ind+0, 1
	GOTO       L__set_ind576
	BSF        LATA2_bit+0, BitPos(LATA2_bit+0)
	GOTO       L__set_ind577
L__set_ind576:
	BCF        LATA2_bit+0, BitPos(LATA2_bit+0)
L__set_ind577:
;main.h,178 :: 		Ind_022 = ~Ind.B2;
	BTFSC      FARG_set_ind_Ind+0, 2
	GOTO       L__set_ind578
	BSF        LATB4_bit+0, BitPos(LATB4_bit+0)
	GOTO       L__set_ind579
L__set_ind578:
	BCF        LATB4_bit+0, BitPos(LATB4_bit+0)
L__set_ind579:
;main.h,179 :: 		Ind_045 = ~Ind.B3;
	BTFSC      FARG_set_ind_Ind+0, 3
	GOTO       L__set_ind580
	BSF        LATA3_bit+0, BitPos(LATA3_bit+0)
	GOTO       L__set_ind581
L__set_ind580:
	BCF        LATA3_bit+0, BitPos(LATA3_bit+0)
L__set_ind581:
;main.h,180 :: 		Ind_1   = ~Ind.B4;
	BTFSC      FARG_set_ind_Ind+0, 4
	GOTO       L__set_ind582
	BSF        LATB5_bit+0, BitPos(LATB5_bit+0)
	GOTO       L__set_ind583
L__set_ind582:
	BCF        LATB5_bit+0, BitPos(LATB5_bit+0)
L__set_ind583:
;main.h,181 :: 		Ind_22  = ~Ind.B5;
	BTFSC      FARG_set_ind_Ind+0, 5
	GOTO       L__set_ind584
	BSF        LATA5_bit+0, BitPos(LATA5_bit+0)
	GOTO       L__set_ind585
L__set_ind584:
	BCF        LATA5_bit+0, BitPos(LATA5_bit+0)
L__set_ind585:
;main.h,182 :: 		Ind_45  = ~Ind.B6;
	BTFSC      FARG_set_ind_Ind+0, 6
	GOTO       L__set_ind586
	BSF        LATA4_bit+0, BitPos(LATA4_bit+0)
	GOTO       L__set_ind587
L__set_ind586:
	BCF        LATA4_bit+0, BitPos(LATA4_bit+0)
L__set_ind587:
;main.h,184 :: 		}
L_set_ind65:
;main.h,185 :: 		Vdelay_ms(Rel_Del);
	MOVF       main22_Rel_Del+0, 0
	MOVWF      FARG_VDelay_ms_Time_ms+0
	MOVF       main22_Rel_Del+1, 0
	MOVWF      FARG_VDelay_ms_Time_ms+1
	CALL       _VDelay_ms+0
;main.h,186 :: 		}
L_end_set_ind:
	RETURN
; end of _set_ind

_set_cap:

;main.h,188 :: 		void set_cap(char Cap) { // 0 - 31
;main.h,189 :: 		Cap_10  =  Cap.B0;
	BTFSC      FARG_set_cap_Cap+0, 0
	GOTO       L__set_cap589
	BCF        LATC7_bit+0, BitPos(LATC7_bit+0)
	GOTO       L__set_cap590
L__set_cap589:
	BSF        LATC7_bit+0, BitPos(LATC7_bit+0)
L__set_cap590:
;main.h,190 :: 		Cap_22  =  Cap.B1;
	BTFSC      FARG_set_cap_Cap+0, 1
	GOTO       L__set_cap591
	BCF        LATC3_bit+0, BitPos(LATC3_bit+0)
	GOTO       L__set_cap592
L__set_cap591:
	BSF        LATC3_bit+0, BitPos(LATC3_bit+0)
L__set_cap592:
;main.h,191 :: 		Cap_47  =  Cap.B2;
	BTFSC      FARG_set_cap_Cap+0, 2
	GOTO       L__set_cap593
	BCF        LATC6_bit+0, BitPos(LATC6_bit+0)
	GOTO       L__set_cap594
L__set_cap593:
	BSF        LATC6_bit+0, BitPos(LATC6_bit+0)
L__set_cap594:
;main.h,192 :: 		Cap_100 =  Cap.B3;
	BTFSC      FARG_set_cap_Cap+0, 3
	GOTO       L__set_cap595
	BCF        LATC2_bit+0, BitPos(LATC2_bit+0)
	GOTO       L__set_cap596
L__set_cap595:
	BSF        LATC2_bit+0, BitPos(LATC2_bit+0)
L__set_cap596:
;main.h,193 :: 		Cap_220 =  Cap.B4;
	BTFSC      FARG_set_cap_Cap+0, 4
	GOTO       L__set_cap597
	BCF        LATC5_bit+0, BitPos(LATC5_bit+0)
	GOTO       L__set_cap598
L__set_cap597:
	BSF        LATC5_bit+0, BitPos(LATC5_bit+0)
L__set_cap598:
;main.h,194 :: 		Cap_470 =  Cap.B5;
	BTFSC      FARG_set_cap_Cap+0, 5
	GOTO       L__set_cap599
	BCF        LATC1_bit+0, BitPos(LATC1_bit+0)
	GOTO       L__set_cap600
L__set_cap599:
	BSF        LATC1_bit+0, BitPos(LATC1_bit+0)
L__set_cap600:
;main.h,195 :: 		Cap_1000 =  Cap.B6;
	BTFSC      FARG_set_cap_Cap+0, 6
	GOTO       L__set_cap601
	BCF        LATC4_bit+0, BitPos(LATC4_bit+0)
	GOTO       L__set_cap602
L__set_cap601:
	BSF        LATC4_bit+0, BitPos(LATC4_bit+0)
L__set_cap602:
;main.h,197 :: 		Vdelay_ms(Rel_Del);
	MOVF       main22_Rel_Del+0, 0
	MOVWF      FARG_VDelay_ms_Time_ms+0
	MOVF       main22_Rel_Del+1, 0
	MOVWF      FARG_VDelay_ms_Time_ms+1
	CALL       _VDelay_ms+0
;main.h,198 :: 		}
L_end_set_cap:
	RETURN
; end of _set_cap

_set_sw:

;main.h,200 :: 		void set_sw(char SW) {  // 0 - IN,  1 - OUT
;main.h,201 :: 		Cap_sw = SW;
	BTFSC      FARG_set_sw_SW+0, 0
	GOTO       L__set_sw604
	BCF        LATC0_bit+0, BitPos(LATC0_bit+0)
	GOTO       L__set_sw605
L__set_sw604:
	BSF        LATC0_bit+0, BitPos(LATC0_bit+0)
L__set_sw605:
;main.h,202 :: 		Vdelay_ms(Rel_Del);
	MOVF       main22_Rel_Del+0, 0
	MOVWF      FARG_VDelay_ms_Time_ms+0
	MOVF       main22_Rel_Del+1, 0
	MOVWF      FARG_VDelay_ms_Time_ms+1
	CALL       _VDelay_ms+0
;main.h,203 :: 		}
L_end_set_sw:
	RETURN
; end of _set_sw

_atu_reset:

;main.h,205 :: 		void atu_reset() {
;main.h,206 :: 		ind = 0;
	CLRF       main22_ind+0
;main.h,207 :: 		cap = 0;
	CLRF       main22_cap+0
;main.h,208 :: 		set_ind(ind);
	CLRF       FARG_set_ind_Ind+0
	CALL       _set_ind+0
;main.h,209 :: 		set_cap(cap);
	MOVF       main22_cap+0, 0
	MOVWF      FARG_set_cap_Cap+0
	CALL       _set_cap+0
;main.h,210 :: 		Vdelay_ms(Rel_Del);
	MOVF       main22_Rel_Del+0, 0
	MOVWF      FARG_VDelay_ms_Time_ms+0
	MOVF       main22_Rel_Del+1, 0
	MOVWF      FARG_VDelay_ms_Time_ms+1
	CALL       _VDelay_ms+0
;main.h,211 :: 		}
L_end_atu_reset:
	RETURN
; end of _atu_reset

_coarse_cap:

;main.h,214 :: 		void coarse_cap() {
;main.h,215 :: 		char step = 3;
	MOVLW      3
	MOVWF      coarse_cap_step_L0+0
;main.h,219 :: 		cap = 0;
	CLRF       main22_cap+0
;main.h,220 :: 		set_cap(cap);
	CLRF       FARG_set_cap_Cap+0
	CALL       _set_cap+0
;main.h,221 :: 		step_cap = step;
	MOVF       coarse_cap_step_L0+0, 0
	MOVWF      main22_step_cap+0
;main.h,222 :: 		get_swr(); if(SWR==0) return;
	CALL       _get_swr+0
	MOVLW      0
	XORWF      _SWR+1, 0
	BTFSS      STATUS+0, 2
	GOTO       L__coarse_cap608
	MOVLW      0
	XORWF      _SWR+0, 0
L__coarse_cap608:
	BTFSS      STATUS+0, 2
	GOTO       L_coarse_cap66
	GOTO       L_end_coarse_cap
L_coarse_cap66:
;main.h,223 :: 		min_swr = SWR + SWR/20;
	MOVLW      20
	MOVWF      R4
	MOVLW      0
	MOVWF      R5
	MOVF       _SWR+0, 0
	MOVWF      R0
	MOVF       _SWR+1, 0
	MOVWF      R1
	CALL       _Div_16x16_S+0
	MOVF       R0, 0
	ADDWF      _SWR+0, 0
	MOVWF      coarse_cap_min_swr_L0+0
	MOVF       R1, 0
	ADDWFC     _SWR+1, 0
	MOVWF      coarse_cap_min_swr_L0+1
;main.h,224 :: 		for(count=step; count<=31;) {
	MOVF       coarse_cap_step_L0+0, 0
	MOVWF      coarse_cap_count_L0+0
L_coarse_cap67:
	MOVF       coarse_cap_count_L0+0, 0
	SUBLW      31
	BTFSS      STATUS+0, 0
	GOTO       L_coarse_cap68
;main.h,225 :: 		set_cap(count*C_mult);
	MOVF       coarse_cap_count_L0+0, 0
	MOVWF      R0
	MOVF       main22_C_mult+0, 0
	MOVWF      R4
	CALL       _Mul_8x8_U+0
	MOVF       R0, 0
	MOVWF      FARG_set_cap_Cap+0
	CALL       _set_cap+0
;main.h,226 :: 		get_swr(); if(SWR==0) return;
	CALL       _get_swr+0
	MOVLW      0
	XORWF      _SWR+1, 0
	BTFSS      STATUS+0, 2
	GOTO       L__coarse_cap609
	MOVLW      0
	XORWF      _SWR+0, 0
L__coarse_cap609:
	BTFSS      STATUS+0, 2
	GOTO       L_coarse_cap70
	GOTO       L_end_coarse_cap
L_coarse_cap70:
;main.h,227 :: 		if(SWR < min_swr) {
	MOVLW      128
	XORWF      _SWR+1, 0
	MOVWF      R0
	MOVLW      128
	XORWF      coarse_cap_min_swr_L0+1, 0
	SUBWF      R0, 0
	BTFSS      STATUS+0, 2
	GOTO       L__coarse_cap610
	MOVF       coarse_cap_min_swr_L0+0, 0
	SUBWF      _SWR+0, 0
L__coarse_cap610:
	BTFSC      STATUS+0, 0
	GOTO       L_coarse_cap71
;main.h,228 :: 		min_swr = SWR + SWR/20;
	MOVLW      20
	MOVWF      R4
	MOVLW      0
	MOVWF      R5
	MOVF       _SWR+0, 0
	MOVWF      R0
	MOVF       _SWR+1, 0
	MOVWF      R1
	CALL       _Div_16x16_S+0
	MOVF       R0, 0
	ADDWF      _SWR+0, 0
	MOVWF      coarse_cap_min_swr_L0+0
	MOVF       R1, 0
	ADDWFC     _SWR+1, 0
	MOVWF      coarse_cap_min_swr_L0+1
;main.h,229 :: 		cap = count*C_mult;
	MOVF       coarse_cap_count_L0+0, 0
	MOVWF      R0
	MOVF       main22_C_mult+0, 0
	MOVWF      R4
	CALL       _Mul_8x8_U+0
	MOVF       R0, 0
	MOVWF      main22_cap+0
;main.h,230 :: 		step_cap = step;
	MOVF       coarse_cap_step_L0+0, 0
	MOVWF      main22_step_cap+0
;main.h,231 :: 		if(SWR<120) break;
	MOVLW      128
	XORWF      _SWR+1, 0
	MOVWF      R0
	MOVLW      128
	SUBWF      R0, 0
	BTFSS      STATUS+0, 2
	GOTO       L__coarse_cap611
	MOVLW      120
	SUBWF      _SWR+0, 0
L__coarse_cap611:
	BTFSC      STATUS+0, 0
	GOTO       L_coarse_cap72
	GOTO       L_coarse_cap68
L_coarse_cap72:
;main.h,232 :: 		count +=step;
	MOVF       coarse_cap_step_L0+0, 0
	ADDWF      coarse_cap_count_L0+0, 0
	MOVWF      R2
	MOVF       R2, 0
	MOVWF      coarse_cap_count_L0+0
;main.h,233 :: 		if(C_linear==0 & count==9) count = 8;
	MOVF       main22_C_linear+0, 0
	XORLW      0
	MOVLW      1
	BTFSS      STATUS+0, 2
	MOVLW      0
	MOVWF      R1
	MOVF       R2, 0
	XORLW      9
	MOVLW      1
	BTFSS      STATUS+0, 2
	MOVLW      0
	MOVWF      R0
	MOVF       R1, 0
	ANDWF      R0, 1
	BTFSC      STATUS+0, 2
	GOTO       L_coarse_cap73
	MOVLW      8
	MOVWF      coarse_cap_count_L0+0
	GOTO       L_coarse_cap74
L_coarse_cap73:
;main.h,234 :: 		else if(C_linear==0 & count==17) {count = 16; step = 4;}
	MOVF       main22_C_linear+0, 0
	XORLW      0
	MOVLW      1
	BTFSS      STATUS+0, 2
	MOVLW      0
	MOVWF      R1
	MOVF       coarse_cap_count_L0+0, 0
	XORLW      17
	MOVLW      1
	BTFSS      STATUS+0, 2
	MOVLW      0
	MOVWF      R0
	MOVF       R1, 0
	ANDWF      R0, 1
	BTFSC      STATUS+0, 2
	GOTO       L_coarse_cap75
	MOVLW      16
	MOVWF      coarse_cap_count_L0+0
	MOVLW      4
	MOVWF      coarse_cap_step_L0+0
L_coarse_cap75:
L_coarse_cap74:
;main.h,235 :: 		}
	GOTO       L_coarse_cap76
L_coarse_cap71:
;main.h,236 :: 		else break;
	GOTO       L_coarse_cap68
L_coarse_cap76:
;main.h,237 :: 		}
	GOTO       L_coarse_cap67
L_coarse_cap68:
;main.h,238 :: 		set_cap(cap);
	MOVF       main22_cap+0, 0
	MOVWF      FARG_set_cap_Cap+0
	CALL       _set_cap+0
;main.h,239 :: 		return;
;main.h,240 :: 		}
L_end_coarse_cap:
	RETURN
; end of _coarse_cap

_coarse_tune:

;main.h,242 :: 		void coarse_tune() {
;main.h,243 :: 		char step = 3;
	MOVLW      3
	MOVWF      coarse_tune_step_L0+0
;main.h,248 :: 		mem_cap = 0;
	CLRF       coarse_tune_mem_cap_L0+0
;main.h,249 :: 		step_ind = step;
	MOVF       coarse_tune_step_L0+0, 0
	MOVWF      main22_step_ind+0
;main.h,250 :: 		mem_step_cap = 3;
	MOVLW      3
	MOVWF      coarse_tune_mem_step_cap_L0+0
;main.h,251 :: 		min_swr = SWR + SWR/20;
	MOVLW      20
	MOVWF      R4
	MOVLW      0
	MOVWF      R5
	MOVF       _SWR+0, 0
	MOVWF      R0
	MOVF       _SWR+1, 0
	MOVWF      R1
	CALL       _Div_16x16_S+0
	MOVF       R0, 0
	ADDWF      _SWR+0, 0
	MOVWF      coarse_tune_min_swr_L0+0
	MOVF       R1, 0
	ADDWFC     _SWR+1, 0
	MOVWF      coarse_tune_min_swr_L0+1
;main.h,252 :: 		for(count=0; count<=31;) {
	CLRF       coarse_tune_count_L0+0
L_coarse_tune77:
	MOVF       coarse_tune_count_L0+0, 0
	SUBLW      31
	BTFSS      STATUS+0, 0
	GOTO       L_coarse_tune78
;main.h,253 :: 		set_ind(count*L_mult);
	MOVF       coarse_tune_count_L0+0, 0
	MOVWF      R0
	MOVF       main22_L_mult+0, 0
	MOVWF      R4
	CALL       _Mul_8x8_U+0
	MOVF       R0, 0
	MOVWF      FARG_set_ind_Ind+0
	CALL       _set_ind+0
;main.h,254 :: 		coarse_cap();
	CALL       _coarse_cap+0
;main.h,255 :: 		get_swr();  if(SWR==0) return;
	CALL       _get_swr+0
	MOVLW      0
	XORWF      _SWR+1, 0
	BTFSS      STATUS+0, 2
	GOTO       L__coarse_tune613
	MOVLW      0
	XORWF      _SWR+0, 0
L__coarse_tune613:
	BTFSS      STATUS+0, 2
	GOTO       L_coarse_tune80
	GOTO       L_end_coarse_tune
L_coarse_tune80:
;main.h,256 :: 		if(SWR < min_swr) {
	MOVLW      128
	XORWF      _SWR+1, 0
	MOVWF      R0
	MOVLW      128
	XORWF      coarse_tune_min_swr_L0+1, 0
	SUBWF      R0, 0
	BTFSS      STATUS+0, 2
	GOTO       L__coarse_tune614
	MOVF       coarse_tune_min_swr_L0+0, 0
	SUBWF      _SWR+0, 0
L__coarse_tune614:
	BTFSC      STATUS+0, 0
	GOTO       L_coarse_tune81
;main.h,257 :: 		min_swr = SWR + SWR/20;
	MOVLW      20
	MOVWF      R4
	MOVLW      0
	MOVWF      R5
	MOVF       _SWR+0, 0
	MOVWF      R0
	MOVF       _SWR+1, 0
	MOVWF      R1
	CALL       _Div_16x16_S+0
	MOVF       R0, 0
	ADDWF      _SWR+0, 0
	MOVWF      coarse_tune_min_swr_L0+0
	MOVF       R1, 0
	ADDWFC     _SWR+1, 0
	MOVWF      coarse_tune_min_swr_L0+1
;main.h,258 :: 		ind = count*L_mult;
	MOVF       coarse_tune_count_L0+0, 0
	MOVWF      R0
	MOVF       main22_L_mult+0, 0
	MOVWF      R4
	CALL       _Mul_8x8_U+0
	MOVF       R0, 0
	MOVWF      main22_ind+0
;main.h,259 :: 		mem_cap = cap;
	MOVF       main22_cap+0, 0
	MOVWF      coarse_tune_mem_cap_L0+0
;main.h,260 :: 		step_ind = step;
	MOVF       coarse_tune_step_L0+0, 0
	MOVWF      main22_step_ind+0
;main.h,261 :: 		mem_step_cap = step_cap;
	MOVF       main22_step_cap+0, 0
	MOVWF      coarse_tune_mem_step_cap_L0+0
;main.h,262 :: 		if(SWR<120) break;
	MOVLW      128
	XORWF      _SWR+1, 0
	MOVWF      R0
	MOVLW      128
	SUBWF      R0, 0
	BTFSS      STATUS+0, 2
	GOTO       L__coarse_tune615
	MOVLW      120
	SUBWF      _SWR+0, 0
L__coarse_tune615:
	BTFSC      STATUS+0, 0
	GOTO       L_coarse_tune82
	GOTO       L_coarse_tune78
L_coarse_tune82:
;main.h,263 :: 		count +=step;
	MOVF       coarse_tune_step_L0+0, 0
	ADDWF      coarse_tune_count_L0+0, 0
	MOVWF      R2
	MOVF       R2, 0
	MOVWF      coarse_tune_count_L0+0
;main.h,264 :: 		if(L_linear==0 & count==9) count = 8;
	MOVF       main22_L_linear+0, 0
	XORLW      0
	MOVLW      1
	BTFSS      STATUS+0, 2
	MOVLW      0
	MOVWF      R1
	MOVF       R2, 0
	XORLW      9
	MOVLW      1
	BTFSS      STATUS+0, 2
	MOVLW      0
	MOVWF      R0
	MOVF       R1, 0
	ANDWF      R0, 1
	BTFSC      STATUS+0, 2
	GOTO       L_coarse_tune83
	MOVLW      8
	MOVWF      coarse_tune_count_L0+0
	GOTO       L_coarse_tune84
L_coarse_tune83:
;main.h,265 :: 		else if(L_linear==0 & count==17) {count = 16; step = 4;}
	MOVF       main22_L_linear+0, 0
	XORLW      0
	MOVLW      1
	BTFSS      STATUS+0, 2
	MOVLW      0
	MOVWF      R1
	MOVF       coarse_tune_count_L0+0, 0
	XORLW      17
	MOVLW      1
	BTFSS      STATUS+0, 2
	MOVLW      0
	MOVWF      R0
	MOVF       R1, 0
	ANDWF      R0, 1
	BTFSC      STATUS+0, 2
	GOTO       L_coarse_tune85
	MOVLW      16
	MOVWF      coarse_tune_count_L0+0
	MOVLW      4
	MOVWF      coarse_tune_step_L0+0
L_coarse_tune85:
L_coarse_tune84:
;main.h,266 :: 		}
	GOTO       L_coarse_tune86
L_coarse_tune81:
;main.h,267 :: 		else break;
	GOTO       L_coarse_tune78
L_coarse_tune86:
;main.h,268 :: 		}
	GOTO       L_coarse_tune77
L_coarse_tune78:
;main.h,269 :: 		cap = mem_cap;
	MOVF       coarse_tune_mem_cap_L0+0, 0
	MOVWF      main22_cap+0
;main.h,270 :: 		set_ind(ind);
	MOVF       main22_ind+0, 0
	MOVWF      FARG_set_ind_Ind+0
	CALL       _set_ind+0
;main.h,271 :: 		set_cap(cap);
	MOVF       main22_cap+0, 0
	MOVWF      FARG_set_cap_Cap+0
	CALL       _set_cap+0
;main.h,272 :: 		step_cap = mem_step_cap;
	MOVF       coarse_tune_mem_step_cap_L0+0, 0
	MOVWF      main22_step_cap+0
;main.h,273 :: 		Delay_ms(10);
	MOVLW      52
	MOVWF      R12
	MOVLW      241
	MOVWF      R13
L_coarse_tune87:
	DECFSZ     R13, 1
	GOTO       L_coarse_tune87
	DECFSZ     R12, 1
	GOTO       L_coarse_tune87
	NOP
	NOP
;main.h,274 :: 		return;
;main.h,275 :: 		}
L_end_coarse_tune:
	RETURN
; end of _coarse_tune

_sharp_cap:

;main.h,277 :: 		void sharp_cap() {
;main.h,280 :: 		range = step_cap*C_mult;
	MOVF       main22_step_cap+0, 0
	MOVWF      R0
	MOVF       main22_C_mult+0, 0
	MOVWF      R4
	CALL       _Mul_8x8_U+0
	MOVF       R0, 0
	MOVWF      sharp_cap_range_L0+0
;main.h,282 :: 		max_range = cap + range;
	MOVF       R0, 0
	ADDWF      main22_cap+0, 0
	MOVWF      R4
	MOVF       R4, 0
	MOVWF      sharp_cap_max_range_L0+0
;main.h,283 :: 		if(max_range>32*C_mult-1) max_range = 32*C_mult-1;
	MOVLW      5
	MOVWF      R2
	MOVF       main22_C_mult+0, 0
	MOVWF      R0
	CLRF       R1
	MOVF       R2, 0
L__sharp_cap617:
	BTFSC      STATUS+0, 2
	GOTO       L__sharp_cap618
	LSLF       R0, 1
	RLF        R1, 1
	ADDLW      255
	GOTO       L__sharp_cap617
L__sharp_cap618:
	MOVLW      1
	SUBWF      R0, 0
	MOVWF      R2
	MOVLW      0
	SUBWFB     R1, 0
	MOVWF      R3
	MOVLW      128
	XORWF      R3, 0
	MOVWF      R0
	MOVLW      128
	SUBWF      R0, 0
	BTFSS      STATUS+0, 2
	GOTO       L__sharp_cap619
	MOVF       R4, 0
	SUBWF      R2, 0
L__sharp_cap619:
	BTFSC      STATUS+0, 0
	GOTO       L_sharp_cap88
	MOVLW      5
	MOVWF      R0
	MOVF       main22_C_mult+0, 0
	MOVWF      sharp_cap_max_range_L0+0
	MOVF       R0, 0
L__sharp_cap620:
	BTFSC      STATUS+0, 2
	GOTO       L__sharp_cap621
	LSLF       sharp_cap_max_range_L0+0, 1
	ADDLW      255
	GOTO       L__sharp_cap620
L__sharp_cap621:
	DECF       sharp_cap_max_range_L0+0, 1
L_sharp_cap88:
;main.h,284 :: 		if(cap>range) min_range = cap - range; else min_range = 0;
	MOVF       main22_cap+0, 0
	SUBWF      sharp_cap_range_L0+0, 0
	BTFSC      STATUS+0, 0
	GOTO       L_sharp_cap89
	MOVF       sharp_cap_range_L0+0, 0
	SUBWF      main22_cap+0, 0
	MOVWF      sharp_cap_min_range_L0+0
	GOTO       L_sharp_cap90
L_sharp_cap89:
	CLRF       sharp_cap_min_range_L0+0
L_sharp_cap90:
;main.h,285 :: 		cap = min_range;
	MOVF       sharp_cap_min_range_L0+0, 0
	MOVWF      main22_cap+0
;main.h,286 :: 		set_cap(cap);
	MOVF       sharp_cap_min_range_L0+0, 0
	MOVWF      FARG_set_cap_Cap+0
	CALL       _set_cap+0
;main.h,287 :: 		get_swr(); if(SWR==0) return;
	CALL       _get_swr+0
	MOVLW      0
	XORWF      _SWR+1, 0
	BTFSS      STATUS+0, 2
	GOTO       L__sharp_cap622
	MOVLW      0
	XORWF      _SWR+0, 0
L__sharp_cap622:
	BTFSS      STATUS+0, 2
	GOTO       L_sharp_cap91
	GOTO       L_end_sharp_cap
L_sharp_cap91:
;main.h,288 :: 		min_SWR = SWR;
	MOVF       _SWR+0, 0
	MOVWF      sharp_cap_min_swr_L0+0
	MOVF       _SWR+1, 0
	MOVWF      sharp_cap_min_swr_L0+1
;main.h,289 :: 		for(count=min_range+C_mult; count<=max_range; count+=C_mult)  {
	MOVF       main22_C_mult+0, 0
	ADDWF      sharp_cap_min_range_L0+0, 0
	MOVWF      sharp_cap_count_L0+0
L_sharp_cap92:
	MOVF       sharp_cap_count_L0+0, 0
	SUBWF      sharp_cap_max_range_L0+0, 0
	BTFSS      STATUS+0, 0
	GOTO       L_sharp_cap93
;main.h,290 :: 		set_cap(count);
	MOVF       sharp_cap_count_L0+0, 0
	MOVWF      FARG_set_cap_Cap+0
	CALL       _set_cap+0
;main.h,291 :: 		get_swr(); if(SWR==0) return;
	CALL       _get_swr+0
	MOVLW      0
	XORWF      _SWR+1, 0
	BTFSS      STATUS+0, 2
	GOTO       L__sharp_cap623
	MOVLW      0
	XORWF      _SWR+0, 0
L__sharp_cap623:
	BTFSS      STATUS+0, 2
	GOTO       L_sharp_cap95
	GOTO       L_end_sharp_cap
L_sharp_cap95:
;main.h,292 :: 		if(SWR>=min_SWR) { Delay_ms(10); get_swr(); }
	MOVLW      128
	XORWF      _SWR+1, 0
	MOVWF      R0
	MOVLW      128
	XORWF      sharp_cap_min_swr_L0+1, 0
	SUBWF      R0, 0
	BTFSS      STATUS+0, 2
	GOTO       L__sharp_cap624
	MOVF       sharp_cap_min_swr_L0+0, 0
	SUBWF      _SWR+0, 0
L__sharp_cap624:
	BTFSS      STATUS+0, 0
	GOTO       L_sharp_cap96
	MOVLW      52
	MOVWF      R12
	MOVLW      241
	MOVWF      R13
L_sharp_cap97:
	DECFSZ     R13, 1
	GOTO       L_sharp_cap97
	DECFSZ     R12, 1
	GOTO       L_sharp_cap97
	NOP
	NOP
	CALL       _get_swr+0
L_sharp_cap96:
;main.h,293 :: 		if(SWR>=min_SWR) { Delay_ms(10); get_swr(); }
	MOVLW      128
	XORWF      _SWR+1, 0
	MOVWF      R0
	MOVLW      128
	XORWF      sharp_cap_min_swr_L0+1, 0
	SUBWF      R0, 0
	BTFSS      STATUS+0, 2
	GOTO       L__sharp_cap625
	MOVF       sharp_cap_min_swr_L0+0, 0
	SUBWF      _SWR+0, 0
L__sharp_cap625:
	BTFSS      STATUS+0, 0
	GOTO       L_sharp_cap98
	MOVLW      52
	MOVWF      R12
	MOVLW      241
	MOVWF      R13
L_sharp_cap99:
	DECFSZ     R13, 1
	GOTO       L_sharp_cap99
	DECFSZ     R12, 1
	GOTO       L_sharp_cap99
	NOP
	NOP
	CALL       _get_swr+0
L_sharp_cap98:
;main.h,294 :: 		if(SWR < min_SWR) {
	MOVLW      128
	XORWF      _SWR+1, 0
	MOVWF      R0
	MOVLW      128
	XORWF      sharp_cap_min_swr_L0+1, 0
	SUBWF      R0, 0
	BTFSS      STATUS+0, 2
	GOTO       L__sharp_cap626
	MOVF       sharp_cap_min_swr_L0+0, 0
	SUBWF      _SWR+0, 0
L__sharp_cap626:
	BTFSC      STATUS+0, 0
	GOTO       L_sharp_cap100
;main.h,295 :: 		min_SWR = SWR;
	MOVF       _SWR+0, 0
	MOVWF      sharp_cap_min_swr_L0+0
	MOVF       _SWR+1, 0
	MOVWF      sharp_cap_min_swr_L0+1
;main.h,296 :: 		cap = count;
	MOVF       sharp_cap_count_L0+0, 0
	MOVWF      main22_cap+0
;main.h,297 :: 		if(SWR<120) break;
	MOVLW      128
	XORWF      _SWR+1, 0
	MOVWF      R0
	MOVLW      128
	SUBWF      R0, 0
	BTFSS      STATUS+0, 2
	GOTO       L__sharp_cap627
	MOVLW      120
	SUBWF      _SWR+0, 0
L__sharp_cap627:
	BTFSC      STATUS+0, 0
	GOTO       L_sharp_cap101
	GOTO       L_sharp_cap93
L_sharp_cap101:
;main.h,298 :: 		}
	GOTO       L_sharp_cap102
L_sharp_cap100:
;main.h,299 :: 		else break;
	GOTO       L_sharp_cap93
L_sharp_cap102:
;main.h,289 :: 		for(count=min_range+C_mult; count<=max_range; count+=C_mult)  {
	MOVF       main22_C_mult+0, 0
	ADDWF      sharp_cap_count_L0+0, 1
;main.h,300 :: 		}
	GOTO       L_sharp_cap92
L_sharp_cap93:
;main.h,301 :: 		set_cap(cap);
	MOVF       main22_cap+0, 0
	MOVWF      FARG_set_cap_Cap+0
	CALL       _set_cap+0
;main.h,302 :: 		return;
;main.h,303 :: 		}
L_end_sharp_cap:
	RETURN
; end of _sharp_cap

_sharp_ind:

;main.h,305 :: 		void sharp_ind() {
;main.h,308 :: 		range = step_ind * L_mult;
	MOVF       main22_step_ind+0, 0
	MOVWF      R0
	MOVF       main22_L_mult+0, 0
	MOVWF      R4
	CALL       _Mul_8x8_U+0
	MOVF       R0, 0
	MOVWF      sharp_ind_range_L0+0
;main.h,310 :: 		max_range = ind + range;
	MOVF       R0, 0
	ADDWF      main22_ind+0, 0
	MOVWF      R4
	MOVF       R4, 0
	MOVWF      sharp_ind_max_range_L0+0
;main.h,311 :: 		if(max_range>32*L_mult-1) max_range = 32*L_mult-1;
	MOVLW      5
	MOVWF      R2
	MOVF       main22_L_mult+0, 0
	MOVWF      R0
	CLRF       R1
	MOVF       R2, 0
L__sharp_ind629:
	BTFSC      STATUS+0, 2
	GOTO       L__sharp_ind630
	LSLF       R0, 1
	RLF        R1, 1
	ADDLW      255
	GOTO       L__sharp_ind629
L__sharp_ind630:
	MOVLW      1
	SUBWF      R0, 0
	MOVWF      R2
	MOVLW      0
	SUBWFB     R1, 0
	MOVWF      R3
	MOVLW      128
	XORWF      R3, 0
	MOVWF      R0
	MOVLW      128
	SUBWF      R0, 0
	BTFSS      STATUS+0, 2
	GOTO       L__sharp_ind631
	MOVF       R4, 0
	SUBWF      R2, 0
L__sharp_ind631:
	BTFSC      STATUS+0, 0
	GOTO       L_sharp_ind103
	MOVLW      5
	MOVWF      R0
	MOVF       main22_L_mult+0, 0
	MOVWF      sharp_ind_max_range_L0+0
	MOVF       R0, 0
L__sharp_ind632:
	BTFSC      STATUS+0, 2
	GOTO       L__sharp_ind633
	LSLF       sharp_ind_max_range_L0+0, 1
	ADDLW      255
	GOTO       L__sharp_ind632
L__sharp_ind633:
	DECF       sharp_ind_max_range_L0+0, 1
L_sharp_ind103:
;main.h,312 :: 		if(ind>range) min_range = ind - range; else min_range = 0;
	MOVF       main22_ind+0, 0
	SUBWF      sharp_ind_range_L0+0, 0
	BTFSC      STATUS+0, 0
	GOTO       L_sharp_ind104
	MOVF       sharp_ind_range_L0+0, 0
	SUBWF      main22_ind+0, 0
	MOVWF      sharp_ind_min_range_L0+0
	GOTO       L_sharp_ind105
L_sharp_ind104:
	CLRF       sharp_ind_min_range_L0+0
L_sharp_ind105:
;main.h,313 :: 		ind = min_range;
	MOVF       sharp_ind_min_range_L0+0, 0
	MOVWF      main22_ind+0
;main.h,314 :: 		set_ind(ind);
	MOVF       sharp_ind_min_range_L0+0, 0
	MOVWF      FARG_set_ind_Ind+0
	CALL       _set_ind+0
;main.h,315 :: 		get_swr(); if(SWR==0) return;
	CALL       _get_swr+0
	MOVLW      0
	XORWF      _SWR+1, 0
	BTFSS      STATUS+0, 2
	GOTO       L__sharp_ind634
	MOVLW      0
	XORWF      _SWR+0, 0
L__sharp_ind634:
	BTFSS      STATUS+0, 2
	GOTO       L_sharp_ind106
	GOTO       L_end_sharp_ind
L_sharp_ind106:
;main.h,316 :: 		min_SWR = SWR;
	MOVF       _SWR+0, 0
	MOVWF      sharp_ind_min_SWR_L0+0
	MOVF       _SWR+1, 0
	MOVWF      sharp_ind_min_SWR_L0+1
;main.h,317 :: 		for(count=min_range+L_mult; count<=max_range; count+=L_mult) {
	MOVF       main22_L_mult+0, 0
	ADDWF      sharp_ind_min_range_L0+0, 0
	MOVWF      sharp_ind_count_L0+0
L_sharp_ind107:
	MOVF       sharp_ind_count_L0+0, 0
	SUBWF      sharp_ind_max_range_L0+0, 0
	BTFSS      STATUS+0, 0
	GOTO       L_sharp_ind108
;main.h,318 :: 		set_ind(count);
	MOVF       sharp_ind_count_L0+0, 0
	MOVWF      FARG_set_ind_Ind+0
	CALL       _set_ind+0
;main.h,319 :: 		get_swr(); if(SWR==0) return;
	CALL       _get_swr+0
	MOVLW      0
	XORWF      _SWR+1, 0
	BTFSS      STATUS+0, 2
	GOTO       L__sharp_ind635
	MOVLW      0
	XORWF      _SWR+0, 0
L__sharp_ind635:
	BTFSS      STATUS+0, 2
	GOTO       L_sharp_ind110
	GOTO       L_end_sharp_ind
L_sharp_ind110:
;main.h,320 :: 		if(SWR>=min_SWR) { Delay_ms(10); get_swr(); }
	MOVLW      128
	XORWF      _SWR+1, 0
	MOVWF      R0
	MOVLW      128
	XORWF      sharp_ind_min_SWR_L0+1, 0
	SUBWF      R0, 0
	BTFSS      STATUS+0, 2
	GOTO       L__sharp_ind636
	MOVF       sharp_ind_min_SWR_L0+0, 0
	SUBWF      _SWR+0, 0
L__sharp_ind636:
	BTFSS      STATUS+0, 0
	GOTO       L_sharp_ind111
	MOVLW      52
	MOVWF      R12
	MOVLW      241
	MOVWF      R13
L_sharp_ind112:
	DECFSZ     R13, 1
	GOTO       L_sharp_ind112
	DECFSZ     R12, 1
	GOTO       L_sharp_ind112
	NOP
	NOP
	CALL       _get_swr+0
L_sharp_ind111:
;main.h,321 :: 		if(SWR>=min_SWR) { Delay_ms(10); get_swr(); }
	MOVLW      128
	XORWF      _SWR+1, 0
	MOVWF      R0
	MOVLW      128
	XORWF      sharp_ind_min_SWR_L0+1, 0
	SUBWF      R0, 0
	BTFSS      STATUS+0, 2
	GOTO       L__sharp_ind637
	MOVF       sharp_ind_min_SWR_L0+0, 0
	SUBWF      _SWR+0, 0
L__sharp_ind637:
	BTFSS      STATUS+0, 0
	GOTO       L_sharp_ind113
	MOVLW      52
	MOVWF      R12
	MOVLW      241
	MOVWF      R13
L_sharp_ind114:
	DECFSZ     R13, 1
	GOTO       L_sharp_ind114
	DECFSZ     R12, 1
	GOTO       L_sharp_ind114
	NOP
	NOP
	CALL       _get_swr+0
L_sharp_ind113:
;main.h,322 :: 		if(SWR < min_SWR) {
	MOVLW      128
	XORWF      _SWR+1, 0
	MOVWF      R0
	MOVLW      128
	XORWF      sharp_ind_min_SWR_L0+1, 0
	SUBWF      R0, 0
	BTFSS      STATUS+0, 2
	GOTO       L__sharp_ind638
	MOVF       sharp_ind_min_SWR_L0+0, 0
	SUBWF      _SWR+0, 0
L__sharp_ind638:
	BTFSC      STATUS+0, 0
	GOTO       L_sharp_ind115
;main.h,323 :: 		min_SWR = SWR;
	MOVF       _SWR+0, 0
	MOVWF      sharp_ind_min_SWR_L0+0
	MOVF       _SWR+1, 0
	MOVWF      sharp_ind_min_SWR_L0+1
;main.h,324 :: 		ind = count;
	MOVF       sharp_ind_count_L0+0, 0
	MOVWF      main22_ind+0
;main.h,325 :: 		if(SWR<120) break;
	MOVLW      128
	XORWF      _SWR+1, 0
	MOVWF      R0
	MOVLW      128
	SUBWF      R0, 0
	BTFSS      STATUS+0, 2
	GOTO       L__sharp_ind639
	MOVLW      120
	SUBWF      _SWR+0, 0
L__sharp_ind639:
	BTFSC      STATUS+0, 0
	GOTO       L_sharp_ind116
	GOTO       L_sharp_ind108
L_sharp_ind116:
;main.h,326 :: 		}
	GOTO       L_sharp_ind117
L_sharp_ind115:
;main.h,327 :: 		else break;
	GOTO       L_sharp_ind108
L_sharp_ind117:
;main.h,317 :: 		for(count=min_range+L_mult; count<=max_range; count+=L_mult) {
	MOVF       main22_L_mult+0, 0
	ADDWF      sharp_ind_count_L0+0, 1
;main.h,328 :: 		}
	GOTO       L_sharp_ind107
L_sharp_ind108:
;main.h,329 :: 		set_ind(ind);
	MOVF       main22_ind+0, 0
	MOVWF      FARG_set_ind_Ind+0
	CALL       _set_ind+0
;main.h,330 :: 		return;
;main.h,331 :: 		}
L_end_sharp_ind:
	RETURN
; end of _sharp_ind

_sub_tune:

;main.h,334 :: 		void sub_tune () {
;main.h,337 :: 		swr_mem = SWR;
	MOVF       _SWR+0, 0
	MOVWF      sub_tune_swr_mem_L0+0
	MOVF       _SWR+1, 0
	MOVWF      sub_tune_swr_mem_L0+1
;main.h,338 :: 		coarse_tune(); if(SWR==0) {atu_reset(); return;}
	CALL       _coarse_tune+0
	MOVLW      0
	XORWF      _SWR+1, 0
	BTFSS      STATUS+0, 2
	GOTO       L__sub_tune641
	MOVLW      0
	XORWF      _SWR+0, 0
L__sub_tune641:
	BTFSS      STATUS+0, 2
	GOTO       L_sub_tune118
	CALL       _atu_reset+0
	GOTO       L_end_sub_tune
L_sub_tune118:
;main.h,339 :: 		get_swr(); if(SWR<120) return;
	CALL       _get_swr+0
	MOVLW      128
	XORWF      _SWR+1, 0
	MOVWF      R0
	MOVLW      128
	SUBWF      R0, 0
	BTFSS      STATUS+0, 2
	GOTO       L__sub_tune642
	MOVLW      120
	SUBWF      _SWR+0, 0
L__sub_tune642:
	BTFSC      STATUS+0, 0
	GOTO       L_sub_tune119
	GOTO       L_end_sub_tune
L_sub_tune119:
;main.h,340 :: 		sharp_ind();  if(SWR==0) {atu_reset(); return;}
	CALL       _sharp_ind+0
	MOVLW      0
	XORWF      _SWR+1, 0
	BTFSS      STATUS+0, 2
	GOTO       L__sub_tune643
	MOVLW      0
	XORWF      _SWR+0, 0
L__sub_tune643:
	BTFSS      STATUS+0, 2
	GOTO       L_sub_tune120
	CALL       _atu_reset+0
	GOTO       L_end_sub_tune
L_sub_tune120:
;main.h,341 :: 		get_swr(); if(SWR<120) return;
	CALL       _get_swr+0
	MOVLW      128
	XORWF      _SWR+1, 0
	MOVWF      R0
	MOVLW      128
	SUBWF      R0, 0
	BTFSS      STATUS+0, 2
	GOTO       L__sub_tune644
	MOVLW      120
	SUBWF      _SWR+0, 0
L__sub_tune644:
	BTFSC      STATUS+0, 0
	GOTO       L_sub_tune121
	GOTO       L_end_sub_tune
L_sub_tune121:
;main.h,342 :: 		sharp_cap(); if(SWR==0) {atu_reset(); return;}
	CALL       _sharp_cap+0
	MOVLW      0
	XORWF      _SWR+1, 0
	BTFSS      STATUS+0, 2
	GOTO       L__sub_tune645
	MOVLW      0
	XORWF      _SWR+0, 0
L__sub_tune645:
	BTFSS      STATUS+0, 2
	GOTO       L_sub_tune122
	CALL       _atu_reset+0
	GOTO       L_end_sub_tune
L_sub_tune122:
;main.h,343 :: 		get_swr(); if(SWR<120) return;
	CALL       _get_swr+0
	MOVLW      128
	XORWF      _SWR+1, 0
	MOVWF      R0
	MOVLW      128
	SUBWF      R0, 0
	BTFSS      STATUS+0, 2
	GOTO       L__sub_tune646
	MOVLW      120
	SUBWF      _SWR+0, 0
L__sub_tune646:
	BTFSC      STATUS+0, 0
	GOTO       L_sub_tune123
	GOTO       L_end_sub_tune
L_sub_tune123:
;main.h,345 :: 		if(SWR<200 & SWR<swr_mem & (swr_mem-SWR)>100) return;
	MOVLW      128
	XORWF      _SWR+1, 0
	MOVWF      R1
	MOVLW      128
	SUBWF      R1, 0
	BTFSS      STATUS+0, 2
	GOTO       L__sub_tune647
	MOVLW      200
	SUBWF      _SWR+0, 0
L__sub_tune647:
	MOVLW      1
	BTFSC      STATUS+0, 0
	MOVLW      0
	MOVWF      R1
	MOVLW      128
	XORWF      _SWR+1, 0
	MOVWF      R0
	MOVLW      128
	XORWF      sub_tune_swr_mem_L0+1, 0
	SUBWF      R0, 0
	BTFSS      STATUS+0, 2
	GOTO       L__sub_tune648
	MOVF       sub_tune_swr_mem_L0+0, 0
	SUBWF      _SWR+0, 0
L__sub_tune648:
	MOVLW      1
	BTFSC      STATUS+0, 0
	MOVLW      0
	MOVWF      R0
	MOVF       R0, 0
	ANDWF      R1, 0
	MOVWF      R3
	MOVF       _SWR+0, 0
	SUBWF      sub_tune_swr_mem_L0+0, 0
	MOVWF      R1
	MOVF       _SWR+1, 0
	SUBWFB     sub_tune_swr_mem_L0+1, 0
	MOVWF      R2
	MOVLW      128
	MOVWF      R0
	MOVLW      128
	XORWF      R2, 0
	SUBWF      R0, 0
	BTFSS      STATUS+0, 2
	GOTO       L__sub_tune649
	MOVF       R1, 0
	SUBLW      100
L__sub_tune649:
	MOVLW      1
	BTFSC      STATUS+0, 0
	MOVLW      0
	MOVWF      R0
	MOVF       R3, 0
	ANDWF      R0, 1
	BTFSC      STATUS+0, 2
	GOTO       L_sub_tune124
	GOTO       L_end_sub_tune
L_sub_tune124:
;main.h,346 :: 		swr_mem = SWR;
	MOVF       _SWR+0, 0
	MOVWF      sub_tune_swr_mem_L0+0
	MOVF       _SWR+1, 0
	MOVWF      sub_tune_swr_mem_L0+1
;main.h,347 :: 		ind_mem = ind;
	MOVF       main22_ind+0, 0
	MOVWF      sub_tune_ind_mem_L0+0
	CLRF       sub_tune_ind_mem_L0+1
;main.h,348 :: 		cap_mem = cap;
	MOVF       main22_cap+0, 0
	MOVWF      sub_tune_cap_mem_L0+0
	CLRF       sub_tune_cap_mem_L0+1
;main.h,350 :: 		if(SW==1) SW = 0; else SW = 1;
	MOVF       main22_SW+0, 0
	XORLW      1
	BTFSS      STATUS+0, 2
	GOTO       L_sub_tune125
	CLRF       main22_SW+0
	GOTO       L_sub_tune126
L_sub_tune125:
	MOVLW      1
	MOVWF      main22_SW+0
L_sub_tune126:
;main.h,351 :: 		atu_reset();
	CALL       _atu_reset+0
;main.h,352 :: 		set_sw(SW);
	MOVF       main22_SW+0, 0
	MOVWF      FARG_set_sw_SW+0
	CALL       _set_sw+0
;main.h,353 :: 		Delay_ms(50);
	MOVLW      2
	MOVWF      R11
	MOVLW      4
	MOVWF      R12
	MOVLW      186
	MOVWF      R13
L_sub_tune127:
	DECFSZ     R13, 1
	GOTO       L_sub_tune127
	DECFSZ     R12, 1
	GOTO       L_sub_tune127
	DECFSZ     R11, 1
	GOTO       L_sub_tune127
	NOP
;main.h,354 :: 		get_swr(); if(SWR<120) return;
	CALL       _get_swr+0
	MOVLW      128
	XORWF      _SWR+1, 0
	MOVWF      R0
	MOVLW      128
	SUBWF      R0, 0
	BTFSS      STATUS+0, 2
	GOTO       L__sub_tune650
	MOVLW      120
	SUBWF      _SWR+0, 0
L__sub_tune650:
	BTFSC      STATUS+0, 0
	GOTO       L_sub_tune128
	GOTO       L_end_sub_tune
L_sub_tune128:
;main.h,356 :: 		coarse_tune(); if(SWR==0) {atu_reset(); return;}
	CALL       _coarse_tune+0
	MOVLW      0
	XORWF      _SWR+1, 0
	BTFSS      STATUS+0, 2
	GOTO       L__sub_tune651
	MOVLW      0
	XORWF      _SWR+0, 0
L__sub_tune651:
	BTFSS      STATUS+0, 2
	GOTO       L_sub_tune129
	CALL       _atu_reset+0
	GOTO       L_end_sub_tune
L_sub_tune129:
;main.h,357 :: 		get_swr(); if(SWR<120) return;
	CALL       _get_swr+0
	MOVLW      128
	XORWF      _SWR+1, 0
	MOVWF      R0
	MOVLW      128
	SUBWF      R0, 0
	BTFSS      STATUS+0, 2
	GOTO       L__sub_tune652
	MOVLW      120
	SUBWF      _SWR+0, 0
L__sub_tune652:
	BTFSC      STATUS+0, 0
	GOTO       L_sub_tune130
	GOTO       L_end_sub_tune
L_sub_tune130:
;main.h,358 :: 		sharp_ind(); if(SWR==0) {atu_reset(); return;}
	CALL       _sharp_ind+0
	MOVLW      0
	XORWF      _SWR+1, 0
	BTFSS      STATUS+0, 2
	GOTO       L__sub_tune653
	MOVLW      0
	XORWF      _SWR+0, 0
L__sub_tune653:
	BTFSS      STATUS+0, 2
	GOTO       L_sub_tune131
	CALL       _atu_reset+0
	GOTO       L_end_sub_tune
L_sub_tune131:
;main.h,359 :: 		get_swr(); if(SWR<120) return;
	CALL       _get_swr+0
	MOVLW      128
	XORWF      _SWR+1, 0
	MOVWF      R0
	MOVLW      128
	SUBWF      R0, 0
	BTFSS      STATUS+0, 2
	GOTO       L__sub_tune654
	MOVLW      120
	SUBWF      _SWR+0, 0
L__sub_tune654:
	BTFSC      STATUS+0, 0
	GOTO       L_sub_tune132
	GOTO       L_end_sub_tune
L_sub_tune132:
;main.h,360 :: 		sharp_cap(); if(SWR==0) {atu_reset(); return;}
	CALL       _sharp_cap+0
	MOVLW      0
	XORWF      _SWR+1, 0
	BTFSS      STATUS+0, 2
	GOTO       L__sub_tune655
	MOVLW      0
	XORWF      _SWR+0, 0
L__sub_tune655:
	BTFSS      STATUS+0, 2
	GOTO       L_sub_tune133
	CALL       _atu_reset+0
	GOTO       L_end_sub_tune
L_sub_tune133:
;main.h,361 :: 		get_swr(); if(SWR<120) return;
	CALL       _get_swr+0
	MOVLW      128
	XORWF      _SWR+1, 0
	MOVWF      R0
	MOVLW      128
	SUBWF      R0, 0
	BTFSS      STATUS+0, 2
	GOTO       L__sub_tune656
	MOVLW      120
	SUBWF      _SWR+0, 0
L__sub_tune656:
	BTFSC      STATUS+0, 0
	GOTO       L_sub_tune134
	GOTO       L_end_sub_tune
L_sub_tune134:
;main.h,363 :: 		if(SWR>swr_mem) {
	MOVLW      128
	XORWF      sub_tune_swr_mem_L0+1, 0
	MOVWF      R0
	MOVLW      128
	XORWF      _SWR+1, 0
	SUBWF      R0, 0
	BTFSS      STATUS+0, 2
	GOTO       L__sub_tune657
	MOVF       _SWR+0, 0
	SUBWF      sub_tune_swr_mem_L0+0, 0
L__sub_tune657:
	BTFSC      STATUS+0, 0
	GOTO       L_sub_tune135
;main.h,364 :: 		if(SW==1) SW = 0; else SW = 1;
	MOVF       main22_SW+0, 0
	XORLW      1
	BTFSS      STATUS+0, 2
	GOTO       L_sub_tune136
	CLRF       main22_SW+0
	GOTO       L_sub_tune137
L_sub_tune136:
	MOVLW      1
	MOVWF      main22_SW+0
L_sub_tune137:
;main.h,365 :: 		set_sw(SW);
	MOVF       main22_SW+0, 0
	MOVWF      FARG_set_sw_SW+0
	CALL       _set_sw+0
;main.h,366 :: 		ind = ind_mem;
	MOVF       sub_tune_ind_mem_L0+0, 0
	MOVWF      main22_ind+0
;main.h,367 :: 		cap = cap_mem;
	MOVF       sub_tune_cap_mem_L0+0, 0
	MOVWF      main22_cap+0
;main.h,368 :: 		set_ind(ind);
	MOVF       sub_tune_ind_mem_L0+0, 0
	MOVWF      FARG_set_ind_Ind+0
	CALL       _set_ind+0
;main.h,369 :: 		set_cap(cap);
	MOVF       main22_cap+0, 0
	MOVWF      FARG_set_cap_Cap+0
	CALL       _set_cap+0
;main.h,370 :: 		SWR = swr_mem;
	MOVF       sub_tune_swr_mem_L0+0, 0
	MOVWF      _SWR+0
	MOVF       sub_tune_swr_mem_L0+1, 0
	MOVWF      _SWR+1
;main.h,371 :: 		}
L_sub_tune135:
;main.h,373 :: 		asm CLRWDT;
	CLRWDT
;main.h,374 :: 		return;
;main.h,375 :: 		}
L_end_sub_tune:
	RETURN
; end of _sub_tune

_tune:

;main.h,379 :: 		void tune() {
;main.h,381 :: 		asm CLRWDT;
	CLRWDT
;main.h,383 :: 		p_cnt = 0;
	CLRF       _p_cnt+0
;main.h,384 :: 		P_max = 0;
	CLRF       _P_max+0
	CLRF       _P_max+1
;main.h,386 :: 		rready = 0;
	CLRF       _rready+0
;main.h,387 :: 		get_swr();
	CALL       _get_swr+0
;main.h,388 :: 		if(SWR<110) return;
	MOVLW      128
	XORWF      _SWR+1, 0
	MOVWF      R0
	MOVLW      128
	SUBWF      R0, 0
	BTFSS      STATUS+0, 2
	GOTO       L__tune659
	MOVLW      110
	SUBWF      _SWR+0, 0
L__tune659:
	BTFSC      STATUS+0, 0
	GOTO       L_tune138
	GOTO       L_end_tune
L_tune138:
;main.h,389 :: 		atu_reset();
	CALL       _atu_reset+0
;main.h,390 :: 		if(Loss_ind==0) lcd_ind();
	MOVF       main22_Loss_ind+0, 0
	XORLW      0
	BTFSS      STATUS+0, 2
	GOTO       L_tune139
	CALL       _lcd_ind+0
L_tune139:
;main.h,391 :: 		Delay_ms(50);
	MOVLW      2
	MOVWF      R11
	MOVLW      4
	MOVWF      R12
	MOVLW      186
	MOVWF      R13
L_tune140:
	DECFSZ     R13, 1
	GOTO       L_tune140
	DECFSZ     R12, 1
	GOTO       L_tune140
	DECFSZ     R11, 1
	GOTO       L_tune140
	NOP
;main.h,392 :: 		get_swr();
	CALL       _get_swr+0
;main.h,393 :: 		swr_a = SWR;
	MOVF       _SWR+0, 0
	MOVWF      _swr_a+0
	MOVF       _SWR+1, 0
	MOVWF      _swr_a+1
;main.h,394 :: 		if(SWR<110) return;
	MOVLW      128
	XORWF      _SWR+1, 0
	MOVWF      R0
	MOVLW      128
	SUBWF      R0, 0
	BTFSS      STATUS+0, 2
	GOTO       L__tune660
	MOVLW      110
	SUBWF      _SWR+0, 0
L__tune660:
	BTFSC      STATUS+0, 0
	GOTO       L_tune141
	GOTO       L_end_tune
L_tune141:
;main.h,395 :: 		if(max_swr>110 & SWR>max_swr) return;
	MOVLW      128
	MOVWF      R1
	MOVLW      128
	XORWF      main22_max_swr+1, 0
	SUBWF      R1, 0
	BTFSS      STATUS+0, 2
	GOTO       L__tune661
	MOVF       main22_max_swr+0, 0
	SUBLW      110
L__tune661:
	MOVLW      1
	BTFSC      STATUS+0, 0
	MOVLW      0
	MOVWF      R1
	MOVLW      128
	XORWF      main22_max_swr+1, 0
	MOVWF      R0
	MOVLW      128
	XORWF      _SWR+1, 0
	SUBWF      R0, 0
	BTFSS      STATUS+0, 2
	GOTO       L__tune662
	MOVF       _SWR+0, 0
	SUBWF      main22_max_swr+0, 0
L__tune662:
	MOVLW      1
	BTFSC      STATUS+0, 0
	MOVLW      0
	MOVWF      R0
	MOVF       R1, 0
	ANDWF      R0, 1
	BTFSC      STATUS+0, 2
	GOTO       L_tune142
	GOTO       L_end_tune
L_tune142:
;main.h,397 :: 		sub_tune(); if(SWR==0) {atu_reset(); return;}
	CALL       _sub_tune+0
	MOVLW      0
	XORWF      _SWR+1, 0
	BTFSS      STATUS+0, 2
	GOTO       L__tune663
	MOVLW      0
	XORWF      _SWR+0, 0
L__tune663:
	BTFSS      STATUS+0, 2
	GOTO       L_tune143
	CALL       _atu_reset+0
	GOTO       L_end_tune
L_tune143:
;main.h,398 :: 		if(SWR<120) return;
	MOVLW      128
	XORWF      _SWR+1, 0
	MOVWF      R0
	MOVLW      128
	SUBWF      R0, 0
	BTFSS      STATUS+0, 2
	GOTO       L__tune664
	MOVLW      120
	SUBWF      _SWR+0, 0
L__tune664:
	BTFSC      STATUS+0, 0
	GOTO       L_tune144
	GOTO       L_end_tune
L_tune144:
;main.h,399 :: 		if(C_q==5 & L_q==5) return;
	MOVF       main22_C_q+0, 0
	XORLW      5
	MOVLW      1
	BTFSS      STATUS+0, 2
	MOVLW      0
	MOVWF      R1
	MOVF       main22_L_q+0, 0
	XORLW      5
	MOVLW      1
	BTFSS      STATUS+0, 2
	MOVLW      0
	MOVWF      R0
	MOVF       R1, 0
	ANDWF      R0, 1
	BTFSC      STATUS+0, 2
	GOTO       L_tune145
	GOTO       L_end_tune
L_tune145:
;main.h,401 :: 		if(L_q>5) {
	MOVF       main22_L_q+0, 0
	SUBLW      5
	BTFSC      STATUS+0, 0
	GOTO       L_tune146
;main.h,402 :: 		step_ind = L_mult;
	MOVF       main22_L_mult+0, 0
	MOVWF      main22_step_ind+0
;main.h,403 :: 		L_mult = 1;
	MOVLW      1
	MOVWF      main22_L_mult+0
;main.h,404 :: 		sharp_ind();
	CALL       _sharp_ind+0
;main.h,405 :: 		}
L_tune146:
;main.h,406 :: 		if(SWR<120) return;
	MOVLW      128
	XORWF      _SWR+1, 0
	MOVWF      R0
	MOVLW      128
	SUBWF      R0, 0
	BTFSS      STATUS+0, 2
	GOTO       L__tune665
	MOVLW      120
	SUBWF      _SWR+0, 0
L__tune665:
	BTFSC      STATUS+0, 0
	GOTO       L_tune147
	GOTO       L_end_tune
L_tune147:
;main.h,407 :: 		if(C_q>5) {
	MOVF       main22_C_q+0, 0
	SUBLW      5
	BTFSC      STATUS+0, 0
	GOTO       L_tune148
;main.h,408 :: 		step_cap = C_mult;  // = C_mult
	MOVF       main22_C_mult+0, 0
	MOVWF      main22_step_cap+0
;main.h,409 :: 		C_mult = 1;
	MOVLW      1
	MOVWF      main22_C_mult+0
;main.h,410 :: 		sharp_cap();
	CALL       _sharp_cap+0
;main.h,411 :: 		}
L_tune148:
;main.h,412 :: 		if(L_q==5)L_mult = 1;
	MOVF       main22_L_q+0, 0
	XORLW      5
	BTFSS      STATUS+0, 2
	GOTO       L_tune149
	MOVLW      1
	MOVWF      main22_L_mult+0
	GOTO       L_tune150
L_tune149:
;main.h,413 :: 		else if(L_q==6) L_mult = 2;
	MOVF       main22_L_q+0, 0
	XORLW      6
	BTFSS      STATUS+0, 2
	GOTO       L_tune151
	MOVLW      2
	MOVWF      main22_L_mult+0
	GOTO       L_tune152
L_tune151:
;main.h,414 :: 		else if(L_q==7) L_mult = 4;
	MOVF       main22_L_q+0, 0
	XORLW      7
	BTFSS      STATUS+0, 2
	GOTO       L_tune153
	MOVLW      4
	MOVWF      main22_L_mult+0
L_tune153:
L_tune152:
L_tune150:
;main.h,415 :: 		if(C_q==5) C_mult =1;
	MOVF       main22_C_q+0, 0
	XORLW      5
	BTFSS      STATUS+0, 2
	GOTO       L_tune154
	MOVLW      1
	MOVWF      main22_C_mult+0
	GOTO       L_tune155
L_tune154:
;main.h,416 :: 		else if(C_q==6) C_mult = 2;
	MOVF       main22_C_q+0, 0
	XORLW      6
	BTFSS      STATUS+0, 2
	GOTO       L_tune156
	MOVLW      2
	MOVWF      main22_C_mult+0
	GOTO       L_tune157
L_tune156:
;main.h,417 :: 		else if(C_q==7) C_mult = 4;
	MOVF       main22_C_q+0, 0
	XORLW      7
	BTFSS      STATUS+0, 2
	GOTO       L_tune158
	MOVLW      4
	MOVWF      main22_C_mult+0
L_tune158:
L_tune157:
L_tune155:
;main.h,418 :: 		asm CLRWDT;
	CLRWDT
;main.h,419 :: 		return;
;main.h,420 :: 		}
L_end_tune:
	RETURN
; end of _tune

_main:

;main22.c,32 :: 		void main() {
;main22.c,33 :: 		if(STATUS.B4==0) Restart = 1;
	BTFSC      STATUS+0, 4
	GOTO       L_main159
	MOVLW      1
	MOVWF      _Restart+0
L_main159:
;main22.c,34 :: 		pic_init();
	CALL       _pic_init+0
;main22.c,36 :: 		Delay_ms (100);
	MOVLW      3
	MOVWF      R11
	MOVLW      8
	MOVWF      R12
	MOVLW      119
	MOVWF      R13
L_main160:
	DECFSZ     R13, 1
	GOTO       L_main160
	DECFSZ     R12, 1
	GOTO       L_main160
	DECFSZ     R11, 1
	GOTO       L_main160
;main22.c,37 :: 		asm CLRWDT;
	CLRWDT
;main22.c,38 :: 		cells_init();
	CALL       _cells_init+0
;main22.c,39 :: 		Soft_I2C_Init();
	CALL       _Soft_I2C_Init+0
;main22.c,40 :: 		if(type==0) { // 2-colors led  reset
	MOVF       _type+0, 0
	XORLW      0
	BTFSS      STATUS+0, 2
	GOTO       L_main161
;main22.c,41 :: 		LATB.B6 = 1;
	BSF        LATB+0, 6
;main22.c,42 :: 		LATB.B7 = 1;
	BSF        LATB+0, 7
;main22.c,43 :: 		}
L_main161:
;main22.c,44 :: 		dysp_cnt = Dysp_delay * dysp_cnt_mult;
	MOVF       _Dysp_delay+0, 0
	MOVWF      R0
	CALL       _Byte2Double+0
	MOVF       _dysp_cnt_mult+0, 0
	MOVWF      R4
	MOVF       _dysp_cnt_mult+1, 0
	MOVWF      R5
	MOVF       _dysp_cnt_mult+2, 0
	MOVWF      R6
	MOVF       _dysp_cnt_mult+3, 0
	MOVWF      R7
	CALL       _Mul_32x32_FP+0
	CALL       _Double2Int+0
	MOVF       R0, 0
	MOVWF      _dysp_cnt+0
	MOVF       R1, 0
	MOVWF      _dysp_cnt+1
;main22.c,46 :: 		Delay_ms(200);
	MOVLW      5
	MOVWF      R11
	MOVLW      15
	MOVWF      R12
	MOVLW      241
	MOVWF      R13
L_main162:
	DECFSZ     R13, 1
	GOTO       L_main162
	DECFSZ     R12, 1
	GOTO       L_main162
	DECFSZ     R11, 1
	GOTO       L_main162
;main22.c,47 :: 		asm CLRWDT;
	CLRWDT
;main22.c,49 :: 		if(L_q==5)L_mult = 1;
	MOVF       main22_L_q+0, 0
	XORLW      5
	BTFSS      STATUS+0, 2
	GOTO       L_main163
	MOVLW      1
	MOVWF      main22_L_mult+0
	GOTO       L_main164
L_main163:
;main22.c,50 :: 		else if(L_q==6) L_mult = 2;
	MOVF       main22_L_q+0, 0
	XORLW      6
	BTFSS      STATUS+0, 2
	GOTO       L_main165
	MOVLW      2
	MOVWF      main22_L_mult+0
	GOTO       L_main166
L_main165:
;main22.c,51 :: 		else if(L_q==7) L_mult = 4;
	MOVF       main22_L_q+0, 0
	XORLW      7
	BTFSS      STATUS+0, 2
	GOTO       L_main167
	MOVLW      4
	MOVWF      main22_L_mult+0
L_main167:
L_main166:
L_main164:
;main22.c,52 :: 		if(C_q==5) C_mult =1;
	MOVF       main22_C_q+0, 0
	XORLW      5
	BTFSS      STATUS+0, 2
	GOTO       L_main168
	MOVLW      1
	MOVWF      main22_C_mult+0
	GOTO       L_main169
L_main168:
;main22.c,53 :: 		else if(C_q==6) C_mult = 2;
	MOVF       main22_C_q+0, 0
	XORLW      6
	BTFSS      STATUS+0, 2
	GOTO       L_main170
	MOVLW      2
	MOVWF      main22_C_mult+0
	GOTO       L_main171
L_main170:
;main22.c,54 :: 		else if(C_q==7) C_mult = 4;
	MOVF       main22_C_q+0, 0
	XORLW      7
	BTFSS      STATUS+0, 2
	GOTO       L_main172
	MOVLW      4
	MOVWF      main22_C_mult+0
L_main172:
L_main171:
L_main169:
;main22.c,56 :: 		led_init();
	CALL       _led_init+0
;main22.c,58 :: 		if(Test==0) {
	MOVF       _Test+0, 0
	XORLW      0
	BTFSS      STATUS+0, 2
	GOTO       L_main173
;main22.c,59 :: 		cap = EEPROM_Read(255);
	MOVLW      255
	MOVWF      FARG_EEPROM_Read_Address+0
	CALL       _EEPROM_Read+0
	MOVF       R0, 0
	MOVWF      main22_cap+0
;main22.c,60 :: 		ind = EEPROM_Read(254);
	MOVLW      254
	MOVWF      FARG_EEPROM_Read_Address+0
	CALL       _EEPROM_Read+0
	MOVF       R0, 0
	MOVWF      main22_ind+0
;main22.c,61 :: 		SW = EEPROM_Read(253);
	MOVLW      253
	MOVWF      FARG_EEPROM_Read_Address+0
	CALL       _EEPROM_Read+0
	MOVF       R0, 0
	MOVWF      main22_SW+0
;main22.c,62 :: 		swr_a = EEPROM_Read(252) * 256;
	MOVLW      252
	MOVWF      FARG_EEPROM_Read_Address+0
	CALL       _EEPROM_Read+0
	MOVF       R0, 0
	MOVWF      _swr_a+1
	CLRF       _swr_a+0
;main22.c,63 :: 		swr_a += EEPROM_Read(251);
	MOVLW      251
	MOVWF      FARG_EEPROM_Read_Address+0
	CALL       _EEPROM_Read+0
	MOVF       R0, 0
	ADDWF      _swr_a+0, 1
	MOVLW      0
	ADDWFC     _swr_a+1, 1
;main22.c,64 :: 		set_ind(ind);
	MOVF       main22_ind+0, 0
	MOVWF      FARG_set_ind_Ind+0
	CALL       _set_ind+0
;main22.c,65 :: 		set_cap(cap);
	MOVF       main22_cap+0, 0
	MOVWF      FARG_set_cap_Cap+0
	CALL       _set_cap+0
;main22.c,66 :: 		set_sw(SW);
	MOVF       main22_SW+0, 0
	MOVWF      FARG_set_sw_SW+0
	CALL       _set_sw+0
;main22.c,67 :: 		if(Restart==1 ) lcd_prep_short = 1;
	MOVF       _Restart+0, 0
	XORLW      1
	BTFSS      STATUS+0, 2
	GOTO       L_main174
	MOVLW      1
	MOVWF      _lcd_prep_short+0
L_main174:
;main22.c,68 :: 		lcd_prep();
	CALL       _lcd_prep+0
;main22.c,69 :: 		}
L_main173:
;main22.c,71 :: 		lcd_ind();
	CALL       _lcd_ind+0
;main22.c,77 :: 		while(1) {
L_main175:
;main22.c,78 :: 		asm CLRWDT;
	CLRWDT
;main22.c,79 :: 		lcd_pwr();
	CALL       _lcd_pwr+0
;main22.c,81 :: 		if(Test==0) button_proc();
	MOVF       _Test+0, 0
	XORLW      0
	BTFSS      STATUS+0, 2
	GOTO       L_main177
	CALL       _button_proc+0
	GOTO       L_main178
L_main177:
;main22.c,82 :: 		else button_proc_test();
	CALL       _button_proc_test+0
L_main178:
;main22.c,84 :: 		if(dysp_cnt!=0) dysp_cnt --;
	MOVLW      0
	XORWF      _dysp_cnt+1, 0
	BTFSS      STATUS+0, 2
	GOTO       L__main667
	MOVLW      0
	XORWF      _dysp_cnt+0, 0
L__main667:
	BTFSC      STATUS+0, 2
	GOTO       L_main179
	MOVLW      1
	SUBWF      _dysp_cnt+0, 1
	MOVLW      0
	SUBWFB     _dysp_cnt+1, 1
	GOTO       L_main180
L_main179:
;main22.c,85 :: 		else if(Test==0 & Dysp_delay!=0) dysp_off();
	MOVF       _Test+0, 0
	XORLW      0
	MOVLW      1
	BTFSS      STATUS+0, 2
	MOVLW      0
	MOVWF      R1
	MOVF       _Dysp_delay+0, 0
	XORLW      0
	MOVLW      1
	BTFSC      STATUS+0, 2
	MOVLW      0
	MOVWF      R0
	MOVF       R1, 0
	ANDWF      R0, 1
	BTFSC      STATUS+0, 2
	GOTO       L_main181
	CALL       _dysp_off+0
L_main181:
L_main180:
;main22.c,89 :: 		}
	GOTO       L_main175
;main22.c,90 :: 		}
L_end_main:
	GOTO       $+0
; end of _main

_button_proc_test:

;main22.c,95 :: 		void button_proc_test(void) {
;main22.c,96 :: 		if(Button(&PORTB, 0, 50, 0)){    // Tune btn
	MOVLW      PORTB+0
	MOVWF      FARG_Button_port+0
	MOVLW      hi_addr(PORTB+0)
	MOVWF      FARG_Button_port+1
	CLRF       FARG_Button_pin+0
	MOVLW      50
	MOVWF      FARG_Button_time_ms+0
	CLRF       FARG_Button_active_state+0
	CALL       _Button+0
	MOVF       R0, 0
	BTFSC      STATUS+0, 2
	GOTO       L_button_proc_test182
;main22.c,97 :: 		Delay_ms(250);
	MOVLW      6
	MOVWF      R11
	MOVLW      19
	MOVWF      R12
	MOVLW      173
	MOVWF      R13
L_button_proc_test183:
	DECFSZ     R13, 1
	GOTO       L_button_proc_test183
	DECFSZ     R12, 1
	GOTO       L_button_proc_test183
	DECFSZ     R11, 1
	GOTO       L_button_proc_test183
	NOP
	NOP
;main22.c,98 :: 		asm CLRWDT;
	CLRWDT
;main22.c,99 :: 		if(PORTB.B0==1) { // short press button
	BTFSS      PORTB+0, 0
	GOTO       L_button_proc_test184
;main22.c,100 :: 		if(SW==0) SW = 1; else SW = 0;
	MOVF       main22_SW+0, 0
	XORLW      0
	BTFSS      STATUS+0, 2
	GOTO       L_button_proc_test185
	MOVLW      1
	MOVWF      main22_SW+0
	GOTO       L_button_proc_test186
L_button_proc_test185:
	CLRF       main22_SW+0
L_button_proc_test186:
;main22.c,101 :: 		set_sw(SW);
	MOVF       main22_SW+0, 0
	MOVWF      FARG_set_sw_SW+0
	CALL       _set_sw+0
;main22.c,102 :: 		lcd_ind();
	CALL       _lcd_ind+0
;main22.c,103 :: 		}
	GOTO       L_button_proc_test187
L_button_proc_test184:
;main22.c,105 :: 		if(L==1) L = 0; else L = 1;
	MOVF       _L+0, 0
	XORLW      1
	BTFSS      STATUS+0, 2
	GOTO       L_button_proc_test188
	CLRF       _L+0
	GOTO       L_button_proc_test189
L_button_proc_test188:
	MOVLW      1
	MOVWF      _L+0
L_button_proc_test189:
;main22.c,106 :: 		if(L==1) {
	MOVF       _L+0, 0
	XORLW      1
	BTFSS      STATUS+0, 2
	GOTO       L_button_proc_test190
;main22.c,107 :: 		if(type==4 |type==5)   // 128*64 OLED
	MOVF       _type+0, 0
	XORLW      4
	MOVLW      1
	BTFSS      STATUS+0, 2
	MOVLW      0
	MOVWF      R1
	MOVF       _type+0, 0
	XORLW      5
	MOVLW      1
	BTFSS      STATUS+0, 2
	MOVLW      0
	MOVWF      R0
	MOVF       R1, 0
	IORWF       R0, 1
	BTFSC      STATUS+0, 2
	GOTO       L_button_proc_test191
;main22.c,108 :: 		led_wr_str (0, 16+12*8, "l", 1);
	CLRF       FARG_led_wr_str+0
	MOVLW      112
	MOVWF      FARG_led_wr_str+0
	MOVLW      ?lstr1_main22+0
	MOVWF      FARG_led_wr_str+0
	MOVLW      hi_addr(?lstr1_main22+0)
	MOVWF      FARG_led_wr_str+1
	MOVLW      1
	MOVWF      FARG_led_wr_str+0
	CALL       _led_wr_str+0
	GOTO       L_button_proc_test192
L_button_proc_test191:
;main22.c,109 :: 		else if(type!=0)              // 1602 LCD & 128*32 OLED
	MOVF       _type+0, 0
	XORLW      0
	BTFSC      STATUS+0, 2
	GOTO       L_button_proc_test193
;main22.c,110 :: 		led_wr_str (0, 8, "l", 1);
	CLRF       FARG_led_wr_str+0
	MOVLW      8
	MOVWF      FARG_led_wr_str+0
	MOVLW      ?lstr2_main22+0
	MOVWF      FARG_led_wr_str+0
	MOVLW      hi_addr(?lstr2_main22+0)
	MOVWF      FARG_led_wr_str+1
	MOVLW      1
	MOVWF      FARG_led_wr_str+0
	CALL       _led_wr_str+0
L_button_proc_test193:
L_button_proc_test192:
;main22.c,111 :: 		}
	GOTO       L_button_proc_test194
L_button_proc_test190:
;main22.c,114 :: 		if(type==4 |type==5)   // 128*64 OLED
	MOVF       _type+0, 0
	XORLW      4
	MOVLW      1
	BTFSS      STATUS+0, 2
	MOVLW      0
	MOVWF      R1
	MOVF       _type+0, 0
	XORLW      5
	MOVLW      1
	BTFSS      STATUS+0, 2
	MOVLW      0
	MOVWF      R0
	MOVF       R1, 0
	IORWF       R0, 1
	BTFSC      STATUS+0, 2
	GOTO       L_button_proc_test195
;main22.c,115 :: 		led_wr_str (0, 16+12*8, "c", 1);
	CLRF       FARG_led_wr_str+0
	MOVLW      112
	MOVWF      FARG_led_wr_str+0
	MOVLW      ?lstr3_main22+0
	MOVWF      FARG_led_wr_str+0
	MOVLW      hi_addr(?lstr3_main22+0)
	MOVWF      FARG_led_wr_str+1
	MOVLW      1
	MOVWF      FARG_led_wr_str+0
	CALL       _led_wr_str+0
	GOTO       L_button_proc_test196
L_button_proc_test195:
;main22.c,116 :: 		else if(type!=0)              // 1602 LCD & 128*32 OLED
	MOVF       _type+0, 0
	XORLW      0
	BTFSC      STATUS+0, 2
	GOTO       L_button_proc_test197
;main22.c,117 :: 		led_wr_str (0, 8, "c", 1);
	CLRF       FARG_led_wr_str+0
	MOVLW      8
	MOVWF      FARG_led_wr_str+0
	MOVLW      ?lstr4_main22+0
	MOVWF      FARG_led_wr_str+0
	MOVLW      hi_addr(?lstr4_main22+0)
	MOVWF      FARG_led_wr_str+1
	MOVLW      1
	MOVWF      FARG_led_wr_str+0
	CALL       _led_wr_str+0
L_button_proc_test197:
L_button_proc_test196:
;main22.c,118 :: 		}
L_button_proc_test194:
;main22.c,119 :: 		Delay_ms(1500);
	MOVLW      31
	MOVWF      R11
	MOVLW      113
	MOVWF      R12
	MOVLW      30
	MOVWF      R13
L_button_proc_test198:
	DECFSZ     R13, 1
	GOTO       L_button_proc_test198
	DECFSZ     R12, 1
	GOTO       L_button_proc_test198
	DECFSZ     R11, 1
	GOTO       L_button_proc_test198
	NOP
;main22.c,120 :: 		asm CLRWDT;
	CLRWDT
;main22.c,121 :: 		if(PORTB.B0==0) {     // long press button
	BTFSC      PORTB+0, 0
	GOTO       L_button_proc_test199
;main22.c,122 :: 		Test = 0; // wery long press button
	CLRF       _Test+0
;main22.c,123 :: 		if(EEPROM_Read(2) == 1) Auto = 1;
	MOVLW      2
	MOVWF      FARG_EEPROM_Read_Address+0
	CALL       _EEPROM_Read+0
	MOVF       R0, 0
	XORLW      1
	BTFSS      STATUS+0, 2
	GOTO       L_button_proc_test200
	MOVLW      1
	MOVWF      _Auto+0
L_button_proc_test200:
;main22.c,125 :: 		EEPROM_Write(255, cap);
	MOVLW      255
	MOVWF      FARG_EEPROM_Write_Address+0
	MOVF       main22_cap+0, 0
	MOVWF      FARG_EEPROM_Write_data_+0
	CALL       _EEPROM_Write+0
;main22.c,126 :: 		EEPROM_Write(254, ind);
	MOVLW      254
	MOVWF      FARG_EEPROM_Write_Address+0
	MOVF       main22_ind+0, 0
	MOVWF      FARG_EEPROM_Write_data_+0
	CALL       _EEPROM_Write+0
;main22.c,127 :: 		EEPROM_Write(253, SW);
	MOVLW      253
	MOVWF      FARG_EEPROM_Write_Address+0
	MOVF       main22_SW+0, 0
	MOVWF      FARG_EEPROM_Write_data_+0
	CALL       _EEPROM_Write+0
;main22.c,128 :: 		EEPROM_Write(252, swr_a/256);
	MOVLW      252
	MOVWF      FARG_EEPROM_Write_Address+0
	MOVF       _swr_a+1, 0
	MOVWF      R0
	MOVLW      0
	BTFSC      _swr_a+1, 7
	MOVLW      255
	MOVWF      R1
	MOVF       R0, 0
	MOVWF      FARG_EEPROM_Write_data_+0
	CALL       _EEPROM_Write+0
;main22.c,129 :: 		EEPROM_Write(251, swr_a%256);
	MOVLW      251
	MOVWF      FARG_EEPROM_Write_Address+0
	MOVLW      0
	MOVWF      R4
	MOVLW      1
	MOVWF      R5
	MOVF       _swr_a+0, 0
	MOVWF      R0
	MOVF       _swr_a+1, 0
	MOVWF      R1
	CALL       _Div_16x16_S+0
	MOVF       R8, 0
	MOVWF      R0
	MOVF       R9, 0
	MOVWF      R1
	MOVF       R0, 0
	MOVWF      FARG_EEPROM_Write_data_+0
	CALL       _EEPROM_Write+0
;main22.c,131 :: 		if(type==4 | type==5) {    // 128*64 OLED
	MOVF       _type+0, 0
	XORLW      4
	MOVLW      1
	BTFSS      STATUS+0, 2
	MOVLW      0
	MOVWF      R1
	MOVF       _type+0, 0
	XORLW      5
	MOVLW      1
	BTFSS      STATUS+0, 2
	MOVLW      0
	MOVWF      R0
	MOVF       R1, 0
	IORWF       R0, 1
	BTFSC      STATUS+0, 2
	GOTO       L_button_proc_test201
;main22.c,132 :: 		led_wr_str (2, 16, "AUTO    ", 8);
	MOVLW      2
	MOVWF      FARG_led_wr_str+0
	MOVLW      16
	MOVWF      FARG_led_wr_str+0
	MOVLW      ?lstr5_main22+0
	MOVWF      FARG_led_wr_str+0
	MOVLW      hi_addr(?lstr5_main22+0)
	MOVWF      FARG_led_wr_str+1
	MOVLW      8
	MOVWF      FARG_led_wr_str+0
	CALL       _led_wr_str+0
;main22.c,133 :: 		asm CLRWDT;
	CLRWDT
;main22.c,134 :: 		delay_ms(1000);
	MOVLW      21
	MOVWF      R11
	MOVLW      75
	MOVWF      R12
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
	GOTO       L_button_proc_test212
	CLRF       FARG_led_wr_str+0
	MOVLW      8
	MOVWF      FARG_led_wr_str+0
	MOVLW      ?lstr13_main22+0
	MOVWF      FARG_led_wr_str+0
	MOVLW      hi_addr(?lstr13_main22+0)
	MOVWF      FARG_led_wr_str+1
	MOVLW      1
	MOVWF      FARG_led_wr_str+0
	CALL       _led_wr_str+0
	GOTO       L_button_proc_test213
L_button_proc_test212:
;main22.c,148 :: 		else led_wr_str (0, 8, " ", 1);
	CLRF       FARG_led_wr_str+0
	MOVLW      8
	MOVWF      FARG_led_wr_str+0
	MOVLW      ?lstr14_main22+0
	MOVWF      FARG_led_wr_str+0
	MOVLW      hi_addr(?lstr14_main22+0)
	MOVWF      FARG_led_wr_str+1
	MOVLW      1
	MOVWF      FARG_led_wr_str+0
	CALL       _led_wr_str+0
L_button_proc_test213:
L_button_proc_test211:
;main22.c,149 :: 		asm CLRWDT;
	CLRWDT
;main22.c,150 :: 		}
L_button_proc_test208:
L_button_proc_test207:
;main22.c,151 :: 		}
L_button_proc_test199:
;main22.c,152 :: 		}
L_button_proc_test187:
;main22.c,153 :: 		while(Button(&PORTB, 0, 50, 0)) {lcd_pwr(); asm CLRWDT ;   }
L_button_proc_test214:
	MOVLW      PORTB+0
	MOVWF      FARG_Button_port+0
	MOVLW      hi_addr(PORTB+0)
	MOVWF      FARG_Button_port+1
	CLRF       FARG_Button_pin+0
	MOVLW      50
	MOVWF      FARG_Button_time_ms+0
	CLRF       FARG_Button_active_state+0
	CALL       _Button+0
	MOVF       R0, 0
	BTFSC      STATUS+0, 2
	GOTO       L_button_proc_test215
	CALL       _lcd_pwr+0
	CLRWDT
	GOTO       L_button_proc_test214
L_button_proc_test215:
;main22.c,154 :: 		}  // END Tune btn
L_button_proc_test182:
;main22.c,156 :: 		if(Button(&PORTB, 2, 50, 0)){   // BYP button
	MOVLW      PORTB+0
	MOVWF      FARG_Button_port+0
	MOVLW      hi_addr(PORTB+0)
	MOVWF      FARG_Button_port+1
	MOVLW      2
	MOVWF      FARG_Button_pin+0
	MOVLW      50
	MOVWF      FARG_Button_time_ms+0
	CLRF       FARG_Button_active_state+0
	CALL       _Button+0
	MOVF       R0, 0
	BTFSC      STATUS+0, 2
	GOTO       L_button_proc_test216
;main22.c,157 :: 		asm CLRWDT;
	CLRWDT
;main22.c,158 :: 		while(PORTB.B2==0) {
L_button_proc_test217:
	BTFSC      PORTB+0, 2
	GOTO       L_button_proc_test218
;main22.c,159 :: 		if(L & ind<32*L_mult-1) {
	MOVLW      5
	MOVWF      R2
	MOVF       main22_L_mult+0, 0
	MOVWF      R0
	CLRF       R1
	MOVF       R2, 0
L__button_proc_test669:
	BTFSC      STATUS+0, 2
	GOTO       L__button_proc_test670
	LSLF       R0, 1
	RLF        R1, 1
	ADDLW      255
	GOTO       L__button_proc_test669
L__button_proc_test670:
	MOVLW      1
	SUBWF      R0, 0
	MOVWF      R2
	MOVLW      0
	SUBWFB     R1, 0
	MOVWF      R3
	MOVLW      128
	MOVWF      R0
	MOVLW      128
	XORWF      R3, 0
	SUBWF      R0, 0
	BTFSS      STATUS+0, 2
	GOTO       L__button_proc_test671
	MOVF       R2, 0
	SUBWF      main22_ind+0, 0
L__button_proc_test671:
	MOVLW      1
	BTFSC      STATUS+0, 0
	MOVLW      0
	MOVWF      R0
	MOVF       _L+0, 0
	ANDWF      R0, 1
	BTFSC      STATUS+0, 2
	GOTO       L_button_proc_test219
;main22.c,160 :: 		ind ++;
	INCF       main22_ind+0, 1
;main22.c,161 :: 		set_ind(ind);
	MOVF       main22_ind+0, 0
	MOVWF      FARG_set_ind_Ind+0
	CALL       _set_ind+0
;main22.c,162 :: 		}
	GOTO       L_button_proc_test220
L_button_proc_test219:
;main22.c,163 :: 		else if(!L & cap<32*L_mult-1) {
	MOVF       _L+0, 0
	MOVLW      1
	BTFSS      STATUS+0, 2
	MOVLW      0
	MOVWF      R4
	MOVLW      5
	MOVWF      R2
	MOVF       main22_L_mult+0, 0
	MOVWF      R0
	CLRF       R1
	MOVF       R2, 0
L__button_proc_test672:
	BTFSC      STATUS+0, 2
	GOTO       L__button_proc_test673
	LSLF       R0, 1
	RLF        R1, 1
	ADDLW      255
	GOTO       L__button_proc_test672
L__button_proc_test673:
	MOVLW      1
	SUBWF      R0, 0
	MOVWF      R2
	MOVLW      0
	SUBWFB     R1, 0
	MOVWF      R3
	MOVLW      128
	MOVWF      R0
	MOVLW      128
	XORWF      R3, 0
	SUBWF      R0, 0
	BTFSS      STATUS+0, 2
	GOTO       L__button_proc_test674
	MOVF       R2, 0
	SUBWF      main22_cap+0, 0
L__button_proc_test674:
	MOVLW      1
	BTFSC      STATUS+0, 0
	MOVLW      0
	MOVWF      R0
	MOVF       R4, 0
	ANDWF      R0, 1
	BTFSC      STATUS+0, 2
	GOTO       L_button_proc_test221
;main22.c,164 :: 		cap ++;
	INCF       main22_cap+0, 1
;main22.c,165 :: 		set_cap(cap);
	MOVF       main22_cap+0, 0
	MOVWF      FARG_set_cap_Cap+0
	CALL       _set_cap+0
;main22.c,166 :: 		}
L_button_proc_test221:
L_button_proc_test220:
;main22.c,167 :: 		lcd_ind();
	CALL       _lcd_ind+0
;main22.c,168 :: 		lcd_pwr();
	CALL       _lcd_pwr+0
;main22.c,169 :: 		Delay_ms(30);
	MOVLW      156
	MOVWF      R12
	MOVLW      215
	MOVWF      R13
L_button_proc_test222:
	DECFSZ     R13, 1
	GOTO       L_button_proc_test222
	DECFSZ     R12, 1
	GOTO       L_button_proc_test222
;main22.c,170 :: 		asm CLRWDT;
	CLRWDT
;main22.c,171 :: 		}
	GOTO       L_button_proc_test217
L_button_proc_test218:
;main22.c,172 :: 		}
L_button_proc_test216:
;main22.c,175 :: 		if(Button(&PORTB, 1, 50, 0) & Bypas==0){   // Auto button
	MOVLW      PORTB+0
	MOVWF      FARG_Button_port+0
	MOVLW      hi_addr(PORTB+0)
	MOVWF      FARG_Button_port+1
	MOVLW      1
	MOVWF      FARG_Button_pin+0
	MOVLW      50
	MOVWF      FARG_Button_time_ms+0
	CLRF       FARG_Button_active_state+0
	CALL       _Button+0
	MOVF       _bypas+0, 0
	XORLW      0
	MOVLW      1
	BTFSS      STATUS+0, 2
	MOVLW      0
	MOVWF      R1
	MOVF       R1, 0
	ANDWF      R0, 1
	BTFSC      STATUS+0, 2
	GOTO       L_button_proc_test223
;main22.c,176 :: 		asm CLRWDT;
	CLRWDT
;main22.c,177 :: 		while(PORTB.B1==0) {
L_button_proc_test224:
	BTFSC      PORTB+0, 1
	GOTO       L_button_proc_test225
;main22.c,178 :: 		if(L & ind>0) {
	MOVF       main22_ind+0, 0
	SUBLW      0
	MOVLW      1
	BTFSC      STATUS+0, 0
	MOVLW      0
	MOVWF      R0
	MOVF       _L+0, 0
	ANDWF      R0, 1
	BTFSC      STATUS+0, 2
	GOTO       L_button_proc_test226
;main22.c,179 :: 		ind --;
	DECF       main22_ind+0, 1
;main22.c,180 :: 		set_ind(ind);
	MOVF       main22_ind+0, 0
	MOVWF      FARG_set_ind_Ind+0
	CALL       _set_ind+0
;main22.c,181 :: 		}
	GOTO       L_button_proc_test227
L_button_proc_test226:
;main22.c,182 :: 		else if(!L & cap>0) {
	MOVF       _L+0, 0
	MOVLW      1
	BTFSS      STATUS+0, 2
	MOVLW      0
	MOVWF      R1
	MOVF       main22_cap+0, 0
	SUBLW      0
	MOVLW      1
	BTFSC      STATUS+0, 0
	MOVLW      0
	MOVWF      R0
	MOVF       R1, 0
	ANDWF      R0, 1
	BTFSC      STATUS+0, 2
	GOTO       L_button_proc_test228
;main22.c,183 :: 		cap --;
	DECF       main22_cap+0, 1
;main22.c,184 :: 		set_cap(cap);
	MOVF       main22_cap+0, 0
	MOVWF      FARG_set_cap_Cap+0
	CALL       _set_cap+0
;main22.c,185 :: 		}
L_button_proc_test228:
L_button_proc_test227:
;main22.c,186 :: 		lcd_ind();
	CALL       _lcd_ind+0
;main22.c,187 :: 		lcd_pwr();
	CALL       _lcd_pwr+0
;main22.c,188 :: 		Delay_ms(30);
	MOVLW      156
	MOVWF      R12
	MOVLW      215
	MOVWF      R13
L_button_proc_test229:
	DECFSZ     R13, 1
	GOTO       L_button_proc_test229
	DECFSZ     R12, 1
	GOTO       L_button_proc_test229
;main22.c,189 :: 		asm CLRWDT;
	CLRWDT
;main22.c,190 :: 		}
	GOTO       L_button_proc_test224
L_button_proc_test225:
;main22.c,191 :: 		}
L_button_proc_test223:
;main22.c,192 :: 		return;
;main22.c,193 :: 		}
L_end_button_proc_test:
	RETURN
; end of _button_proc_test

_button_proc:

;main22.c,196 :: 		void button_proc(void) {
;main22.c,197 :: 		if(Button(&PORTB, 0, 50, 0) | Soft_tune){
	MOVLW      PORTB+0
	MOVWF      FARG_Button_port+0
	MOVLW      hi_addr(PORTB+0)
	MOVWF      FARG_Button_port+1
	CLRF       FARG_Button_pin+0
	MOVLW      50
	MOVWF      FARG_Button_time_ms+0
	CLRF       FARG_Button_active_state+0
	CALL       _Button+0
	MOVF       _Soft_tune+0, 0
	IORWF       R0, 1
	BTFSC      STATUS+0, 2
	GOTO       L_button_proc230
;main22.c,198 :: 		dysp_on();
	CALL       _dysp_on+0
;main22.c,199 :: 		dysp_cnt = Dysp_delay * dysp_cnt_mult;
	MOVF       _Dysp_delay+0, 0
	MOVWF      R0
	CALL       _Byte2Double+0
	MOVF       _dysp_cnt_mult+0, 0
	MOVWF      R4
	MOVF       _dysp_cnt_mult+1, 0
	MOVWF      R5
	MOVF       _dysp_cnt_mult+2, 0
	MOVWF      R6
	MOVF       _dysp_cnt_mult+3, 0
	MOVWF      R7
	CALL       _Mul_32x32_FP+0
	CALL       _Double2Int+0
	MOVF       R0, 0
	MOVWF      _dysp_cnt+0
	MOVF       R1, 0
	MOVWF      _dysp_cnt+1
;main22.c,200 :: 		Delay_ms(250);
	MOVLW      6
	MOVWF      R11
	MOVLW      19
	MOVWF      R12
	MOVLW      173
	MOVWF      R13
L_button_proc231:
	DECFSZ     R13, 1
	GOTO       L_button_proc231
	DECFSZ     R12, 1
	GOTO       L_button_proc231
	DECFSZ     R11, 1
	GOTO       L_button_proc231
	NOP
	NOP
;main22.c,201 :: 		asm CLRWDT;
	CLRWDT
;main22.c,202 :: 		if(Soft_tune == 0 & PORTB.B0==1) { // short press button
	MOVF       _Soft_tune+0, 0
	XORLW      0
	MOVLW      1
	BTFSS      STATUS+0, 2
	MOVLW      0
	MOVWF      R1
	BTFSC      PORTB+0, 0
	GOTO       L__button_proc676
	BCF        3, 0
	GOTO       L__button_proc677
L__button_proc676:
	BSF        3, 0
L__button_proc677:
	CLRF       R0
	BTFSC      3, 0
	INCF       R0, 1
	MOVF       R1, 0
	ANDWF      R0, 1
	BTFSC      STATUS+0, 2
	GOTO       L_button_proc232
;main22.c,203 :: 		show_reset();
	CALL       _show_reset+0
;main22.c,204 :: 		bypas =0;
	CLRF       _bypas+0
;main22.c,205 :: 		}
	GOTO       L_button_proc233
L_button_proc232:
;main22.c,207 :: 		p_Tx = 1;         //
	BSF        LATA7_bit+0, BitPos(LATA7_bit+0)
;main22.c,208 :: 		n_Tx = 0;         // TX request
	BCF        LATA6_bit+0, BitPos(LATA6_bit+0)
;main22.c,209 :: 		Delay_ms(250);    //
	MOVLW      6
	MOVWF      R11
	MOVLW      19
	MOVWF      R12
	MOVLW      173
	MOVWF      R13
L_button_proc234:
	DECFSZ     R13, 1
	GOTO       L_button_proc234
	DECFSZ     R12, 1
	GOTO       L_button_proc234
	DECFSZ     R11, 1
	GOTO       L_button_proc234
	NOP
	NOP
;main22.c,210 :: 		btn_push();
	CALL       _btn_push+0
;main22.c,211 :: 		bypas = 0;
	CLRF       _bypas+0
;main22.c,212 :: 		while(Button(&PORTB, 0, 50, 0)) {lcd_pwr(); asm CLRWDT; }
L_button_proc235:
	MOVLW      PORTB+0
	MOVWF      FARG_Button_port+0
	MOVLW      hi_addr(PORTB+0)
	MOVWF      FARG_Button_port+1
	CLRF       FARG_Button_pin+0
	MOVLW      50
	MOVWF      FARG_Button_time_ms+0
	CLRF       FARG_Button_active_state+0
	CALL       _Button+0
	MOVF       R0, 0
	BTFSC      STATUS+0, 2
	GOTO       L_button_proc236
	CALL       _lcd_pwr+0
	CLRWDT
	GOTO       L_button_proc235
L_button_proc236:
;main22.c,213 :: 		Soft_tune = 0;
	CLRF       _Soft_tune+0
;main22.c,214 :: 		}
L_button_proc233:
;main22.c,215 :: 		}
L_button_proc230:
;main22.c,217 :: 		if(Button(&PORTB, 2, 50, 0)){   // BYP button
	MOVLW      PORTB+0
	MOVWF      FARG_Button_port+0
	MOVLW      hi_addr(PORTB+0)
	MOVWF      FARG_Button_port+1
	MOVLW      2
	MOVWF      FARG_Button_pin+0
	MOVLW      50
	MOVWF      FARG_Button_time_ms+0
	CLRF       FARG_Button_active_state+0
	CALL       _Button+0
	MOVF       R0, 0
	BTFSC      STATUS+0, 2
	GOTO       L_button_proc237
;main22.c,218 :: 		Delay_ms(450);
	MOVLW      10
	MOVWF      R11
	MOVLW      34
	MOVWF      R12
	MOVLW      161
	MOVWF      R13
L_button_proc238:
	DECFSZ     R13, 1
	GOTO       L_button_proc238
	DECFSZ     R12, 1
	GOTO       L_button_proc238
	DECFSZ     R11, 1
	GOTO       L_button_proc238
;main22.c,219 :: 		if(PORTB.B2==1) { // short press button
	BTFSS      PORTB+0, 2
	GOTO       L_button_proc239
;main22.c,220 :: 		dysp_on();
	CALL       _dysp_on+0
;main22.c,221 :: 		dysp_cnt = Dysp_delay * dysp_cnt_mult;
	MOVF       _Dysp_delay+0, 0
	MOVWF      R0
	CALL       _Byte2Double+0
	MOVF       _dysp_cnt_mult+0, 0
	MOVWF      R4
	MOVF       _dysp_cnt_mult+1, 0
	MOVWF      R5
	MOVF       _dysp_cnt_mult+2, 0
	MOVWF      R6
	MOVF       _dysp_cnt_mult+3, 0
	MOVWF      R7
	CALL       _Mul_32x32_FP+0
	CALL       _Double2Int+0
	MOVF       R0, 0
	MOVWF      _dysp_cnt+0
	MOVF       R1, 0
	MOVWF      _dysp_cnt+1
;main22.c,222 :: 		asm CLRWDT;
	CLRWDT
;main22.c,223 :: 		if(bypas == 0) {
	MOVF       _bypas+0, 0
	XORLW      0
	BTFSS      STATUS+0, 2
	GOTO       L_button_proc240
;main22.c,224 :: 		bypas = 1;
	MOVLW      1
	MOVWF      _bypas+0
;main22.c,225 :: 		cap_mem = cap;
	MOVF       main22_cap+0, 0
	MOVWF      _cap_mem+0
;main22.c,226 :: 		ind_mem = ind;
	MOVF       main22_ind+0, 0
	MOVWF      _ind_mem+0
;main22.c,227 :: 		SW_mem = SW;
	MOVF       main22_SW+0, 0
	MOVWF      _SW_mem+0
;main22.c,228 :: 		cap = 0;
	CLRF       main22_cap+0
;main22.c,229 :: 		ind = 0;
	CLRF       main22_ind+0
;main22.c,230 :: 		SW = 1;
	MOVLW      1
	MOVWF      main22_SW+0
;main22.c,231 :: 		set_ind(ind);
	CLRF       FARG_set_ind_Ind+0
	CALL       _set_ind+0
;main22.c,232 :: 		set_cap(cap);
	MOVF       main22_cap+0, 0
	MOVWF      FARG_set_cap_Cap+0
	CALL       _set_cap+0
;main22.c,233 :: 		set_SW(SW);
	MOVF       main22_SW+0, 0
	MOVWF      FARG_set_sw_SW+0
	CALL       _set_sw+0
;main22.c,234 :: 		if(Loss_mode==0) lcd_ind();
	MOVF       _Loss_mode+0, 0
	XORLW      0
	BTFSS      STATUS+0, 2
	GOTO       L_button_proc241
	CALL       _lcd_ind+0
L_button_proc241:
;main22.c,235 :: 		Auto_mem = Auto;
	MOVF       _Auto+0, 0
	MOVWF      _Auto_mem+0
;main22.c,236 :: 		Auto = 0;
	CLRF       _Auto+0
;main22.c,237 :: 		}
	GOTO       L_button_proc242
L_button_proc240:
;main22.c,239 :: 		bypas = 0;
	CLRF       _bypas+0
;main22.c,240 :: 		cap = cap_mem;
	MOVF       _cap_mem+0, 0
	MOVWF      main22_cap+0
;main22.c,241 :: 		ind = ind_mem;
	MOVF       _ind_mem+0, 0
	MOVWF      main22_ind+0
;main22.c,242 :: 		SW = SW_mem;
	MOVF       _SW_mem+0, 0
	MOVWF      main22_SW+0
;main22.c,243 :: 		set_cap(cap);
	MOVF       _cap_mem+0, 0
	MOVWF      FARG_set_cap_Cap+0
	CALL       _set_cap+0
;main22.c,244 :: 		set_ind(ind);
	MOVF       main22_ind+0, 0
	MOVWF      FARG_set_ind_Ind+0
	CALL       _set_ind+0
;main22.c,245 :: 		set_SW(SW);
	MOVF       main22_SW+0, 0
	MOVWF      FARG_set_sw_SW+0
	CALL       _set_sw+0
;main22.c,246 :: 		if(Loss_mode==0) lcd_ind();
	MOVF       _Loss_mode+0, 0
	XORLW      0
	BTFSS      STATUS+0, 2
	GOTO       L_button_proc243
	CALL       _lcd_ind+0
L_button_proc243:
;main22.c,247 :: 		Auto = Auto_mem;
	MOVF       _Auto_mem+0, 0
	MOVWF      _Auto+0
;main22.c,248 :: 		}
L_button_proc242:
;main22.c,249 :: 		if(type==4 | type==5) {      // 128*64 OLED
	MOVF       _type+0, 0
	XORLW      4
	MOVLW      1
	BTFSS      STATUS+0, 2
	MOVLW      0
	MOVWF      R1
	MOVF       _type+0, 0
	XORLW      5
	MOVLW      1
	BTFSS      STATUS+0, 2
	MOVLW      0
	MOVWF      R0
	MOVF       R1, 0
	IORWF       R0, 1
	BTFSC      STATUS+0, 2
	GOTO       L_button_proc244
;main22.c,250 :: 		if(Auto & !Bypas) led_wr_str (0, 16+8*12, ".", 1);
	MOVF       _bypas+0, 0
	MOVLW      1
	BTFSS      STATUS+0, 2
	MOVLW      0
	MOVWF      R0
	MOVF       _Auto+0, 0
	ANDWF      R0, 1
	BTFSC      STATUS+0, 2
	GOTO       L_button_proc245
	CLRF       FARG_led_wr_str+0
	MOVLW      112
	MOVWF      FARG_led_wr_str+0
	MOVLW      ?lstr15_main22+0
	MOVWF      FARG_led_wr_str+0
	MOVLW      hi_addr(?lstr15_main22+0)
	MOVWF      FARG_led_wr_str+1
	MOVLW      1
	MOVWF      FARG_led_wr_str+0
	CALL       _led_wr_str+0
	GOTO       L_button_proc246
L_button_proc245:
;main22.c,251 :: 		else if(!Auto & Bypas) led_wr_str (0, 16+8*12, "_", 1);
	MOVF       _Auto+0, 0
	MOVLW      1
	BTFSS      STATUS+0, 2
	MOVLW      0
	MOVWF      R0
	MOVF       _bypas+0, 0
	ANDWF      R0, 1
	BTFSC      STATUS+0, 2
	GOTO       L_button_proc247
	CLRF       FARG_led_wr_str+0
	MOVLW      112
	MOVWF      FARG_led_wr_str+0
	MOVLW      ?lstr16_main22+0
	MOVWF      FARG_led_wr_str+0
	MOVLW      hi_addr(?lstr16_main22+0)
	MOVWF      FARG_led_wr_str+1
	MOVLW      1
	MOVWF      FARG_led_wr_str+0
	CALL       _led_wr_str+0
	GOTO       L_button_proc248
L_button_proc247:
;main22.c,252 :: 		else led_wr_str (0, 16+8*12, " ", 1);
	CLRF       FARG_led_wr_str+0
	MOVLW      112
	MOVWF      FARG_led_wr_str+0
	MOVLW      ?lstr17_main22+0
	MOVWF      FARG_led_wr_str+0
	MOVLW      hi_addr(?lstr17_main22+0)
	MOVWF      FARG_led_wr_str+1
	MOVLW      1
	MOVWF      FARG_led_wr_str+0
	CALL       _led_wr_str+0
L_button_proc248:
L_button_proc246:
;main22.c,253 :: 		}
	GOTO       L_button_proc249
L_button_proc244:
;main22.c,254 :: 		else if(type!=0) { //  1602 LCD  or 128*32 OLED
	MOVF       _type+0, 0
	XORLW      0
	BTFSC      STATUS+0, 2
	GOTO       L_button_proc250
;main22.c,255 :: 		if(Auto & !Bypas) led_wr_str (0, 8, ".", 1);
	MOVF       _bypas+0, 0
	MOVLW      1
	BTFSS      STATUS+0, 2
	MOVLW      0
	MOVWF      R0
	MOVF       _Auto+0, 0
	ANDWF      R0, 1
	BTFSC      STATUS+0, 2
	GOTO       L_button_proc251
	CLRF       FARG_led_wr_str+0
	MOVLW      8
	MOVWF      FARG_led_wr_str+0
	MOVLW      ?lstr18_main22+0
	MOVWF      FARG_led_wr_str+0
	MOVLW      hi_addr(?lstr18_main22+0)
	MOVWF      FARG_led_wr_str+1
	MOVLW      1
	MOVWF      FARG_led_wr_str+0
	CALL       _led_wr_str+0
	GOTO       L_button_proc252
L_button_proc251:
;main22.c,256 :: 		else if(!Auto & Bypas) led_wr_str (0, 8, "_", 1);
	MOVF       _Auto+0, 0
	MOVLW      1
	BTFSS      STATUS+0, 2
	MOVLW      0
	MOVWF      R0
	MOVF       _bypas+0, 0
	ANDWF      R0, 1
	BTFSC      STATUS+0, 2
	GOTO       L_button_proc253
	CLRF       FARG_led_wr_str+0
	MOVLW      8
	MOVWF      FARG_led_wr_str+0
	MOVLW      ?lstr19_main22+0
	MOVWF      FARG_led_wr_str+0
	MOVLW      hi_addr(?lstr19_main22+0)
	MOVWF      FARG_led_wr_str+1
	MOVLW      1
	MOVWF      FARG_led_wr_str+0
	CALL       _led_wr_str+0
	GOTO       L_button_proc254
L_button_proc253:
;main22.c,257 :: 		else led_wr_str (0, 8, " ", 1);
	CLRF       FARG_led_wr_str+0
	MOVLW      8
	MOVWF      FARG_led_wr_str+0
	MOVLW      ?lstr20_main22+0
	MOVWF      FARG_led_wr_str+0
	MOVLW      hi_addr(?lstr20_main22+0)
	MOVWF      FARG_led_wr_str+1
	MOVLW      1
	MOVWF      FARG_led_wr_str+0
	CALL       _led_wr_str+0
L_button_proc254:
L_button_proc252:
;main22.c,258 :: 		}
L_button_proc250:
L_button_proc249:
;main22.c,259 :: 		asm CLRWDT;
	CLRWDT
;main22.c,260 :: 		while(Button(&PORTB, 2, 50, 0)) {lcd_pwr(); asm CLRWDT;   }
L_button_proc255:
	MOVLW      PORTB+0
	MOVWF      FARG_Button_port+0
	MOVLW      hi_addr(PORTB+0)
	MOVWF      FARG_Button_port+1
	MOVLW      2
	MOVWF      FARG_Button_pin+0
	MOVLW      50
	MOVWF      FARG_Button_time_ms+0
	CLRF       FARG_Button_active_state+0
	CALL       _Button+0
	MOVF       R0, 0
	BTFSC      STATUS+0, 2
	GOTO       L_button_proc256
	CALL       _lcd_pwr+0
	CLRWDT
	GOTO       L_button_proc255
L_button_proc256:
;main22.c,261 :: 		}
	GOTO       L_button_proc257
L_button_proc239:
;main22.c,263 :: 		if (bypas==0) {   // long press button
	MOVF       _bypas+0, 0
	XORLW      0
	BTFSS      STATUS+0, 2
	GOTO       L_button_proc258
;main22.c,264 :: 		Test = 1;
	MOVLW      1
	MOVWF      _Test+0
;main22.c,265 :: 		Auto = 0;
	CLRF       _Auto+0
;main22.c,266 :: 		if(type==4 | type==5) {    // 128*64 OLED
	MOVF       _type+0, 0
	XORLW      4
	MOVLW      1
	BTFSS      STATUS+0, 2
	MOVLW      0
	MOVWF      R1
	MOVF       _type+0, 0
	XORLW      5
	MOVLW      1
	BTFSS      STATUS+0, 2
	MOVLW      0
	MOVWF      R0
	MOVF       R1, 0
	IORWF       R0, 1
	BTFSC      STATUS+0, 2
	GOTO       L_button_proc259
;main22.c,267 :: 		led_wr_str (2, 16, "MANUAL  ", 8);
	MOVLW      2
	MOVWF      FARG_led_wr_str+0
	MOVLW      16
	MOVWF      FARG_led_wr_str+0
	MOVLW      ?lstr21_main22+0
	MOVWF      FARG_led_wr_str+0
	MOVLW      hi_addr(?lstr21_main22+0)
	MOVWF      FARG_led_wr_str+1
	MOVLW      8
	MOVWF      FARG_led_wr_str+0
	CALL       _led_wr_str+0
;main22.c,268 :: 		asm CLRWDT;
	CLRWDT
;main22.c,269 :: 		delay_ms(1000);
	MOVLW      21
	MOVWF      R11
	MOVLW      75
	MOVWF      R12
	MOVLW      190
	MOVWF      R13
L_button_proc260:
	DECFSZ     R13, 1
	GOTO       L_button_proc260
	DECFSZ     R12, 1
	GOTO       L_button_proc260
	DECFSZ     R11, 1
	GOTO       L_button_proc260
	NOP
;main22.c,270 :: 		led_wr_str (2, 16, "SWR=0.00", 8);
	MOVLW      2
	MOVWF      FARG_led_wr_str+0
	MOVLW      16
	MOVWF      FARG_led_wr_str+0
	MOVLW      ?lstr22_main22+0
	MOVWF      FARG_led_wr_str+0
	MOVLW      hi_addr(?lstr22_main22+0)
	MOVWF      FARG_led_wr_str+1
	MOVLW      8
	MOVWF      FARG_led_wr_str+0
	CALL       _led_wr_str+0
;main22.c,271 :: 		led_wr_str (0, 16+8*12, "l", 1);
	CLRF       FARG_led_wr_str+0
	MOVLW      112
	MOVWF      FARG_led_wr_str+0
	MOVLW      ?lstr23_main22+0
	MOVWF      FARG_led_wr_str+0
	MOVLW      hi_addr(?lstr23_main22+0)
	MOVWF      FARG_led_wr_str+1
	MOVLW      1
	MOVWF      FARG_led_wr_str+0
	CALL       _led_wr_str+0
;main22.c,272 :: 		asm CLRWDT;
	CLRWDT
;main22.c,273 :: 		}
	GOTO       L_button_proc261
L_button_proc259:
;main22.c,274 :: 		else if(type!=0) {// 1602 LCD & 128*32 OLED
	MOVF       _type+0, 0
	XORLW      0
	BTFSC      STATUS+0, 2
	GOTO       L_button_proc262
;main22.c,275 :: 		led_wr_str (1, 0, "MANUAL  ", 8);
	MOVLW      1
	MOVWF      FARG_led_wr_str+0
	CLRF       FARG_led_wr_str+0
	MOVLW      ?lstr24_main22+0
	MOVWF      FARG_led_wr_str+0
	MOVLW      hi_addr(?lstr24_main22+0)
	MOVWF      FARG_led_wr_str+1
	MOVLW      8
	MOVWF      FARG_led_wr_str+0
	CALL       _led_wr_str+0
;main22.c,276 :: 		asm CLRWDT;
	CLRWDT
;main22.c,277 :: 		delay_ms(1000);
	MOVLW      21
	MOVWF      R11
	MOVLW      75
	MOVWF      R12
	MOVLW      190
	MOVWF      R13
L_button_proc263:
	DECFSZ     R13, 1
	GOTO       L_button_proc263
	DECFSZ     R12, 1
	GOTO       L_button_proc263
	DECFSZ     R11, 1
	GOTO       L_button_proc263
	NOP
;main22.c,278 :: 		led_wr_str (1, 0, "SWR=0.00", 8);
	MOVLW      1
	MOVWF      FARG_led_wr_str+0
	CLRF       FARG_led_wr_str+0
	MOVLW      ?lstr25_main22+0
	MOVWF      FARG_led_wr_str+0
	MOVLW      hi_addr(?lstr25_main22+0)
	MOVWF      FARG_led_wr_str+1
	MOVLW      8
	MOVWF      FARG_led_wr_str+0
	CALL       _led_wr_str+0
;main22.c,279 :: 		led_wr_str (0, 8, "l", 1);
	CLRF       FARG_led_wr_str+0
	MOVLW      8
	MOVWF      FARG_led_wr_str+0
	MOVLW      ?lstr26_main22+0
	MOVWF      FARG_led_wr_str+0
	MOVLW      hi_addr(?lstr26_main22+0)
	MOVWF      FARG_led_wr_str+1
	MOVLW      1
	MOVWF      FARG_led_wr_str+0
	CALL       _led_wr_str+0
;main22.c,280 :: 		asm CLRWDT;
	CLRWDT
;main22.c,281 :: 		}
L_button_proc262:
L_button_proc261:
;main22.c,282 :: 		}
L_button_proc258:
;main22.c,283 :: 		}
L_button_proc257:
;main22.c,284 :: 		}
L_button_proc237:
;main22.c,286 :: 		if(Button(&PORTB, 1, 50, 0) & Bypas==0){   // Auto button
	MOVLW      PORTB+0
	MOVWF      FARG_Button_port+0
	MOVLW      hi_addr(PORTB+0)
	MOVWF      FARG_Button_port+1
	MOVLW      1
	MOVWF      FARG_Button_pin+0
	MOVLW      50
	MOVWF      FARG_Button_time_ms+0
	CLRF       FARG_Button_active_state+0
	CALL       _Button+0
	MOVF       _bypas+0, 0
	XORLW      0
	MOVLW      1
	BTFSS      STATUS+0, 2
	MOVLW      0
	MOVWF      R1
	MOVF       R1, 0
	ANDWF      R0, 1
	BTFSC      STATUS+0, 2
	GOTO       L_button_proc264
;main22.c,287 :: 		Delay_ms(450);
	MOVLW      10
	MOVWF      R11
	MOVLW      34
	MOVWF      R12
	MOVLW      161
	MOVWF      R13
L_button_proc265:
	DECFSZ     R13, 1
	GOTO       L_button_proc265
	DECFSZ     R12, 1
	GOTO       L_button_proc265
	DECFSZ     R11, 1
	GOTO       L_button_proc265
;main22.c,288 :: 		if(PORTB.B1==1) { // short press button
	BTFSS      PORTB+0, 1
	GOTO       L_button_proc266
;main22.c,289 :: 		dysp_on();
	CALL       _dysp_on+0
;main22.c,290 :: 		dysp_cnt = Dysp_delay * dysp_cnt_mult;
	MOVF       _Dysp_delay+0, 0
	MOVWF      R0
	CALL       _Byte2Double+0
	MOVF       _dysp_cnt_mult+0, 0
	MOVWF      R4
	MOVF       _dysp_cnt_mult+1, 0
	MOVWF      R5
	MOVF       _dysp_cnt_mult+2, 0
	MOVWF      R6
	MOVF       _dysp_cnt_mult+3, 0
	MOVWF      R7
	CALL       _Mul_32x32_FP+0
	CALL       _Double2Int+0
	MOVF       R0, 0
	MOVWF      _dysp_cnt+0
	MOVF       R1, 0
	MOVWF      _dysp_cnt+1
;main22.c,291 :: 		asm CLRWDT;
	CLRWDT
;main22.c,292 :: 		if(Auto == 0) Auto = 1;
	MOVF       _Auto+0, 0
	XORLW      0
	BTFSS      STATUS+0, 2
	GOTO       L_button_proc267
	MOVLW      1
	MOVWF      _Auto+0
	GOTO       L_button_proc268
L_button_proc267:
;main22.c,293 :: 		else Auto = 0;
	CLRF       _Auto+0
L_button_proc268:
;main22.c,294 :: 		EEPROM_Write(2, Auto);
	MOVLW      2
	MOVWF      FARG_EEPROM_Write_Address+0
	MOVF       _Auto+0, 0
	MOVWF      FARG_EEPROM_Write_data_+0
	CALL       _EEPROM_Write+0
;main22.c,295 :: 		if(type==4 | type==5) {      // 128*64 OLED
	MOVF       _type+0, 0
	XORLW      4
	MOVLW      1
	BTFSS      STATUS+0, 2
	MOVLW      0
	MOVWF      R1
	MOVF       _type+0, 0
	XORLW      5
	MOVLW      1
	BTFSS      STATUS+0, 2
	MOVLW      0
	MOVWF      R0
	MOVF       R1, 0
	IORWF       R0, 1
	BTFSC      STATUS+0, 2
	GOTO       L_button_proc269
;main22.c,296 :: 		if(Auto & !Bypas) led_wr_str (0, 16+8*12, ".", 1);
	MOVF       _bypas+0, 0
	MOVLW      1
	BTFSS      STATUS+0, 2
	MOVLW      0
	MOVWF      R0
	MOVF       _Auto+0, 0
	ANDWF      R0, 1
	BTFSC      STATUS+0, 2
	GOTO       L_button_proc270
	CLRF       FARG_led_wr_str+0
	MOVLW      112
	MOVWF      FARG_led_wr_str+0
	MOVLW      ?lstr27_main22+0
	MOVWF      FARG_led_wr_str+0
	MOVLW      hi_addr(?lstr27_main22+0)
	MOVWF      FARG_led_wr_str+1
	MOVLW      1
	MOVWF      FARG_led_wr_str+0
	CALL       _led_wr_str+0
	GOTO       L_button_proc271
L_button_proc270:
;main22.c,297 :: 		else if(!Auto & Bypas) led_wr_str (0, 16+8*12, "_", 1);
	MOVF       _Auto+0, 0
	MOVLW      1
	BTFSS      STATUS+0, 2
	MOVLW      0
	MOVWF      R0
	MOVF       _bypas+0, 0
	ANDWF      R0, 1
	BTFSC      STATUS+0, 2
	GOTO       L_button_proc272
	CLRF       FARG_led_wr_str+0
	MOVLW      112
	MOVWF      FARG_led_wr_str+0
	MOVLW      ?lstr28_main22+0
	MOVWF      FARG_led_wr_str+0
	MOVLW      hi_addr(?lstr28_main22+0)
	MOVWF      FARG_led_wr_str+1
	MOVLW      1
	MOVWF      FARG_led_wr_str+0
	CALL       _led_wr_str+0
	GOTO       L_button_proc273
L_button_proc272:
;main22.c,298 :: 		else led_wr_str (0, 16+8*12, " ", 1);
	CLRF       FARG_led_wr_str+0
	MOVLW      112
	MOVWF      FARG_led_wr_str+0
	MOVLW      ?lstr29_main22+0
	MOVWF      FARG_led_wr_str+0
	MOVLW      hi_addr(?lstr29_main22+0)
	MOVWF      FARG_led_wr_str+1
	MOVLW      1
	MOVWF      FARG_led_wr_str+0
	CALL       _led_wr_str+0
L_button_proc273:
L_button_proc271:
;main22.c,299 :: 		}
	GOTO       L_button_proc274
L_button_proc269:
;main22.c,300 :: 		else if(type!=0) { //  1602 LCD  or 128*32 OLED
	MOVF       _type+0, 0
	XORLW      0
	BTFSC      STATUS+0, 2
	GOTO       L_button_proc275
;main22.c,301 :: 		if(Auto & !Bypas) led_wr_str (0, 8, ".", 1);
	MOVF       _bypas+0, 0
	MOVLW      1
	BTFSS      STATUS+0, 2
	MOVLW      0
	MOVWF      R0
	MOVF       _Auto+0, 0
	ANDWF      R0, 1
	BTFSC      STATUS+0, 2
	GOTO       L_button_proc276
	CLRF       FARG_led_wr_str+0
	MOVLW      8
	MOVWF      FARG_led_wr_str+0
	MOVLW      ?lstr30_main22+0
	MOVWF      FARG_led_wr_str+0
	MOVLW      hi_addr(?lstr30_main22+0)
	MOVWF      FARG_led_wr_str+1
	MOVLW      1
	MOVWF      FARG_led_wr_str+0
	CALL       _led_wr_str+0
	GOTO       L_button_proc277
L_button_proc276:
;main22.c,302 :: 		else if(!Auto & Bypas) led_wr_str (0, 8, "_", 1);
	MOVF       _Auto+0, 0
	MOVLW      1
	BTFSS      STATUS+0, 2
	MOVLW      0
	MOVWF      R0
	MOVF       _bypas+0, 0
	ANDWF      R0, 1
	BTFSC      STATUS+0, 2
	GOTO       L_button_proc278
	CLRF       FARG_led_wr_str+0
	MOVLW      8
	MOVWF      FARG_led_wr_str+0
	MOVLW      ?lstr31_main22+0
	MOVWF      FARG_led_wr_str+0
	MOVLW      hi_addr(?lstr31_main22+0)
	MOVWF      FARG_led_wr_str+1
	MOVLW      1
	MOVWF      FARG_led_wr_str+0
	CALL       _led_wr_str+0
	GOTO       L_button_proc279
L_button_proc278:
;main22.c,303 :: 		else led_wr_str (0, 8, " ", 1);
	CLRF       FARG_led_wr_str+0
	MOVLW      8
	MOVWF      FARG_led_wr_str+0
	MOVLW      ?lstr32_main22+0
	MOVWF      FARG_led_wr_str+0
	MOVLW      hi_addr(?lstr32_main22+0)
	MOVWF      FARG_led_wr_str+1
	MOVLW      1
	MOVWF      FARG_led_wr_str+0
	CALL       _led_wr_str+0
L_button_proc279:
L_button_proc277:
;main22.c,304 :: 		}
L_button_proc275:
L_button_proc274:
;main22.c,305 :: 		asm CLRWDT;
	CLRWDT
;main22.c,306 :: 		while(Button(&PORTB, 1, 50, 0)) {lcd_pwr(); asm CLRWDT; }
L_button_proc280:
	MOVLW      PORTB+0
	MOVWF      FARG_Button_port+0
	MOVLW      hi_addr(PORTB+0)
	MOVWF      FARG_Button_port+1
	MOVLW      1
	MOVWF      FARG_Button_pin+0
	MOVLW      50
	MOVWF      FARG_Button_time_ms+0
	CLRF       FARG_Button_active_state+0
	CALL       _Button+0
	MOVF       R0, 0
	BTFSC      STATUS+0, 2
	GOTO       L_button_proc281
	CALL       _lcd_pwr+0
	CLRWDT
	GOTO       L_button_proc280
L_button_proc281:
;main22.c,307 :: 		}
	GOTO       L_button_proc282
L_button_proc266:
;main22.c,310 :: 		user_setup();
	CALL       _user_setup+0
;main22.c,311 :: 		}
L_button_proc282:
;main22.c,313 :: 		}
L_button_proc264:
;main22.c,314 :: 		return;
;main22.c,315 :: 		}
L_end_button_proc:
	RETURN
; end of _button_proc

_show_reset:
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
