r3tjl/N7DDC-ATU-100-mini-and-extended-boards/(commit log)

2020-10-29 Create ATU-100_FS-мой с кнопками.lay6
    [ATU-100_FS-мой с кнопками.lay6]
2020-11-06 Pull V3.3
    [atu_100_fw_00.cfg]
2020-11-09 Add Source & hex to v3.4, add new lay for plate 7x7
    [atu_100_fw_00.cfg]
